asathyanesan/Neuroinjector/validation/verification_sheet.csv

region | pmid | ccf_region | region_verbatim | ap_mm | ml_mm | dv_mm | reference | atlas_ap | atlas_dv | quote_supports_numbers | coord_correct | is_outlier | outlier_reason | auto_verdict | reviewer_confirms | reviewer_notes | pubmed_url | pmc_url | source_quote | ml_mm_reparsed | ml_bilateral | ml_confidence | ml_candidates | ap_reparsed | dv_reparsed | reparse_flag | orig_ml_mm
ACB | 19303923 | nucleus accumbens, shell | lateral accumbens shell | 1.3 | 3.1 | -7.5 | bregma | 1.16 | 5.37 | partial(2/3) | review | TRUE | DV -12.9mm vs atlas | OUTLIER | y |  | https://pubmed.ncbi.nlm.nih.gov/19303923/ | https://www.ncbi.nlm.nih.gov/pmc/?term=19303923 | For subsequent experiments, cannulae were inserted bilaterally into the ventral tegmental area, caudate putamen, nucleus accumbens lateral shell or nucleus accumbens core. The following stereotaxic coordinates were utilized: lateral accumbens shell: A/P 1.3, M/L ±3.1, V −7.5; | 3.1 | yes | high | 3.1 | 1.3 |  | ML_recovered | 0
ACB | 19303923 | nucleus accumbens, core | nucleus accumbens core | 1.7 | 1.5 | -6.8 | bregma | 1.16 | 5.37 | partial(2/3) | review | TRUE | DV -12.2mm vs atlas | OUTLIER | y |  | https://pubmed.ncbi.nlm.nih.gov/19303923/ | https://www.ncbi.nlm.nih.gov/pmc/?term=19303923 | For subsequent experiments, cannulae were inserted bilaterally into the ventral tegmental area, caudate putamen, nucleus accumbens lateral shell or nucleus accumbens core. The following stereotaxic coordinates were utilized: nucleus accumbens core: A/P 1.7, M/L ±1.5, V −6.8; | 1.5 | yes | high | 1.5 | 1.7 |  | ML_recovered | 0
ACB | 20092560 | Nucleus accumbens, core | nucleus accumbens core (AcbC) | 1.4 | 1.26 | -4.2 | bregma | 1.16 | 5.37 | partial(2/3) | review | TRUE | DV -9.6mm vs atlas | OUTLIER | y |  | https://pubmed.ncbi.nlm.nih.gov/20092560/ | https://www.ncbi.nlm.nih.gov/pmc/?term=20092560 | one cannula was aimed at the nucleus accumbens core (AcbC) (from Bregma: anterior (A) + 1.40, lateral (L) ± 1.26, ventral (V) −4.2) while the second was aimed at the basolateral/central nuclei of the amygdala (BLA/CE) (from Bregma: A – 1.22, L ± 2.85, V – 4.5; Franklin, 2001 ) either ipsi- or contra-lateral to the first. | 1.26 | yes | disambig | 1.26|2.85 |  | -4.2 | ML_recovered_disambig | 0
ACB | 20856811 | Nucleus accumbens | nucleus accumbens | 1.7 | 0.75 | -4.75 | bregma | 1.16 | 5.37 | y | y | TRUE | DV z=10.4 | OUTLIER | n | dv_mm sign changed to -ve | https://pubmed.ncbi.nlm.nih.gov/20856811/ | https://www.ncbi.nlm.nih.gov/pmc/?term=20856811 | For restoration of Th gene function in the nucleus accumbens alone, recombinant CAV2-Cre virus (titered at 2.1×10 12 particles/ml) was injected bilaterally (coordinates in mm: 1.7 anterior to Bregma, 0.75 lateral to midline, 4.75 ventral to Bregma; 0.5 µl/hemisphere) into DD and control mice. | 0.75 |  | low |  |  | 4.75 |  | 0.75
ACB | 20962330 | Nucleus accumbens | NAcc | 1.3 | 0.9 | -4.7 | bregma | 1.16 | 5.37 | partial(2/3) | review | TRUE | DV -10.1mm vs atlas | OUTLIER | y |  | https://pubmed.ncbi.nlm.nih.gov/20962330/ | https://www.ncbi.nlm.nih.gov/pmc/?term=20962330 | After each mouse was placed in a stereotaxic frame, 1 μl of each virus (1×10 12 genomic particles) in PBS was injected into the NAcc (anteroposterior +1.3, mediolateral ±0.9, dorsoventral −4.7 from bregma) over 10 min using a 10-ml Hamilton syringe and an infusion pump (World Precision Instruments). | 0.9 | yes | high | 0.9 | 1.3 | -4.7 | ML_recovered | 0
ACB | 21508225 | Nucleus accumbens, core | nucleus accumbens (NAc) core | 1.2 | 1.5 | -6 | bregma | 1.16 | 5.37 | partial(2/3) | review | TRUE | DV -11.4mm vs atlas | OUTLIER | y |  | https://pubmed.ncbi.nlm.nih.gov/21508225/ | https://www.ncbi.nlm.nih.gov/pmc/?term=21508225 | A 26 gauge bilateral guide cannula (Plastics One, USA) was then implanted, targeting the nucleus accumbens (NAc) core or the NAc shell using the following coordinates (in mm from bregma); L=±1.5;V=−6.0 and AP=+1.2; L=±1.0;V=-5.8 respectively. | 1.5 | yes | disambig | 1|1.5 | 1.2 | -6 | ML_recovered_disambig | 0
ACB | 21508225 | Nucleus accumbens, shell | NAc shell | 1.2 | 1 | -5.8 | bregma | 1.16 | 5.37 | partial(2/3) | review | TRUE | DV -11.2mm vs atlas | OUTLIER | y |  | https://pubmed.ncbi.nlm.nih.gov/21508225/ | https://www.ncbi.nlm.nih.gov/pmc/?term=21508225 | A 26 gauge bilateral guide cannula (Plastics One, USA) was then implanted, targeting the nucleus accumbens (NAc) core or the NAc shell using the following coordinates (in mm from bregma); L=±1.5;V=−6.0 and AP=+1.2; L=±1.0;V=-5.8 respectively. | 1 | yes | disambig | 1|1.5 | 1.2 | -6 | ML_recovered_disambig; DV_diff(csv=-5.8,quote=6) | 0
ACB | 22082989 | Nucleus accumbens | nucleus accumbens | 1.3 | 1.3 | -4.4 | bregma | 1.16 | 5.37 | y | y | TRUE | DV z=10.0 | OUTLIER | n | dv_mm sign changed to -ve | https://pubmed.ncbi.nlm.nih.gov/22082989/ | https://www.ncbi.nlm.nih.gov/pmc/?term=22082989 | Bilateral injection: 0.5 μl was injected into nucleus accumbens at a 10° angle toward the mid-sagittal plane (coordinates in mm: 1.3 anterior, 1.3 lateral; 4.4 ventral to Bregma). All injections were at a rate of 0.1 μl per minute. | 1.3 |  | low |  |  | 4.4 |  | 1.3
ACB | 24847220 | Nucleus accumbens | NAC | 1.3 | 1 | -2.3 | bregma | 1.16 | 5.37 | partial(2/3) | review | TRUE | DV -7.7mm vs atlas | OUTLIER | y |  | https://pubmed.ncbi.nlm.nih.gov/24847220/ | https://www.ncbi.nlm.nih.gov/pmc/?term=24847220 | The animal's skull was exposed, leveled, and holes were drilled based on coordinates from Bregma for the mPFC (AP: +1.8 mm; DV: −1.0 mm) or NAC (AP: +1.3 mm, ML: ±1 mm, DV: −2.3 mm), according to the mouse brain atlas of Paxinos and Franklin ( 2007 ). The guide cannulae were lowered bilaterally such that the tips of the cannulae were 3 mm above the mPFC or border region of the shell and core subregions of the NAC. | 1 | yes | high | 1 | 1.8 | -1 | ML_recovered; AP_diff(csv=1.3,quote=1.8); DV_diff(csv=-2.3,quote=1) | 0
ACB | 25130590 | Nucleus accumbens, shell | nucleus accumbens shell [NACSH] | 1.1 | 0.5 | -4.5 | bregma | 1.16 | 5.37 | partial(2/3) | review | TRUE | DV -9.9mm vs atlas | OUTLIER | y |  | https://pubmed.ncbi.nlm.nih.gov/25130590/ | https://www.ncbi.nlm.nih.gov/pmc/?term=25130590 | Approximately 1 week after arrival, mice in Experiments 3 & 4 underwent surgery to implant bilateral 26-G guide cannulae aimed at the nucleus accumbens shell [NACSH; coordinates in reference to bregma, anterior-posterior (AP): + 1.1 mm; medial-lateral (ML) ± 0.5 mm; dorsal-ventral (DV): − 4.5 mm)] using the Angle II Sterotax (Leica Instruments). Vehicle or 22mM TSA was delivered bilaterally to the NACSH in a volume of 0.5 μl over a 2 min period. | 0.5 | yes | high | 0.5 |  |  | ML_recovered | 0
ACB | 26214370 | Nucleus accumbens, core | NAcore | 1.55 | 1 | -4.8 | bregma | 1.16 | 5.37 | y | review | TRUE | DV -10.2mm vs atlas | OUTLIER | y |  | https://pubmed.ncbi.nlm.nih.gov/26214370/ | https://www.ncbi.nlm.nih.gov/pmc/?term=26214370 | ChR2 was bilaterally infused (0.3 μl) at 0° angle into the NAcore (AP +1.55; ML ±1.00, DV −4.80) | 1 | yes | high | 1 | 1.55 | -4.8 | ML_recovered | 0
ACB | 26471420 | Nucleus accumbens | nucleus accumbens | 1.5 | 0.8 | -3.6 | bregma | 1.16 | 5.37 | y | y | TRUE | DV z=9.1 | OUTLIER | n | dv_mm sign changed to -ve | https://pubmed.ncbi.nlm.nih.gov/26471420/ | https://www.ncbi.nlm.nih.gov/pmc/?term=26471420 | Bilateral guide cannulas from Plastics One were implanted so the tip of the cannulas reached the nucleus accumbens (bregma coordinates: anterior, 1.5mm; mediolateral, 0.8mm; dorsoventral, 3.6mm) or ventral hippocampus (bregma coordinates: posterior, 3.2mm; mediolateral, 3.0mm; dorsoventral, 4.2mm). | 0.8 |  | low |  |  | 3.6 |  | 0.8
ACB | 28439227 | Nucleus accumbens | nucleus accumbens | 1.6 | 1 | -3.1 | bregma | 1.16 | 5.37 | partial(2/3) | review | TRUE | DV -8.5mm vs atlas | OUTLIER | y |  | https://pubmed.ncbi.nlm.nih.gov/28439227/ | https://www.ncbi.nlm.nih.gov/pmc/?term=28439227 | for nucleus accumbens coordinates were AP, +1.6; L, ±1; and DV, −3.1; from Bregma in accordance with the atlas of Paxinos and Franklin ( 2013 ). | 1 | yes | high | 1 | 1.6 | -3.1 | ML_recovered | 0
ACB | 29307710 | Nucleus accumbens, medial shell | Nucleus accumbens (NAc) medial shell (NAcMed) | 1.5 | 0.55 | -4.7 | bregma | 1.16 | 5.37 | y | review | TRUE | DV -10.1mm vs atlas | OUTLIER | y |  | https://pubmed.ncbi.nlm.nih.gov/29307710/ | https://www.ncbi.nlm.nih.gov/pmc/?term=29307710 | For red/green fluorescent retrobead labeling, mice were injected unilaterally with fluorescent retrobeads (100 nl; LumaFluor Inc.) in the Nucleus accumbens (NAc) medial shell (NAcMed, bregma: 1.50 mm, lateral: 0.55 mm, ventral: −4.70 mm) and/or NAc lateral shell (NAcLat, bregma: 0.98 mm, lateral: 1.80 mm, ventral: −4.92 mm) using a 1 μl Hamilton syringe (Hamilton). | 0.55 |  | low |  |  | -4.7 |  | 0.55
ACB | 29307710 | Nucleus accumbens, lateral shell | NAc lateral shell (NAcLat) | 0.98 | 1.8 | -4.92 | bregma | 1.16 | 5.37 | y | review | TRUE | DV -10.3mm vs atlas | OUTLIER | y |  | https://pubmed.ncbi.nlm.nih.gov/29307710/ | https://www.ncbi.nlm.nih.gov/pmc/?term=29307710 | For red/green fluorescent retrobead labeling, mice were injected unilaterally with fluorescent retrobeads (100 nl; LumaFluor Inc.) in the Nucleus accumbens (NAc) medial shell (NAcMed, bregma: 1.50 mm, lateral: 0.55 mm, ventral: −4.70 mm) and/or NAc lateral shell (NAcLat, bregma: 0.98 mm, lateral: 1.80 mm, ventral: −4.92 mm) using a 1 μl Hamilton syringe (Hamilton). | 0.55 |  | low |  |  | -4.7 | ML_mismatch(csv=1.8,quote=0.55); DV_diff(csv=-4.92,quote=4.7) | 1.8
ACB | 29458998 | Nucleus accumbens | nucleus accumbens (NAc) | 1.65 | 0.92 | -4.8 | bregma | 1.16 | 5.37 | y | y | TRUE | DV z=10.5 | OUTLIER | n | dv_mm sign changed to -ve | https://pubmed.ncbi.nlm.nih.gov/29458998/ | https://www.ncbi.nlm.nih.gov/pmc/?term=29458998 | AAV5.CMV.HI.eGFP.Cre.WPRE.SV40 (AAV-Cre; titer 2 × 10 13 GC/ml) or AAV5.CMV.PI.eGFP.WPRE.bGH (AAV-GFP; titer 7 × 10 13 GC/ml) were injected bilaterally into the dorsal striatum (500 nl, AP: 0.62, ML: 1.90, DV: 3.00) or nucleus accumbens (NAc; 450 nl, AP: 1.65, ML: 0.92, DV: 4.80). | 1.9 |  | low |  | 0.62 | 3 | ML_mismatch(csv=0.92,quote=1.9); AP_diff(csv=1.65,quote=0.62); DV_diff(csv=4.8,quote=3) | 0.92
ACB | 29477921 | Nucleus accumbens, core | NAc core | 1.2 | 1 | -4.5 | bregma | 1.16 | 5.37 | y | y | TRUE | DV z=10.1 | OUTLIER | n | dv_mm sign changed to -ve | https://pubmed.ncbi.nlm.nih.gov/29477921/ | https://www.ncbi.nlm.nih.gov/pmc/?term=29477921 | A ten-microliter syringe (Hamilton, Reno, NV) was used to deliver 1μL of LV (4.1 × 10 7 to 5.3 × 10 9 IU/mL) to each NAc (bregma coordinates: anteriorposterior 1.2 mm; mediolateral 1.0 mm; dorsoventral 4.5 mm) at a rate of 0.1 μL/min. Second, to gain insights into the changes in ethanol intake, we employed a lentivirus-shRNA (LV-shRNA) methodology to selectively knockdown P2X4R expression in the nucleus accumbens (NAc) core in male C57BL/6J mice. | 1 |  | low |  | 1.2 | 4.5 |  | 1
ACB | 31660086 | Nucleus accumbens | NAc | 1.54 | 0.8 | -3.9 | bregma | 1.16 | 5.37 | partial(2/3) | review | TRUE | DV -9.3mm vs atlas | OUTLIER | y | "0.5 mm above the Nac" | https://pubmed.ncbi.nlm.nih.gov/31660086/ | https://www.ncbi.nlm.nih.gov/pmc/?term=31660086 | Then, mice were bilaterally implanted with 26-gauge guide cannulae (RWD Life Science Co., Ltd.) located 0.5 mm above the NAc at the following coordinates: anteroposterior (AP), +1.54 mm; mediolateral (ML), ±0.80 mm; dorsoventral (DV), -3.90 mm. NSC23766 (10 µg/μl, 1 µl/side), CN04 (424 nmol/ml, 1 µl/side) or vehicle (1 µl/side) was infused into the bilateral NAc at… | 0.8 | yes | high | 0.8 | 1.54 | -3.9 | ML_recovered | 0
ACB | 31668382 | Nucleus accumbens | rostral accumbens | 1.6 | 0.6 | -4.25 | bregma | 1.16 | 5.37 | partial(1/3) | review | TRUE | DV -9.9mm vs atlas | OUTLIER | n | multiple bregma locations disentangled and corrected | https://pubmed.ncbi.nlm.nih.gov/31668382/ | https://www.ncbi.nlm.nih.gov/pmc/?term=31668382 | We bilaterally delivered a total of 800 nl (400 nl per hemisphere) of an adeno-associated viral vector (University of North Carolina Gene Therapy Center, Chapel Hill, NC) encoding either Cre recombinase-mCherry (AAV8-hSyn-CRE-mCherry, 2.8 × 10 12 genomic copies/ml) or mCherry only (AAV8-hSyn-mCherry, 8.0 × 10 12 genomic copies/ml) to the rostral (anteroposterior (AP) +1.60, mediolateral (ML) ±0.60 and ± 1.40, dorsoventral (DV) −4.25 and −4.75) and caudal accumbens (AP +1.20, ML ±0.60 and ± 1.50, DV –4.30 and −4.80) using mouse atlas coordinates [27] . | 0.6 | yes | disambig | 0.6|1.4|1.5 | 1.6 | -4.25 | ML_mismatch(csv=1,quote=0.6); DV_diff(csv=-4.5,quote=4.25) | 1
ACB | 31668382 | Nucleus accumbens | rostral accumbens | 1.6 | 1.4 | -4.75 | bregma | 1.16 | 5.37 | partial(1/3) | review | TRUE | DV -9.9mm vs atlas | OUTLIER | n | multiple bregma locations disentangled and corrected | https://pubmed.ncbi.nlm.nih.gov/31668382/ | https://www.ncbi.nlm.nih.gov/pmc/?term=31668382 | We bilaterally delivered a total of 800 nl (400 nl per hemisphere) of an adeno-associated viral vector (University of North Carolina Gene Therapy Center, Chapel Hill, NC) encoding either Cre recombinase-mCherry (AAV8-hSyn-CRE-mCherry, 2.8 × 10 12 genomic copies/ml) or mCherry only (AAV8-hSyn-mCherry, 8.0 × 10 12 genomic copies/ml) to the rostral (anteroposterior (AP) +1.60, mediolateral (ML) ±0.60 and ± 1.40, dorsoventral (DV) −4.25 and −4.75) and caudal accumbens (AP +1.20, ML ±0.60 and ± 1.50, DV –4.30 and −4.80) using mouse atlas coordinates [27] . | 0.6 | yes | disambig | 0.6|1.4|1.5 | 1.6 | -4.25 | ML_mismatch(csv=1,quote=0.6); DV_diff(csv=-4.5,quote=4.25) | 1
ACB | 31668382 | Nucleus accumbens | caudal accumbens | 1.2 | 0.6 | -4.3 | bregma | 1.16 | 5.37 | partial(1/3) | review | TRUE | DV -9.9mm vs atlas | OUTLIER | n | multiple bregma locations disentangled and corrected | https://pubmed.ncbi.nlm.nih.gov/31668382/ | https://www.ncbi.nlm.nih.gov/pmc/?term=31668382 | We bilaterally delivered a total of 800 nl (400 nl per hemisphere) of an adeno-associated viral vector (University of North Carolina Gene Therapy Center, Chapel Hill, NC) encoding either Cre recombinase-mCherry (AAV8-hSyn-CRE-mCherry, 2.8 × 10 12 genomic copies/ml) or mCherry only (AAV8-hSyn-mCherry, 8.0 × 10 12 genomic copies/ml) to the rostral (anteroposterior (AP) +1.60, mediolateral (ML) ±0.60 and ± 1.40, dorsoventral (DV) −4.25 and −4.75) and caudal accumbens (AP +1.20, ML ±0.60 and ± 1.50, DV –4.30 and −4.80) using mouse atlas coordinates [27] . | 0.6 | yes | disambig | 0.6|1.4|1.5 | 1.6 | -4.25 | ML_mismatch(csv=1.05,quote=0.6); AP_diff(csv=1.2,quote=1.6); DV_diff(csv=-4.55,quote=4.25) | 1.05
ACB | 31668382 | Nucleus accumbens | caudal accumbens | 1.2 | 1.5 | -4.8 | bregma | 1.16 | 5.37 | partial(1/3) | review | TRUE | DV -9.9mm vs atlas | OUTLIER | n | multiple bregma locations disentangled and corrected | https://pubmed.ncbi.nlm.nih.gov/31668382/ | https://www.ncbi.nlm.nih.gov/pmc/?term=31668382 | We bilaterally delivered a total of 800 nl (400 nl per hemisphere) of an adeno-associated viral vector (University of North Carolina Gene Therapy Center, Chapel Hill, NC) encoding either Cre recombinase-mCherry (AAV8-hSyn-CRE-mCherry, 2.8 × 10 12 genomic copies/ml) or mCherry only (AAV8-hSyn-mCherry, 8.0 × 10 12 genomic copies/ml) to the rostral (anteroposterior (AP) +1.60, mediolateral (ML) ±0.60 and ± 1.40, dorsoventral (DV) −4.25 and −4.75) and caudal accumbens (AP +1.20, ML ±0.60 and ± 1.50, DV –4.30 and −4.80) using mouse atlas coordinates [27] . | 0.6 | yes | disambig | 0.6|1.4|1.5 | 1.6 | -4.25 | ML_mismatch(csv=1.05,quote=0.6); AP_diff(csv=1.2,quote=1.6); DV_diff(csv=-4.55,quote=4.25) | 1.05
ACB | 31954621 | Nucleus accumbens, core | NAc core astrocytes | 1.5 | 0.75 | -4.5 | bregma | 1.16 | 5.37 | partial(2/3) | review | TRUE | DV -9.9mm vs atlas | OUTLIER | y |  | https://pubmed.ncbi.nlm.nih.gov/31954621/ | https://www.ncbi.nlm.nih.gov/pmc/?term=31954621 | Viral vectors (0.5 μl-1 μl) were injected bilaterally using a Hamilton syringe attached to a 29-gauge needle at a rate of 0.8–1.25 μl/min. The viral constructs AAV8-GFAP-hM3D(Gq)-mCherry (UNC vector core), AAV8-GFAP-mCherry (UMN vector core), AAV5-GfaABC1D-PI-LckGCaMP6.SV40 (Penn Vector Core), or AAV5-GfaABC1D-cytoGCaMP6f-SV40 (Penn Vector Core) were targeted to NAc core astrocytes (anterior-poste- rior[AP]: +1.50 mm; medial-lateral [ML]: +/− 0.75 mm; dorsal-ventral [DV]: −4.50 mm) of C57BL/6J. | 0.75 | yes | high | 0.75 | 1.5 | -4.5 | ML_recovered | 0
ACB | 32187537 | Nucleus accumbens shell | Nucleus accumbens (medial shell) | 1.1 | 0.9 | -4.6 | bregma | 1.16 | 5.37 | y | review | TRUE | DV -10.0mm vs atlas | OUTLIER | y |  | https://pubmed.ncbi.nlm.nih.gov/32187537/ | https://www.ncbi.nlm.nih.gov/pmc/?term=32187537 | AP, ML and DV were measured relative to bregma, and craniotomies were drilled over the injection sites. Viruses were injected with a Nanoject II (Drummond Scientific) at a rate of 13.8 nL every 10 s. The following coordinates (in mm) were used: Injection site ML AP DV Nucleus accumbens (medial shell): 0.9 +1.1 −4.6 |  |  | none |  |  |  |  | 0.9
ACB | 32313025 | Nucleus accumbens | NAc | 1.3 | 1.3 | -4.5 | bregma | 1.16 | 5.37 | partial(2/3) | review | TRUE | DV -9.9mm vs atlas | OUTLIER | y |  | https://pubmed.ncbi.nlm.nih.gov/32313025/ | https://www.ncbi.nlm.nih.gov/pmc/?term=32313025 | Following anesthesia with pentobarbital (30 mg kg −1 ), we performed bilateral stereotaxic injections of AAV-GFP or AAV-GFP-Cre (2.6 × 10 9 GS per injection) in the NAc at the following coordinates 64 from the bregma (millimeters), anteroposterior, 1.3, lateral, ±1.3, and dorsoventral, −4.5 | 1.3 | yes | high | 1.3 | 1.3 | -4.5 | ML_recovered | 0
CA1 | 21228185 | Field CA1, dorsal part | dorsal CA1 area of the hippocampus | -2 | 1.5 | -1.5 | bregma | -2.66 | 2.61 | partial(2/3) | review | TRUE | DV -4.1mm vs atlas | OUTLIER | y |  | https://pubmed.ncbi.nlm.nih.gov/21228185/ | https://www.ncbi.nlm.nih.gov/pmc/?term=21228185 | Virus (1.0 μl) was injected at a rate of 6 μl/h via an infusion needle positioned in the dorsal CA1 area of the hippocampus [anteroposterior (AP), −2.0 mm; mediolateral (ML), ±1.5 mm; dorsoventral (DV), −1.5 mm]. | 1.5 | yes | high | 1.5 | -2 | -1.5 | ML_recovered | 0
CA1 | 24656815 | Field CA1 | dorsal hippocampal CA1 | -1.94 | 1.4 | -1.35 | bregma | -2.66 | 2.61 | y | review | TRUE | DV -4.0mm vs atlas | OUTLIER | y |  | https://pubmed.ncbi.nlm.nih.gov/24656815/ | https://www.ncbi.nlm.nih.gov/pmc/?term=24656815 | The coordinates targeting dorsal hippocampal CA1 were anteroposterior −1.94 mm, lateromedial −1.40 mm; dorsoventral −1.35 mm. A total of 0.1 ul of the helper virus (AAV8-EF1α-FLEX-HB, ~2 × 10 11 genome units per ml) was injected into each brain. After 3 weeks of the AAV injection, the pseudotyped, RG-deleted rabies virus (EnvA-SADΔG-mCherry, 0.1 ul, ~2 × 10 9 infectious units per ml) was injected into the same location of the previous injection. |  |  | none |  | -1.94 | -1.35 |  | 1.4
CA1 | 25043327 | Field CA1 | Dorsal CA1 | -2 | 1.6 | -1.7 | bregma | -2.66 | 2.61 | partial(2/3) | review | TRUE | DV -4.3mm vs atlas | OUTLIER | y |  | https://pubmed.ncbi.nlm.nih.gov/25043327/ | https://www.ncbi.nlm.nih.gov/pmc/?term=25043327 | 1μl of virus (titered at 1.45e13 vg/mL) was injected on each side of the hippocampus at a rate of 0.06 μl/min using the following coordinates: Dorsal CA1: anterioposterior: −2.0mm from bregma, lateral: ±1.6mm, ventral: −1.7mm and/or Ventral CA1: anterioposterior: −2.5mm from bregma, lateral: ± 2.5mm, ventral: −1.75mm using a stereotaxic frame (BENCHmark). | 1.6 | yes | disambig | 1.6|2.5 |  | -1.7 | ML_recovered_disambig | 0
CA1 | 25043327 | Field CA1 | Ventral CA1 | -2.5 | 1.6 | -1.75 | bregma | -2.66 | 2.61 | partial(2/3) | review | TRUE | DV -4.4mm vs atlas | OUTLIER | y |  | https://pubmed.ncbi.nlm.nih.gov/25043327/ | https://www.ncbi.nlm.nih.gov/pmc/?term=25043327 | 1μl of virus (titered at 1.45e13 vg/mL) was injected on each side of the hippocampus at a rate of 0.06 μl/min using the following coordinates: Dorsal CA1: anterioposterior: −2.0mm from bregma, lateral: ±1.6mm, ventral: −1.7mm and/or Ventral CA1: anterioposterior: −2.5mm from bregma, lateral: ± 2.5mm, ventral: −1.75mm using a stereotaxic frame (BENCHmark). | 1.6 | yes | disambig | 1.6|2.5 |  | -1.7 | ML_recovered_disambig | 0
CA1 | 25793741 | Field CA1, ventral part | vHP | -8.7 | 2 | -3.5 | bregma | -2.66 | 2.61 | y | review | TRUE | AP z=-16.9; AP -6.0mm vs atlas | OUTLIER | n | reject since this was a unique procedure from a weird angle at the back of the brain | https://pubmed.ncbi.nlm.nih.gov/25793741/ | https://www.ncbi.nlm.nih.gov/pmc/?term=25793741 | For illumination at the vHP, through a craniotomy (AP −8.7, ML −2.0, DV +3.5 in mm), an optical fiber w… | 2 |  | low |  | -8.7 | 3.5 |  | 2
CA1 | 26275606 | Field CA1 | CA1 area (stratum pyramidale) of hippocampus | -2 | 2.6 | -1.9 | bregma | -2.66 | 2.61 | y | review | TRUE | DV -4.5mm vs atlas | OUTLIER | y |  | https://pubmed.ncbi.nlm.nih.gov/26275606/ | https://www.ncbi.nlm.nih.gov/pmc/?term=26275606 | The stereotaxic injections of AAV1-mSTIM2 virus or Aβ42 oligomers in CA1 area (stratum pyramidale) of hippocampus were performed as described previously [ 10 ]. Mice were injected with 5 ul of Aβ42-Alexa555 oligomer, prepared as described above. Additionally, 1 μl of AAV1-mSTIM2 virus was injected each side. For bilateral hippocampus injection, the Hamilton injection syringes were positioned at a 10 ° angle on both sides and the optimal injection coordinates (from bregma) were anterior/posterior (AP) -2.0 mm, lateral +2.6 mm, dorsal/ventral-1.9 mm. | 2.6 |  | low |  | -2 | -1.9 |  | 2.6
CA1 | 27924869 | Field CA1 | hippocampal CA1 | -2.06 | 1.65 | -0.3 | bregma | -2.66 | 2.61 | y | review | TRUE | DV -2.9mm vs atlas | OUTLIER | y | "0.50 mm above the targeted region" - cannula guide placement | https://pubmed.ncbi.nlm.nih.gov/27924869/ | https://www.ncbi.nlm.nih.gov/pmc/?term=27924869 | Animals anaesthetized with 1% pentobarbital sodium and placed in a stereotaxic apparatus (RWD Life Science) were implanted bilaterally with a 26-Gauge guide cannula aimed at 0.50 mm above the targeted region on each side following the coordinates 64 below: insular cortex: anteroposterior, +0.98 mm; lateral, ±3.55 mm; dorsoventral, –3.20 mm; hippocampal CA1: anteroposterior, –2.06 mm; lateral, ±1.65 mm; dorsoventral, –0.30 mm. | 1.65 | yes | disambig | 1.65|3.55 | 0.98 | -3.2 | AP_diff(csv=-2.06,quote=0.98); DV_diff(csv=-0.3,quote=3.2) | 1.65
CA1 | 28486943 | Field CA1 | right and left dorsal hippocampal CA1 region | -3.3 | 2 | -2.6 | bregma | -2.66 | 2.61 | partial(2/3) | review | TRUE | DV -5.2mm vs atlas | OUTLIER | y |  | https://pubmed.ncbi.nlm.nih.gov/28486943/ | https://www.ncbi.nlm.nih.gov/pmc/?term=28486943 | According to Paxinos and Watson [ 60 ] and considering Bregma point as a reference, one stainless steel guide cannula (22 Gauge and 13 mm of length) was settled in the right lateral ventricle (RLV; Coordinates in mm: Anteroposterior (AP): −0.8, Lateral (L): −1.4, and Ventral (V): −0.5), and four copper electrodes (250 μm of diameter) were positioned in the right and left dorsal hippocampal CA1 region (Coordinates in mm: AP: −3.3, L: ±2, and V: −2.6)... | 2 | yes | high | 2 | -0.8 | -0.5 | ML_recovered; AP_diff(csv=-3.3,quote=-0.8); DV_diff(csv=-2.6,quote=0.5) | 0
CA1 | 30405352 | Field CA1 | CA1 region of dorsal hippocampus | -1.8 | 1 | -1.4 | bregma | -2.66 | 2.61 | y | review | TRUE | DV -4.0mm vs atlas | OUTLIER | y |  | https://pubmed.ncbi.nlm.nih.gov/30405352/ | https://www.ncbi.nlm.nih.gov/pmc/?term=30405352 | The skull was exposed and four holes were drilled above the CA1 region of dorsal hippocampus, according to the following coordinates: AP -1.8 mm, ML ± 1 mm, DV -1.4 mm from bregma and AP -2.5 mm, ML ± 2 mm, DV -1.7 mm from bregma. High titers (1.3 × 10 13 GC/ml, Vector Biolabs) adeno-associated virus (AAV) engineered to overexpress Kcnmb2 (AAV1-hSYN1- mKcnmb2 -IRES-GFP-WPRE, AAV-Kcnmb2) or control virus (AAV1-hSYN1-GFP-WPRE, AAV-control) were stereotaxically injected into the dorsal CA1 region with Nanoliter 2010 (WPI) at a flow rate of 0.05 μl/min and a volume of 0.3 μl per injection site. | 1 | yes | disambig | 1|2 | -1.8 | -1.4 | ML_recovered_disambig | 0
CA1 | 30405352 | Field CA1 | CA1 region of dorsal hippocampus | -2.5 | 2 | -1.7 | bregma | -2.66 | 2.61 | y | review | TRUE | DV -4.3mm vs atlas | OUTLIER | y |  | https://pubmed.ncbi.nlm.nih.gov/30405352/ | https://www.ncbi.nlm.nih.gov/pmc/?term=30405352 | The skull was exposed and four holes were drilled above the CA1 region of dorsal hippocampus, according to the following coordinates: AP -1.8 mm, ML ± 1 mm, DV -1.4 mm from bregma and AP -2.5 mm, ML ± 2 mm, DV -1.7 mm from bregma. High titers (1.3 × 10 13 GC/ml, Vector Biolabs) adeno-associated virus (AAV) engineered to overexpress Kcnmb2 (AAV1-hSYN1- mKcnmb2 -IRES-GFP-WPRE, AAV-Kcnmb2) or control virus (AAV1-hSYN1-GFP-WPRE, AAV-control) were stereotaxically injected into the dorsal CA1 region with Nanoliter 2010 (WPI) at a flow rate of 0.05 μl/min and a volume of 0.3 μl per injection site. | 2 | yes | disambig | 1|2 | -1.8 | -1.4 | ML_recovered_disambig; AP_diff(csv=-2.5,quote=-1.8); DV_diff(csv=-1.7,quote=1.4) | 0
CA1 | 31937327 | Field CA1 | CA1 area of the hippocampus | -2.7 | 2.5 | -1.75 | bregma | -2.66 | 2.61 | partial(2/3) | review | TRUE | DV -4.4mm vs atlas | OUTLIER | y |  | https://pubmed.ncbi.nlm.nih.gov/31937327/ | https://www.ncbi.nlm.nih.gov/pmc/?term=31937327 | Craniotomies were made bilaterally to target CA1 area of the hippocampus for viral injections (from bregma: anteroposterior − 2.70 mm, lateral ± 2.50 mm, and dorsoventral − 1.75 mm or anteroposterior − 2.56 mm, lateral ± 2.6 mm, and dorsoventral − 1.85 mm). One microliter of each virus suspension was injected into the CA1 area of the hippocampus at a rate of 0.15 μl/min through a Hamilton syringe using a motorized stereotaxic injector (Stoetling Co.). | 2.5 | yes | disambig | 2.5|2.6 |  |  | ML_recovered_disambig | 0
CA1 | 31937327 | Field CA1 | CA1 area of the hippocampus | -2.56 | 2.6 | -1.85 | bregma | -2.66 | 2.61 | partial(2/3) | review | TRUE | DV -4.5mm vs atlas | OUTLIER | y |  | https://pubmed.ncbi.nlm.nih.gov/31937327/ | https://www.ncbi.nlm.nih.gov/pmc/?term=31937327 | Craniotomies were made bilaterally to target CA1 area of the hippocampus for viral injections (from bregma: anteroposterior − 2.70 mm, lateral ± 2.50 mm, and dorsoventral − 1.75 mm or anteroposterior − 2.56 mm, lateral ± 2.6 mm, and dorsoventral − 1.85 mm). One microliter of each virus suspension was injected into the CA1 area of the hippocampus at a rate of 0.15 μl/min through a Hamilton syringe using a motorized stereotaxic injector (Stoetling Co.). | 2.6 | yes | disambig | 2.5|2.6 |  |  | ML_recovered_disambig | 0
CA1 | 32169587 | Field CA1 | CA1 and Dentate Gyrus (DG) of the dorsal hippocampus | -2.2 | 2.5 | -2.1 | bregma | -2.66 | 2.61 | y | review | TRUE | DV -4.7mm vs atlas | OUTLIER | y |  | https://pubmed.ncbi.nlm.nih.gov/32169587/ | https://www.ncbi.nlm.nih.gov/pmc/?term=32169587 | Thirty gauge needles (Hamilton Company) were bilaterally placed using two sets of stereotaxic coordinates that both target the CA1 and Dentate Gyrus (DG) of the dorsal hippocampus ( Fig 1A ). 10° angle from the midline −2.2 mm anteroposterior, +/− 2.5 mm mediolateral. Purified high-tilter virus (0.6 μL) was infused separately (0.3 μL/infusion) over 5 min periods at two sites: −2.1 mm dorsoventral (DV) and −1.9 mm DV. | 2.5 | yes | high | 2.5 | 2.5 | -2.1 | AP_diff(csv=-2.2,quote=2.5) | 2.5
CA1 | 32169587 | Field CA1 | CA1 and Dentate Gyrus (DG) of the dorsal hippocampus | -2.2 | 2.5 | -1.9 | bregma | -2.66 | 2.61 | y | review | TRUE | DV -4.5mm vs atlas | OUTLIER | y |  | https://pubmed.ncbi.nlm.nih.gov/32169587/ | https://www.ncbi.nlm.nih.gov/pmc/?term=32169587 | Thirty gauge needles (Hamilton Company) were bilaterally placed using two sets of stereotaxic coordinates that both target the CA1 and Dentate Gyrus (DG) of the dorsal hippocampus ( Fig 1A ). 10° angle from the midline −2.2 mm anteroposterior, +/− 2.5 mm mediolateral. Purified high-tilter virus (0.6 μL) was infused separately (0.3 μL/infusion) over 5 min periods at two sites: −2.1 mm dorsoventral (DV) and −1.9 mm DV. | 2.5 | yes | high | 2.5 | 2.5 | -2.1 | AP_diff(csv=-2.2,quote=2.5); DV_diff(csv=-1.9,quote=2.1) | 2.5
CA1 | 32344594 | Field CA1 | CA1 | -1.9 | -1.4 | -1.3 | bregma | -2.66 | 2.61 | y | review | TRUE | DV -3.9mm vs atlas | OUTLIER | n | the -ve sign was missing from ml; only left (-ve coord) was included | https://pubmed.ncbi.nlm.nih.gov/32344594/ | https://www.ncbi.nlm.nih.gov/pmc/?term=32344594 | 500 nl of rAAV viral particles (carrying AAV- CAG -NES-FGCaMP7) was injected through a 50 µm tip diameter glass micropipette (Wiretrol I, 5-000-1001, Drummond, Broomall, PA, USA) into two areas of the hippocampus: CA1 (left hemisphere; stereotaxic coordinates:−1.9 mm A/P from bregma, −1.4 mm M/L, −1.3 mm D/V) or DG (left hemisphere: stereotaxic coordinates: −2.0 mm A/P from bregma, −1.6 mm M/L, −2.0 D/V). Microinjections were performed using UltraMicroPump with Micro4 Controller (WPI Inc., Sarasota, IL, USA) at a rate of 100 nl/min. | 1.3 |  | low |  | -1.9 | -1.3 | ML_mismatch(csv=1.4,quote=1.3) | 1.4
CP | 18938225 | Striatum | striatum | 0.65 | 2 | -3 | bregma | 0.06 | 4.88 | y | y | TRUE | DV z=7.3 | OUTLIER | y |  | https://pubmed.ncbi.nlm.nih.gov/18938225/ | https://www.ncbi.nlm.nih.gov/pmc/?term=18938225 | In some groups, guide cannulae (CMA/7, North Chelmsford, MA) were implanted into the striatum (coordinates from Bregma: A = 0.65 mm, L = ± 2.00 mm and V= 3.00 mm ( Franklin and Paxinos, 1997 ). | 2 | yes | high | 2 | 0.65 | 3 |  | 2
CP | 19303923 | caudoputamen | caudate putamen | 1.2 | 2.4 | -4.7 | bregma | 0.06 | 4.88 | partial(2/3) | review | TRUE | DV -9.6mm vs atlas | OUTLIER | y |  | https://pubmed.ncbi.nlm.nih.gov/19303923/ | https://www.ncbi.nlm.nih.gov/pmc/?term=19303923 | For subsequent experiments, cannulae were inserted bilaterally into the ventral tegmental area, caudate putamen, nucleus accumbens lateral shell or nucleus accumbens core. The following stereotaxic coordinates were utilized: caudate putamen: A/P 1.2, M/L ±2.4, V −4.7; Bilateral administration of CXCL12 (25 ng/0.5 microl) into the ventral tegmental area 15 min prior to cocaine (20 mg/kg i.p.) significantly potentiated cocaine-induced ambulatory activity, whereas microinjections of CXCL12 into the caudate putamen selectively increased stereotypy. | 2.4 | yes | high | 2.4 | 1.2 |  | ML_recovered | 0
CP | 22073284 | Caudoputamen | dorsal striatum | 0.7 | 3 | -4.5 | bregma | 0.06 | 4.88 | partial(2/3) | review | TRUE | DV -9.4mm vs atlas | OUTLIER | y |  | https://pubmed.ncbi.nlm.nih.gov/22073284/ | https://www.ncbi.nlm.nih.gov/pmc/?term=22073284 | A single stainless steel cannula (28-gauge, Plastics One Inc., Reannex, VI) was first stereotaxically implanted in the dorsal striatum (B: 0.7 mm, L: 3.0 mm, V: −4.5 mm). At least 30 min after implantation, each rat received an intrastriatal infusion (0.1 µl/min for 10 min) of either vehicle (0.5% DMSO in aCSF) or ODQ (50 µM) and all cannula were left in place for 5 min after completion of the microinjection. Histological examination of cannula tracks revealed that all intrastriatal microinjections were within the dorsal striatum, between 0.7 to −0.3 mm from bregma (see Methods for details). | 3 |  | low |  |  | -4.5 |  | 3
CP | 22082989 | Striatum ventral region | ventral striatum | 0.75 | 1.75 | -4.25 | bregma | 0.06 | 4.88 | y | y | TRUE | DV z=8.9 | OUTLIER | n | all dv -ve | https://pubmed.ncbi.nlm.nih.gov/22082989/ | https://www.ncbi.nlm.nih.gov/pmc/?term=22082989 | Unilateral double injection (either right or left): 0.5 μl and 0.75 μl were injected into the ventral and dorsal striatum (coordinates in mm: 0.75 anterior, 1.75 lateral; 4.25 and 3.00 ventral to Bregma). All injections were at a rate of 0.1 μl per minute. | 1.75 |  | low |  |  | 3 | DV_diff(csv=4.25,quote=3) | 1.75
CP | 22082989 | Caudoputamen | dorsal striatum | 0.75 | 1.75 | -3 | bregma | 0.06 | 4.88 | y | y | TRUE | DV z=7.3 | OUTLIER | n | all dv -ve | https://pubmed.ncbi.nlm.nih.gov/22082989/ | https://www.ncbi.nlm.nih.gov/pmc/?term=22082989 | Unilateral double injection (either right or left): 0.5 μl and 0.75 μl were injected into the ventral and dorsal striatum (coordinates in mm: 0.75 anterior, 1.75 lateral; 4.25 and 3.00 ventral to Bregma). All injections were at a rate of 0.1 μl per minute. | 1.75 |  | low |  |  | 3 |  | 1.75
CP | 22902719 | Dorsomedial striatum | dorsomedial striatum | 0.75 | 1.5 | -3 | bregma | 0.06 | 4.88 | partial(2/3) | review | TRUE | DV -7.9mm vs atlas | OUTLIER | y |  | https://pubmed.ncbi.nlm.nih.gov/22902719/ | https://www.ncbi.nlm.nih.gov/pmc/?term=22902719 | Animals were placed in a stereotaxic frame and 26-gauge microinjection needles were inserted through a burr hole bilaterally into the dorsomedial striatum (coordinates from bregma: anterior 0.75, medial-lateral ±1.5, ventral −3.0 mm) of D1/D2-Cre mice to deliver 1.0 μL of either AAV-EF1-DIO-ChR2(H124R)-eYFP or AAV-EF1-DIO-eYFP ~1012 IU/mL). Injections were performed using a 1 μL Hamilton syringe through a hydraulic pump (Harvard Instruments) and took place over 10 min followed by 10 min of recovery. | 1.5 | yes | high | 1.5 |  | -3 | ML_recovered | 0
CP | 24411738 | Dorsomedial striatum | mediodorsal striatum | 1.3 | 1.4 | -3.2 | bregma | 0.06 | 4.88 | partial(2/3) | review | TRUE | DV -8.1mm vs atlas | OUTLIER | y |  | https://pubmed.ncbi.nlm.nih.gov/24411738/ | https://www.ncbi.nlm.nih.gov/pmc/?term=24411738 | Viruses were bilaterally delivered at an average rate of 100 nl/min using glass pipettes (10–15 µm). Two sites of injections were used into the mediodorsal striatum to allow for a broad expression (site A: AP +1.3, ML ± 1.4, DV −3.2; site B: AP +0.8, ML ± 2.0, DV −3.4). 0.4–0.5 µl of AAV2/1-cmv-Kir2.1 AAA -ires-HRGFP, AAV2/1-cmv-HRGFP, AAV2/1-syn-DIO-Kir2.1 AAA -ires-mCherry and AAV2-ef1α-DIO-mCherry, and 0.5–1.0 µl of AAV2/1-cmv-Kir2.1 Wt -ires-HRGFP (lower titer) were injected per site. | 1.4 | yes | disambig | 1.4|2 | 1.3 | -3.2 | ML_recovered_disambig | 0
CP | 24411738 | Dorsomedial striatum | mediodorsal striatum | 0.8 | 2 | -3.4 | bregma | 0.06 | 4.88 | partial(2/3) | review | TRUE | DV -8.3mm vs atlas | OUTLIER | y |  | https://pubmed.ncbi.nlm.nih.gov/24411738/ | https://www.ncbi.nlm.nih.gov/pmc/?term=24411738 | Viruses were bilaterally delivered at an average rate of 100 nl/min using glass pipettes (10–15 µm). Two sites of injections were used into the mediodorsal striatum to allow for a broad expression (site A: AP +1.3, ML ± 1.4, DV −3.2; site B: AP +0.8, ML ± 2.0, DV −3.4). 0.4–0.5 µl of AAV2/1-cmv-Kir2.1 AAA -ires-HRGFP, AAV2/1-cmv-HRGFP, AAV2/1-syn-DIO-Kir2.1 AAA -ires-mCherry and AAV2-ef1α-DIO-mCherry, and 0.5–1.0 µl of AAV2/1-cmv-Kir2.1 Wt -ires-HRGFP (lower titer) were injected per site. | 2 | yes | disambig | 1.4|2 | 1.3 | -3.2 | ML_recovered_disambig; AP_diff(csv=0.8,quote=1.3); DV_diff(csv=-3.4,quote=3.2) | 0
CP | 25597650 | Dorsolateral striatum | dorsolateral striatum (DLS) | 0.5 | -2.2 | -3.2 | bregma | 0.06 | 4.88 | y | review | TRUE | DV -8.1mm vs atlas | OUTLIER | n | only left side (-ve coord) was done | https://pubmed.ncbi.nlm.nih.gov/25597650/ | https://www.ncbi.nlm.nih.gov/pmc/?term=25597650 | subsequent experiments focused on three regions: AP+0.5, L −2.2, V −3.2 for dorsolateral striatum (DLS); AP+0.4, L −1.7, V −3.5 for central striatum (CES); or AP-0.1, L −2.0, V −1.5 for sensorimotor cortex (Cx) (all refer to the tip of injection cannula; see Figure 1A ). |  |  | none |  | 0.5 |  |  | 2.2
CP | 25597650 | Caudoputamen | central striatum (CES) | 0.4 | -1.7 | -3.5 | bregma | 0.06 | 4.88 | y | review | TRUE | DV -8.4mm vs atlas | OUTLIER | n | only left side (-ve coord) was done | https://pubmed.ncbi.nlm.nih.gov/25597650/ | https://www.ncbi.nlm.nih.gov/pmc/?term=25597650 | subsequent experiments focused on three regions: AP+0.5, L −2.2, V −3.2 for dorsolateral striatum (DLS); AP+0.4, L −1.7, V −3.5 for central striatum (CES); or AP-0.1, L −2.0, V −1.5 for sensorimotor cortex (Cx) (all refer to the tip of injection cannula; see Figure 1A ). |  |  | none |  | 0.5 |  | AP_diff(csv=0.4,quote=0.5) | 1.7
CP | 25852508 | Dorsolateral striatum | striatum | 0.5 | -2 | -3 | bregma | 0.06 | 4.88 | partial(2/3) | review | TRUE | DV -7.9mm vs atlas | OUTLIER | y |  | https://pubmed.ncbi.nlm.nih.gov/25852508/ | https://www.ncbi.nlm.nih.gov/pmc/?term=25852508 | Custom-designed stainless steel injection cannulas (23G) were bilaterally implanted into the mPFC (AP 1.90 mm, ML ± 0.40 mm, and DV −2.00 mm; Figure 5A ) and the striatum (AP 0.50 mm, ML ± 2.00 mm, and DV −3.00 mm; Figure 5D ) (Paxinos and Franklin, 2001 ). Once inserted, the injection cannula protruded from the guide cannula1 mm, thus reaching the prelimbic mPFC or the dorso-lateral striatum. | 2 | yes | disambig | 0.4|2 | 1.9 | -2 | ML_recovered_disambig; AP_diff(csv=0.5,quote=1.9); DV_diff(csv=-3,quote=2) | 0
CP | 26921469 | Striatum dorsal region | striatum | 0.8 | -2.2 | -2.7 | bregma | 0.06 | 4.88 | y | review | TRUE | DV -7.6mm vs atlas | OUTLIER | n | dv is negative | https://pubmed.ncbi.nlm.nih.gov/26921469/ | https://www.ncbi.nlm.nih.gov/pmc/?term=26921469 | One μl virus was injected at the following coordinates: AP +0.8 mm, ML +2.2 mm, DV −2.7 mm. | 2.2 |  | low |  | 0.8 | -2.7 |  | 2.2
CP | 26921469 | Striatum dorsal region | dorsolateral striatum | 0.8 | -2.2 | -2.5 | bregma | 0.06 | 4.88 | y | review | TRUE | DV -7.4mm vs atlas | OUTLIER | n | dv is negative | https://pubmed.ncbi.nlm.nih.gov/26921469/ | https://www.ncbi.nlm.nih.gov/pmc/?term=26921469 | Immediately after viral injection, the mice were implanted with optical fibers (0.2 mm diameter) in the dorsolateral striatum (AP +0.8 mm, ML +2.2 mm, DV −2.5 mm) to allow for in vivo optical stimulation of cholinergic interneurons during behavioral assessment. | 2.2 |  | low |  | 0.8 | -2.5 |  | 2.2
CP | 27625595 | Striatum | Striatum | -1 | 2.2 | 3.3 | bregma | 0.06 | 4.88 | partial(2/3) | y | TRUE | AP z=-7.4; DV z=8.0 | OUTLIER | n | dv was wrong; also all dv is negative | https://pubmed.ncbi.nlm.nih.gov/27625595/ | https://www.ncbi.nlm.nih.gov/pmc/?term=27625595 | Striatum: −1 mm ap, 2.2 mm lat, 3.3/3.8 mm depth (Volume: 400–450 nl). | 3.3 |  | low |  | 2.2 | 3.8 | ML_mismatch(csv=2.2,quote=3.3); AP_diff(csv=-1,quote=2.2); DV_diff(csv=3.55,quote=3.8) | 2.2
CP | 27625595 | Striatum | Striatum | -1 | 2.2 | 3.3 | bregma | 0.06 | 4.88 | partial(2/3) | y | TRUE | AP z=-7.4; DV z=8.0 | OUTLIER | n | dv was wrong | https://pubmed.ncbi.nlm.nih.gov/27625595/ | https://www.ncbi.nlm.nih.gov/pmc/?term=27625595 | Striatum: −1 mm ap, 2.2 mm lat, 3.3/3.8 mm depth (Volume: 400–450 nl). | 3.3 |  | low |  | 2.2 | 3.8 | ML_mismatch(csv=2.2,quote=3.3); AP_diff(csv=-1,quote=2.2); DV_diff(csv=3.55,quote=3.8) | 2.2
CP | 28256010 | Caudoputamen | right striatum | 0.8 | 2.2 | -2.7 | bregma | 0.06 | 4.88 | y | review | TRUE | DV -7.6mm vs atlas | OUTLIER | y |  | https://pubmed.ncbi.nlm.nih.gov/28256010/ | https://www.ncbi.nlm.nih.gov/pmc/?term=28256010 | mice were stereotaxically injected into the right striatum with cre-inducible AAV vector expressing ChR2 (AAV5.EF1a.DIO.hChR2(H134R)-eYFP.WPRE.hGH) or control vector (AAV5.EF1a.DIO.eYFP.WPRE.hGH) to induce expression in D1 MSNs 6 , 7 , 38 . One µl virus was injected over 2 min at the following coordinates: AP +0.8 mm, ML +2.2 mm, DV −2.7 mm. | 2.2 |  | low |  | 0.8 | -2.7 |  | 2.2
CP | 28285820 | Caudoputamen | dorsal striatum | 0.8 | 1.5 | -2.5 | bregma | 0.06 | 4.88 | partial(2/3) | review | TRUE | DV -7.4mm vs atlas | OUTLIER | n | ml corrected | https://pubmed.ncbi.nlm.nih.gov/28285820/ | https://www.ncbi.nlm.nih.gov/pmc/?term=28285820 | For voltammetry experiments, custom fabricated carbon fiber voltammetry electrodes were inserted bilaterally into dorsal striatum (+ 0.8 AP, ± 1.5–2.0 ML, − 2.5 DV) and were affixed using dental cement ( Clark et al., 2010 ). | 1.5 | yes | high | 1.5 | 1.5 | 2.5 | ML_mismatch(csv=1.75,quote=1.5); AP_diff(csv=0.8,quote=1.5) | 1.75
CP | 28285820 | Caudoputamen | dorsal striatum | 0.8 | 2 | -2.5 | bregma | 0.06 | 4.88 | partial(2/3) | review | TRUE | DV -7.4mm vs atlas | OUTLIER | n | ml corrected | https://pubmed.ncbi.nlm.nih.gov/28285820/ | https://www.ncbi.nlm.nih.gov/pmc/?term=28285820 | For voltammetry experiments, custom fabricated carbon fiber voltammetry electrodes were inserted bilaterally into dorsal striatum (+ 0.8 AP, ± 1.5–2.0 ML, − 2.5 DV) and were affixed using dental cement ( Clark et al., 2010 ). | 1.5 | yes | high | 1.5 | 1.5 | 2.5 | ML_mismatch(csv=1.75,quote=1.5); AP_diff(csv=0.8,quote=1.5) | 1.75
CP | 28285820 | Caudoputamen | striatum | 0.8 | 1.5 | -2.3 | bregma | 0.06 | 4.88 | y | review | TRUE | DV -7.2mm vs atlas | OUTLIER | y |  | https://pubmed.ncbi.nlm.nih.gov/28285820/ | https://www.ncbi.nlm.nih.gov/pmc/?term=28285820 | To determine if behavioral effects were attributable to nigrostriatal dopamine, a separate group of DAT- Ai32 mice had fiber optics implanted into striatum (+ 0.8 AP, ± 1.5 ML, − 2.3 DV). | 1.5 | yes | high | 1.5 | 1.5 | 2.3 | AP_diff(csv=0.8,quote=1.5) | 1.5
CP | 28347488 | Caudoputamen | central dorsal striatum | 0.5 | 1.5 | -2.7 | bregma | 0.06 | 4.88 | partial(2/3) | review | TRUE | DV -7.6mm vs atlas | OUTLIER | y |  | https://pubmed.ncbi.nlm.nih.gov/28347488/ | https://www.ncbi.nlm.nih.gov/pmc/?term=28347488 | 0.5 μl virus was infused bilaterally into the central dorsal striatum under ketamine/xylazine anesthesia as described previously ( 21 ), targeting coordinates AP +0.5mm, ML ±1.5mm, DV −2.7 mm ( 36 ). | 1.5 | yes | high | 1.5 | 0.5 | -2.7 | ML_recovered | 0
CP | 29184069 | Caudoputamen | right dorsal striatum | 0.5 | 2 | -3.5 | bregma | 0.06 | 4.88 | partial(1/3) | review | TRUE | DV -8.4mm vs atlas | OUTLIER | y |  | https://pubmed.ncbi.nlm.nih.gov/29184069/ | https://www.ncbi.nlm.nih.gov/pmc/?term=29184069 | Right dorsal striatum was targeted using the following coordinates from bregma: anteriorposterior +0,5 mm, mediolateral −2mm and dorsoventral in two depths −3,4 mm and −3,6 mm according to mouse brain atlas 39 . A total of 4,25 μg (4 μl) of human recombinant α-Synuclein preformed fibrils (PFF) of three different types: (a) wt-PFF, (b) P-PFF and (c) S129A-PFF were injected at a constant flow rate of 0.27 μl/min. | 2 |  | low |  | 0 |  | AP_diff(csv=0.5,quote=0) | 2
CP | 29458998 | Caudoputamen | dorsal striatum | 0.62 | 1.9 | -3 | bregma | 0.06 | 4.88 | y | y | TRUE | DV z=7.3 | OUTLIER | n |  | https://pubmed.ncbi.nlm.nih.gov/29458998/ | https://www.ncbi.nlm.nih.gov/pmc/?term=29458998 | AAV5.CMV.HI.eGFP.Cre.WPRE.SV40 (AAV-Cre; titer 2 × 10 13 GC/ml) or AAV5.CMV.PI.eGFP.WPRE.bGH (AAV-GFP; titer 7 × 10 13 GC/ml) were injected bilaterally into the dorsal striatum (500 nl, AP: 0.62, ML: 1.90, DV: 3.00) or nucleus accumbens (NAc; 450 nl, AP: 1.65, ML: 0.92, DV: 4.80). | 1.9 |  | low |  | 0.62 | 3 |  | 1.9
CP | 29686629 | Dorsal striatum | dorsal striatum | 1 | 1.5 | -3.25 | bregma | 0.06 | 4.88 | y | review | TRUE | DV -8.1mm vs atlas | OUTLIER | y |  | https://pubmed.ncbi.nlm.nih.gov/29686629/ | https://www.ncbi.nlm.nih.gov/pmc/?term=29686629 | A Kopf model 1900 stereotaxic alignment system (David Kopf Instruments, Tujunga, CA, USA) was used to drill two holes using Kyocera #69 drill bits at the following coordinates from bregma: AP = +1 mm, ML = ±1.5 mm, DV: −3.25 mm ( 31 , 32 ). | 1.5 | yes | high | 1.5 | 1 | -3.25 |  | 1.5
CP | 29695836 | Dorsomedial striatum | dorsomedial striatum (DMS) | 0.5 | 1.5 | -2.8 | bregma | 0.06 | 4.88 | partial(2/3) | review | TRUE | DV -7.7mm vs atlas | OUTLIER | y |  | https://pubmed.ncbi.nlm.nih.gov/29695836/ | https://www.ncbi.nlm.nih.gov/pmc/?term=29695836 | A 5 μl Hamilton syringe with a 33-gauge metal needle was used to infuse the virus with a mircrosyringe pump (KdScientific) at a rate of 50 nl/min over 10 min. All stereotaxic coordinates were in relation to bregma for dorsomedial striatum (DMS): anterior-posterior, 0.5 mm; medial-lateral, +/−1.5 mm; dorsal-ventral, −2.8 mm. | 1.5 | yes | high | 1.5 | 0.5 | -2.8 | ML_recovered | 0
CP | 30326202 | Dorsal striatum | dorsal striatum | -0.93 | 1.8 | -3.46 | bregma | 0.06 | 4.88 | y | review | TRUE | AP z=-7.1; DV -8.3mm vs atlas | OUTLIER | y |  | https://pubmed.ncbi.nlm.nih.gov/30326202/ | https://www.ncbi.nlm.nih.gov/pmc/?term=30326202 | To image GCaMP6s fluorescence in dorsal striatum (DS), we injected AAV1.CAG.Flex.GCaMP6s.WPRE.SV40 (University of Pennsylvania Vector Core) into the dorsal striatum of the D1-Cre mouse. For the experiments comparing the performance of the automated surgical instrument and handheld method, we injected AAV1.hSyn.Cre-GFP.WPRE.hGH into the dorsal striatum of the wildtype mice. The AAV viruses were injected using the stereotactic coordinates A/P: −0.93 mm, M/L: +1.8 mm, D/V: −3.46 mm, with 30 angle shift to caudate. | 1.8 |  | low |  | -0.93 | -3.46 |  | 1.8
CP | 30342106 | Striatum dorsal region | dorsal striatum | 1 | 1.5 | -2.5 | bregma | 0.06 | 4.88 | partial(2/3) | review | TRUE | DV -7.4mm vs atlas | OUTLIER | y |  | https://pubmed.ncbi.nlm.nih.gov/30342106/ | https://www.ncbi.nlm.nih.gov/pmc/?term=30342106 | We injected 1 μL of adeno-associated virus serotype 1 (AAV1) carrying the calcium indicator GCaMP6m in a double-floxed inverted open reading frame under the control of the Synapsin promoter (AAV1-hSyn-Flex-GCaMP6m). The virus was injected bilaterally into dorsal striatum of an adult mouse in a stereotactic surgery as described above, at coordinates +1.0 anteroposterior (AP), +/−1.5 mediolateral (ML), and −2.5 dorsoventral (DV), measured from bregma on the skull surface. | 1.5 | yes | high | 1.5 | 1.5 | -2.5 | ML_recovered; AP_diff(csv=1,quote=1.5) | 0
CP | 30606046 | Dorsal striatum | dorsal striatum | 1.6 | 1.9 | 5 | bregma | 0.06 | 4.88 | partial(2/3) | y | TRUE | AP z=4.3; DV z=9.9 | OUTLIER | n | reject since this coordinate was in rats | https://pubmed.ncbi.nlm.nih.gov/30606046/ | https://www.ncbi.nlm.nih.gov/pmc/?term=30606046 | Guide cannulas were implanted bilaterally into the mPFC (rats, 3.0 mm rostral, ±1.0 mm lateral, 4.0 mm ventral to bregma; mice, 1.8 mm rostral, ±0.4 mm lateral, 2.5 mm ventral to bregma) or dorsal striatum (rats, 1.6 mm rostral, ±1.9 mm lateral, 5.0 mm ventral to bregma). | 1.9 | yes | disambig | 0.4|1|1.9 |  | 4 | ML_recovered_disambig; DV_diff(csv=5,quote=4) | 0
CP | 31757603 | Dorsal striatum | dorsal striatum | 0.5 | 1.7 | -1.8 | bregma | 0.06 | 4.88 | y | review | TRUE | DV z=5.8; DV -3.1mm vs atlas | OUTLIER | n | dv -ve | https://pubmed.ncbi.nlm.nih.gov/31757603/ | https://www.ncbi.nlm.nih.gov/pmc/?term=31757603 | For retrograde labeling of layer 5 PNs, 100 nl of cholera toxin subunit B (CTB)-Alexa Fluor-555 or CTB-Alexa Fluor-488 (ThermoFisher) was injected via glass micropipette into the lateral pons (AP: −3.1, ML: 1.2, DV: 4.7 relative to Bregma) or dorsal striatum (AP: 0.5, ML: 1.7, DV: 1.8), respectively. | 1.2 |  | low |  | -3.1 | 4.7 | ML_mismatch(csv=1.7,quote=1.2); AP_diff(csv=0.5,quote=-3.1); DV_diff(csv=1.8,quote=4.7) | 1.7
CP | 31837424 | Striatum | striatum | 0.2 | 2 | -2.6 | bregma | 0.06 | 4.88 | partial(2/3) | review | TRUE | DV -7.5mm vs atlas | OUTLIER | y |  | https://pubmed.ncbi.nlm.nih.gov/31837424/ | https://www.ncbi.nlm.nih.gov/pmc/?term=31837424 | Animals were bilaterally injected with 2 μL (per side) of 300 μM sonicated fibrils, or 300 μM monomeric α-synuclein, or phosphate-buffered saline (PBS) as controls. Solutions were injected at a constant rate of 0.5 μL/ min and the needle left in place for 5 min followed by slowly withdrawing the needle. Coordinates for the striatum were + 0.2 mm AP, ± 2.0 mm ML, −2.6 mm DV. | 2 | yes | high | 2 | 2 | -2.6 | ML_recovered; AP_diff(csv=0.2,quote=2) | 0
CP | 31837424 | Dorsolateral striatum | dorsolateral striatum | 0.2 | 2 | -2.6 | bregma | 0.06 | 4.88 | partial(2/3) | review | TRUE | DV -7.5mm vs atlas | OUTLIER | y |  | https://pubmed.ncbi.nlm.nih.gov/31837424/ | https://www.ncbi.nlm.nih.gov/pmc/?term=31837424 | Animals were bilaterally injected with 2 μL (per side) of 300 μM sonicated fibrils, or 300 μM monomeric α-synuclein, or phosphate-buffered saline (PBS) as controls. Solutions were injected at a constant rate of 0.5 μL/ min and the needle left in place for 5 min followed by slowly withdrawing the needle. Coordinates for the striatum were + 0.2 mm AP, ± 2.0 mm ML, −2.6 mm DV. Mice received bilateral injections into the dorsolateral striatum with α-synuclein fibrils or controls. | 2 | yes | high | 2 | 2 | -2.6 | ML_recovered; AP_diff(csv=0.2,quote=2) | 0
CP | 32107381 | Striatum | striatum | 0.6 | 1.8 | -3.5 | bregma | 0.06 | 4.88 | partial(2/3) | review | TRUE | DV -8.4mm vs atlas | OUTLIER | y |  | https://pubmed.ncbi.nlm.nih.gov/32107381/ | https://www.ncbi.nlm.nih.gov/pmc/?term=32107381 | The operation began with a midline scalp incision followed by the creation of a (~1 mm) drill hole on the skull for intracranial injection into the striatum (AP +0.6 mm, ML ±1.8 mm, DV −3.5 mm). The injection volume was 2 μl and the flow rate was controlled at 0.2 μl/min. | 1.8 | yes | high | 1.8 | 0.6 | -3.5 | ML_recovered | 0
CP | 32313025 | Striatum dorsal region | NAc | 0.9 | 1.5 | -2.75 | bregma | 0.06 | 4.88 | partial(2/3) | review | TRUE | DV -7.6mm vs atlas | OUTLIER | n | brain region wrong | https://pubmed.ncbi.nlm.nih.gov/32313025/ | https://www.ncbi.nlm.nih.gov/pmc/?term=32313025 | Following anesthesia with pentobarbital (30 mg kg −1 ), we performed bilateral stereotaxic injections of AAV-GFP or AAV-GFP-Cre (2.6 × 10 9 GS per injection) in the NAc at the following coordinates 64 from the bregma (millimeters), anteroposterior, 1.3, lateral, ±1.3, and dorsoventral, −4.5 or in the DS, anteroposterior, 0.9, lateral, ±1.5, and dorsoventral, −2.75. | 1.5 | yes | disambig | 1.3|1.5 | 1.3 | -4.5 | ML_recovered_disambig; AP_diff(csv=0.9,quote=1.3); DV_diff(csv=-2.75,quote=4.5) | 0
CP | 32487763 | Dorsal striatum | right dorsal striatum | 0.4 | 2 | -2.6 | bregma | 0.06 | 4.88 | y | review | TRUE | DV -7.5mm vs atlas | OUTLIER | y |  | https://pubmed.ncbi.nlm.nih.gov/32487763/ | https://www.ncbi.nlm.nih.gov/pmc/?term=32487763 | For stereotactic surgeries, 5 μg of PFFs in 2 μl PBS was injected into the right dorsal striatum (AP +0.4, ML +2, DV −2.6) of fully anesthetized animals (100 mg/kg ketamine and 10 mg/kg xylazine, i.p.) on stereotactic frames (Kopf Instruments) through a 34-gauge cannula using a 10-μl Hamilton syringe (flow rate of 0.1 μl/min). | 2 |  | low |  | 0.4 | -2.6 |  | 2
CP | 32666590 | Caudoputamen | dorsal striatum | 0.65 | 2 | -4 | bregma | 0.06 | 4.88 | partial(2/3) | review | TRUE | DV -8.6mm vs atlas | OUTLIER | n |  | https://pubmed.ncbi.nlm.nih.gov/32666590/ | https://www.ncbi.nlm.nih.gov/pmc/?term=32666590 | Microinjections of 6‐OHDA A subthreshold dose (2.5 μg/μL in two deposits of 2 μL each) of 6‐OHDA (10 mM solution in 0.9% NaCl/0.2% ascorbic acid; Sigma‐Aldrich, Madrid, Spain), defined as a dose that does not induce motor impairment in nondiabetic mice, corresponding to half the dose required to induce overt neurodegeneration of nigrostriatal axons, 34 was injected unilaterally under 2% isoflurane anesthesia into the dorsal striatum using a Hamilton syringe. Stereotaxic coordinates were: AP = 0.65, L = 2.0, DV 1 = –4 and DV 2 = –3.5. | 2 |  | low |  | 0.65 | 1 | DV_diff(csv=-3.75,quote=1) | 2
CP | 32666590 | Caudoputamen | dorsal striatum | 0.65 | 2 | -3.5 | bregma | 0.06 | 4.88 | partial(2/3) | review | TRUE | DV -8.6mm vs atlas | OUTLIER | n |  | https://pubmed.ncbi.nlm.nih.gov/32666590/ | https://www.ncbi.nlm.nih.gov/pmc/?term=32666590 | Microinjections of 6‐OHDA A subthreshold dose (2.5 μg/μL in two deposits of 2 μL each) of 6‐OHDA (10 mM solution in 0.9% NaCl/0.2% ascorbic acid; Sigma‐Aldrich, Madrid, Spain), defined as a dose that does not induce motor impairment in nondiabetic mice, corresponding to half the dose required to induce overt neurodegeneration of nigrostriatal axons, 34 was injected unilaterally under 2% isoflurane anesthesia into the dorsal striatum using a Hamilton syringe. Stereotaxic coordinates were: AP = 0.65, L = 2.0, DV 1 = –4 and DV 2 = –3.5. | 2 |  | low |  | 0.65 | 1 | DV_diff(csv=-3.75,quote=1) | 2
CA1 | 21945599 | Field CA1 | CA1 temporal site | -2.5 | 2 | -1.2 | bregma | -2.66 | 2.61 | partial(2/3) | y | FALSE |  | CHECK_quote | n | dv -ve | https://pubmed.ncbi.nlm.nih.gov/21945599/ | https://www.ncbi.nlm.nih.gov/pmc/?term=21945599 | Each injection consisted of 1 μl of rAAV5 virus infused at a rate of 0.25 μl/minute. Coordinates for CA1 injection into Homer1 KO: Temporal site (AP= −2.5, Lat= +/−2, DV=1.2); | 2 | yes | high | 2 | -2.5 | 1.2 | ML_recovered | 0
CA1 | 27330015 | Field CA1 | CA1 region of the dorsal hippocampus | -2 | 1.5 | -1.6 | bregma | -2.66 | 2.61 | partial(2/3) | y | FALSE |  | CHECK_quote | n | ap was recorded wrong by automation and dv is -ve | https://pubmed.ncbi.nlm.nih.gov/27330015/ | https://www.ncbi.nlm.nih.gov/pmc/?term=27330015 | Sterile bilateral stainless steel 26 gauge guide cannulae (Plastics One, Roanoke, VA), were implanted directly above the CA1 region of the dorsal hippocampus, as described previously ( Cohen et al., 2013 ). The coordinates for placement were: 2.0 mm posterior, ±1.5 mm lateral, and 1.6 mm ventral, relative to bregma ( Franklin & Paxinos, 2008 ). A subset of the mice received bilateral intra-CA1 infusions of fluorophore-conjugated muscimol (BODIPY TMR-X (Molecular Probes) in sterile saline, 0.35 μL per side), 15 min before euthanasia and brain dissection in order to visualize the distribution of this volume of muscimol infused into the CA1 region. | 1.5 | yes | high | 1.5 |  | 1.6 | ML_recovered | 0
CA1 | 27485264 | Field CA1 | right dorsal hippocampus | -1.6 | 1.1 | -1.8 | bregma | -2.66 | 2.61 | partial(2/3) | y | FALSE |  | CHECK_quote | n |  | https://pubmed.ncbi.nlm.nih.gov/27485264/ | https://www.ncbi.nlm.nih.gov/pmc/?term=27485264 | During virus injection, a 0.2 mm craniotomy was made at PA −1.6/ML 1.1, and 7 injections of 55 nl were made at 0.2 mm intervals from DV, 1.8 mm to 0.6 mm, to target the right dorsal hippocampus 6 . | 1.1 |  | low |  |  | 1.8 | DV_diff(csv=1.2,quote=1.8) | 1.1
CA1 | 27485264 | Field CA1 | right dorsal hippocampus | -1.6 | 1.1 | -0.6 | bregma | -2.66 | 2.61 | partial(2/3) | y | FALSE |  | CHECK_quote | n |  | https://pubmed.ncbi.nlm.nih.gov/27485264/ | https://www.ncbi.nlm.nih.gov/pmc/?term=27485264 | During virus injection, a 0.2 mm craniotomy was made at PA −1.6/ML 1.1, and 7 injections of 55 nl were made at 0.2 mm intervals from DV, 1.8 mm to 0.6 mm, to target the right dorsal hippocampus 6 . | 1.1 |  | low |  |  | 1.8 | DV_diff(csv=1.2,quote=1.8) | 1.1
CA1 | 27625595 | Field CA1 | Hippocampus CA1 and DG | -2.1 | 1 | -1 | bregma | -2.66 | 2.61 | partial(1/3) | y | FALSE |  | CHECK_quote | n |  | https://pubmed.ncbi.nlm.nih.gov/27625595/ | https://www.ncbi.nlm.nih.gov/pmc/?term=27625595 | Hippocampus injection coordinates (from Bregma): −2.1 mm anteroposterior (ap), for CA1 and DG: ±1 mm lateral (lat) and 1/1.7 mm depth, for CA3: ±2.1 mm lat and 1.6 mm depth (Volume: 200–300 nl per site). | 2.1 | yes | disambig | 1|2.1 | -2.1 | 1.7 | ML_recovered_disambig; DV_diff(csv=1.35,quote=1.7) | 0
CA1 | 27625595 | Field CA1 | Hippocampus CA1 and DG | -2.1 | 1 | -1.7 | bregma | -2.66 | 2.61 | partial(1/3) | y | FALSE |  | CHECK_quote | n |  | https://pubmed.ncbi.nlm.nih.gov/27625595/ | https://www.ncbi.nlm.nih.gov/pmc/?term=27625595 | Hippocampus injection coordinates (from Bregma): −2.1 mm anteroposterior (ap), for CA1 and DG: ±1 mm lateral (lat) and 1/1.7 mm depth, for CA3: ±2.1 mm lat and 1.6 mm depth (Volume: 200–300 nl per site). | 2.1 | yes | disambig | 1|2.1 | -2.1 | 1.7 | ML_recovered_disambig; DV_diff(csv=1.35,quote=1.7) | 0
CA1 | 30060138 | Field CA1 | right hemisphere CA1 | -1.75 | 2 | -1 | bregma | -2.66 | 2.61 | partial(2/3) | y | FALSE |  | CHECK_quote | n |  | https://pubmed.ncbi.nlm.nih.gov/30060138/ | https://www.ncbi.nlm.nih.gov/pmc/?term=30060138 | The 2 stereotrode bundles were spaced approximately 1.0 mm apart within right hemisphere CA1 (relative to Bregma: 1.75–2.75 mm posterior, 1.5–2.5 mm lateral, and 1.0 mm ventral). | 2.5 |  | low |  |  | 1 | ML_mismatch(csv=2,quote=2.5) | 2
CA1 | 30060138 | Field CA1 | right hemisphere CA1 | -2.75 | 2 | -1 | bregma | -2.66 | 2.61 | partial(2/3) | y | FALSE |  | CHECK_quote | n |  | https://pubmed.ncbi.nlm.nih.gov/30060138/ | https://www.ncbi.nlm.nih.gov/pmc/?term=30060138 | The 2 stereotrode bundles were spaced approximately 1.0 mm apart within right hemisphere CA1 (relative to Bregma: 1.75–2.75 mm posterior, 1.5–2.5 mm lateral, and 1.0 mm ventral). | 2.5 |  | low |  |  | 1 | ML_mismatch(csv=2,quote=2.5) | 2
CA1 | 32041202 | Field CA1 | CA1 region of the hippocampus | -2 | 1.3 | -1.3 | bregma | -2.66 | 2.61 | partial(1/3) | y | FALSE |  | CHECK_quote | n |  | https://pubmed.ncbi.nlm.nih.gov/32041202/ | https://www.ncbi.nlm.nih.gov/pmc/?term=32041202 | Bilateral coordinates for stereotaxic Aβ 1-42 injection at three depths within the CA1 region of the hippocampus were determined relative to bregma (antero-posterior, −2.0 mm; medial-lateral, ±1.3 mm; dorsal-ventral, −1.9, 2.4, and 2.9 mm) according to the Paxinos and Franklin’s mouse brain atlas [ 38 ]. Stereotaxic bilateral administration of 1 μL of 20 μM neurotoxic Aβ 1-42 [ 34 , 35 ] or ACSF as vehicle or scrAβ 1-42 (AS-25382, AnaSpec) into the CA1 region was performed at a rate of 0.1 µL/min. | 1.3 | yes | high | 1.3 | -2 | -1.9 | ML_recovered; DV_diff(csv=1.13,quote=1.9) | 0
CA1 | 32061032 | Field CA1 | hippocampal CA1 area | -2.3 | 2 | -2.5 | bregma | -2.66 | 2.61 | partial(1/3) | y | FALSE |  | CHECK_quote | n |  | https://pubmed.ncbi.nlm.nih.gov/32061032/ | https://www.ncbi.nlm.nih.gov/pmc/?term=32061032 | After opening the scalp skin and exposing the skull, 1 μl of AAV TRPV1 or AAV shTRPV1 was microinjected into each hippocampal CA1 area by drilled hole (−2.3 mm and −2.5 mm posterior, ±2.0 mm lateral and 2.5 mm ventral relative to bregma). | 2 | yes | high | 2 |  | 2.5 | ML_recovered | 0
CA1 | 32061032 | Field CA1 | hippocampal CA1 area | -2.5 | 2 | -2.5 | bregma | -2.66 | 2.61 | partial(1/3) | y | FALSE |  | CHECK_quote | n |  | https://pubmed.ncbi.nlm.nih.gov/32061032/ | https://www.ncbi.nlm.nih.gov/pmc/?term=32061032 | After opening the scalp skin and exposing the skull, 1 μl of AAV TRPV1 or AAV shTRPV1 was microinjected into each hippocampal CA1 area by drilled hole (−2.3 mm and −2.5 mm posterior, ±2.0 mm lateral and 2.5 mm ventral relative to bregma). | 2 | yes | high | 2 |  | 2.5 | ML_recovered | 0
CA1 | 21677170 | Field CA1 | CA1 region of the hippocampus | -3 | 3 | -2.2 | bregma | -2.66 | 2.61 | y | y | FALSE |  | likely_ok | n |  | https://pubmed.ncbi.nlm.nih.gov/21677170/ | https://www.ncbi.nlm.nih.gov/pmc/?term=21677170 | Unilateral injections into the CA1 region of the hippocampus were made at A/P −3.0 mm, M/L +/−3.0 mm, and D/V 2.2 mm relative to Bregma. 1.0 μl of an AAV-CreEGFP virus (1.2×1013 genome copy/ml, diluted 1:5 in PBS) was injected at a rate of 100nL/min. | 3 | yes | high | 3 | -3 | 2.2 |  | 3
CA1 | 25495999 | Field CA1 | ventral CA1 | -2.8 | 3.3 | -2.3 | bregma | -2.66 | 2.61 | y | y | FALSE |  | likely_ok | n |  | https://pubmed.ncbi.nlm.nih.gov/25495999/ | https://www.ncbi.nlm.nih.gov/pmc/?term=25495999 | AAVs were injected into the ventral CA1 (anteroposterior: 2.8 mm, mediolateral: 3.3 mm, dorsoventral: 2.3 mm) of adult PV-CRE or PV-M 1 KO mice (>8 weeks of age); PV-YFP or hM3Dq-mCherry-positive (PV-mCherry) cells were visualized in acute hippocampal slices from PV-M 1 KO or PV-CRE mice, respectively, at least 4 weeks after surgery. | 3.3 |  | low |  | 2.8 | 2.3 |  | 3.3
CA1 | 25867120 | Field CA1 | CA1 | -2.3 | 1.8 | -1.1 | bregma | -2.66 | 2.61 | y | y | FALSE |  | likely_ok | n |  | https://pubmed.ncbi.nlm.nih.gov/25867120/ | https://www.ncbi.nlm.nih.gov/pmc/?term=25867120 | the coordinates for CA1 were AP –2.3 mm, ML 1.8 mm and DV 1.1 mm in the right hemisphere. | 1.8 |  | low |  | -2.3 | 1.1 |  | 1.8
CA1 | 27526777 | Field CA1 | CA1 | -2.06 | 1.6 | -1.4 | bregma | -2.66 | 2.61 | y | y | FALSE |  | likely_ok | n |  | https://pubmed.ncbi.nlm.nih.gov/27526777/ | https://www.ncbi.nlm.nih.gov/pmc/?term=27526777 | At the same time, polyimide-insulated silver wire monopolar depth electrodes (outside diameter 0.14 mm) were bilaterally implanted into CA1 (AP: −2.06 mm, LM: 1.60 mm, DV: 1.40 mm). |  |  | none |  | -2.06 | 1.4 |  | 1.6
CA1 | 31447652 | Field CA1 | CA1/CA3 | -2.18 | 2.1 | -1.9 | bregma | -2.66 | 2.61 | y | y | FALSE |  | likely_ok | n |  | https://pubmed.ncbi.nlm.nih.gov/31447652/ | https://www.ncbi.nlm.nih.gov/pmc/?term=31447652 | Table 1 Injection site coordinates, number of animals and injected volumes of rAAV8-CMV-WGA-Cre and rAAV8-CMV-TTC-eGFP tracers. Structure AP* (mm) ML* (mm) DV* (mm) n Volume rAAV (μl) Hippocampus Dentate gyrus −2.54 ± 1.5 1.8–1.6 3 1 CA1/CA3 −2.18 ± 2.1 1.9–1.5 2 1. | 1.5 | yes | disambig | 1.5|2.1 |  |  | ML_mismatch(csv=2,quote=1.5) | 2
CA1 | 31447652 | Field CA1 | CA1/CA3 | -2.18 | 2.1 | -1.5 | bregma | -2.66 | 2.61 | y | y | FALSE |  | likely_ok | n |  | https://pubmed.ncbi.nlm.nih.gov/31447652/ | https://www.ncbi.nlm.nih.gov/pmc/?term=31447652 | Table 1 Injection site coordinates, number of animals and injected volumes of rAAV8-CMV-WGA-Cre and rAAV8-CMV-TTC-eGFP tracers. Structure AP* (mm) ML* (mm) DV* (mm) n Volume rAAV (μl) Hippocampus Dentate gyrus −2.54 ± 1.5 1.8–1.6 3 1 CA1/CA3 −2.18 ± 2.1 1.9–1.5 2 1. | 1.5 | yes | disambig | 1.5|2.1 |  |  | ML_mismatch(csv=2,quote=1.5) | 2
CA1 | 31454077 | Field CA1 | CA1 region of the dorsal hippocampus | -2.3 | 1.75 | -1 | bregma | -2.66 | 2.61 | y | y | FALSE |  | likely_ok | n |  | https://pubmed.ncbi.nlm.nih.gov/31454077/ | https://www.ncbi.nlm.nih.gov/pmc/?term=31454077 | Adult (3–4 months old) male Vglut2-Cre mice (5 control, 5 sleep deprived mice) were stereotaxically microinjected with 23 nanoliters of AAV8::EF1a::DIO::ChR2(H134R)::mCherry Virus (Vector Labs, cat# VB2090), RRID:Addgene_47636. The injections targeted the CA1 region of the dorsal hippocampus (stereotaxic coordinates AP: −2.3, ML:1.75, DV: 1.0) using a glass micropipette and an air pressure injection system. | 1.75 |  | low |  | -2.3 | 1 |  | 1.75
CA1 | 32107637 | Field CA1 | CA1 region of the left hippocampus | -2.7 | 2.7 | -1.85 | bregma | -2.66 | 2.61 | y | y | FALSE |  | likely_ok | n |  | https://pubmed.ncbi.nlm.nih.gov/32107637/ | https://www.ncbi.nlm.nih.gov/pmc/?term=32107637 | To express channelrhodopsin-2 (ChR2) in SST or PV interneurons, we injected adeno-associated virus (AAV) (AAV5-EF1a-DIO-hChR2(E123T/T159C)-p2A-mCherry-WPRE, 3.8 × 10 12 virus molecules/mL, 1 μL, UNC Vector Core) into the CA1 region of the hippocampus in SST-Cre and PV-Cre mice (postnatal day 28–49). AAV was injected unilaterally into the CA1 region of the left hippocampus (2.7 mm posterior, 2.7 mm lateral and 1.85 mm ventral from the bregma) using a 5 μL micro-needle (Hamilton Company) connected to a motorized stereotaxic injector (delivery rate: 0.1 μL/min). | 1 |  | low |  |  | 1.85 | ML_mismatch(csv=2.7,quote=1) | 2.7
CA1 | 32107637 | Field CA1 | same location in CA1 region of the left hippocampus | -2.7 | 2.7 | -1.85 | bregma | -2.66 | 2.61 | y | y | FALSE |  | likely_ok | y |  | https://pubmed.ncbi.nlm.nih.gov/32107637/ | https://www.ncbi.nlm.nih.gov/pmc/?term=32107637 | AAV was injected unilaterally into the CA1 region of the left hippocampus (2.7 mm posterior, 2.7 mm lateral and 1.85 mm ventral from the bregma) using a 5 μL micro-needle (Hamilton Company) connected to a motorized stereotaxic injector (delivery rate: 0.1 μL/min). Then, either DMSO (diluted in PBS, 3 μL, delivery rate: 0.3 μL/min) or soluble AβO (3 μL, delivery rate: 0.3 μL/min) was co-injected to the same location to create control mice or mice with AβO pathology, respectively | 2.7 |  | low |  |  | 1.85 |  | 2.7
