asathyanesan/Neuroinjector/validation/verification_full_corrected.csv

pmid | pmcid | region_verbatim | ccf_region | ap_mm | ml_mm | dv_mm | reference | orig_ap_mm | orig_ml_mm | orig_dv_mm | ml_confidence | ml_candidates | correction_made | correction_reason | reparse_flag | source_quote | pubmed_url | pmc_url
15028771 |  | ventral stomach wall |  |  |  |  |  |  |  |  | none |  | n |  | ML_not_found | H129 or an established retrograde transneuronal viral tracer, pseudorabies virus (PRV), was injected into the ventral stomach wall in intact rats or in rats with previous subdiaphragmatic vagal sensory deafferentation. | https://pubmed.ncbi.nlm.nih.gov/15028771/ | https://www.ncbi.nlm.nih.gov/pmc/?term=15028771
18801112 |  | vitreous body of the left eye |  |  |  |  |  |  |  |  | none |  | n |  | ML_not_found | NMDA (20 mM/2 microl) was injected into the vitreous body of the left eye in mice (day 0). | https://pubmed.ncbi.nlm.nih.gov/18801112/ | https://www.ncbi.nlm.nih.gov/pmc/?term=18801112
19543379 |  |  |  | -1.46 |  |  | bregma | -1.46 |  |  | none |  | n |  | ML_not_found | The red bar represents the section plane (stereotaxic coordinates: interaural 2.34 mm, bregma −1.46 mm) for the initial screening of all mouse brains (see text). | https://pubmed.ncbi.nlm.nih.gov/19543379/ | https://www.ncbi.nlm.nih.gov/pmc/?term=19543379
21209897 |  |  |  |  |  |  |  |  |  |  | none |  | n |  | ML_not_found | The neurological deficit score was evaluated 24 h after an intra-cerebral microinjection of 50 nmol of a NMDA solution in a volume of 500 nl. | https://pubmed.ncbi.nlm.nih.gov/21209897/ | https://www.ncbi.nlm.nih.gov/pmc/?term=21209897
24586817 |  | left gastrocnemius muscle |  |  |  |  |  |  |  |  | none |  | n |  | ML_not_found | Pseudorabies virus (PRV)-614 was injected into the left gastrocnemius muscle in adult male MC4R-green fluorescent protein (GFP) transgenic mice (n&#x200a;=&#x200a;15). | https://pubmed.ncbi.nlm.nih.gov/24586817/ | https://www.ncbi.nlm.nih.gov/pmc/?term=24586817
24744708 |  |  |  |  |  |  |  |  |  |  | none |  | n |  | ML_not_found | After craniotomy, mice were injected with AAV2-luciferase (0.5 uL, EF1a or CMV) and/or AAV… | https://pubmed.ncbi.nlm.nih.gov/24744708/ | https://www.ncbi.nlm.nih.gov/pmc/?term=24744708
25093726 |  |  |  |  | 0.0 | 0.375 | dura |  |  | 0.375 | none |  | n | ML->0 (midline) | ML_not_found | For lentiviral injections, a midline incision was made on the scalp, and a 2 mm burr hole was made using a dental drill, and a 5 ml Hamilton syringe was lowered 0.25–0.5 mm below the dural membrane at the previously determined coordinates. A nanoinjector pump (Stoelting) was used for infusion of 3–6 µl virus at a rate of 0.1–0.2 µl/min, after which the needle was left in place for 5–10 min to ensure complete diffusion of the virus. | https://pubmed.ncbi.nlm.nih.gov/25093726/ | https://www.ncbi.nlm.nih.gov/pmc/?term=25093726
25342197 |  | a region dorsal to the target site |  |  |  |  |  |  |  |  | none |  | n |  | ML_not_found | Significant changes in intake were absent when the drugs were infused in a region dorsal to the target site (GAN) or into the lateral ventricle (THIP). | https://pubmed.ncbi.nlm.nih.gov/25342197/ | https://www.ncbi.nlm.nih.gov/pmc/?term=25342197
25360394 |  |  |  |  |  |  |  |  |  |  | none |  | n |  | ML_not_found |  | https://pubmed.ncbi.nlm.nih.gov/25360394/ | https://www.ncbi.nlm.nih.gov/pmc/?term=25360394
26050084 |  | lumbar cistern |  |  |  |  |  |  |  |  | none |  | n |  | ML_not_found | Ten min after injecting 8 μl PBS containing 0.4% trypan blue, brain and spinal cord were dissected and photographed from the dorsal (a) and ventral (b) sides. Here, we report that a single intrathecal injection of recombinant adeno-associated virus rhesus-10 (rAAVrh10) into the lumbar cistern led to transgene expression in 60 to 90 % of the cells in the spinal cord. | https://pubmed.ncbi.nlm.nih.gov/26050084/ | https://www.ncbi.nlm.nih.gov/pmc/?term=26050084
26376776 |  | intravitreal injection |  |  |  |  |  |  |  |  | none |  | n |  | ML_not_found | d, e Whole mount retinas with successful CTB uptake via intravitreal injection. We traced the primary visual projection from the eye to the superior colliculus (SC) in DBA/2J and DBA/2J.Gpnmb (+) (control) mice using the anterograde tracer cholera toxin-B (CTB) to assay axonal transport deficits. | https://pubmed.ncbi.nlm.nih.gov/26376776/ | https://www.ncbi.nlm.nih.gov/pmc/?term=26376776
26729030 |  |  |  |  |  |  |  |  |  |  | none |  | n |  | ML_not_found | Inject at a slow rate, such as 100 nl/min ( Fig. 13 After the virus has been injected (the volume of virus depends on the experiment, typically between 10 and 500 nl), leave the ca… | https://pubmed.ncbi.nlm.nih.gov/26729030/ | https://www.ncbi.nlm.nih.gov/pmc/?term=26729030
26844836 |  | designated areas |  |  |  |  |  |  |  |  | none |  | n |  | ML_not_found | For tracer injections, 20–100 nl BDA 10,000 Da solution and/or fluorescent cholera toxin subunit-B (Ctb Alexa Fluor 488 and Ctb Alexa Fluor 555) were injected to the designated areas. | https://pubmed.ncbi.nlm.nih.gov/26844836/ | https://www.ncbi.nlm.nih.gov/pmc/?term=26844836
28529331 |  |  |  |  |  |  |  |  |  |  | none |  | n |  | ML_not_found | Intracerebral injection BChE KO mice (10-week-old) were anesthetized with 50 mg kg −1 pentobarbital, and 10 μl of AAV–BChE containing 1.5 × 10 12 viral particles was delivered (1 μl min −1 ) in two injections, bilaterally targeting … | https://pubmed.ncbi.nlm.nih.gov/28529331/ | https://www.ncbi.nlm.nih.gov/pmc/?term=28529331
28963505 |  |  |  |  |  |  |  |  |  |  | none |  | n |  | ML_not_found |  | https://pubmed.ncbi.nlm.nih.gov/28963505/ | https://www.ncbi.nlm.nih.gov/pmc/?term=28963505
32513737 |  | anterior part |  | 1.5 |  |  | bregma | -1.5 |  |  | none |  | n | AP->pos(rostral/anterior) | ML_not_found | The anterior part was described as bregma −1.5 mm … | https://pubmed.ncbi.nlm.nih.gov/32513737/ | https://www.ncbi.nlm.nih.gov/pmc/?term=32513737
32762731 |  | tibialis muscle |  |  |  |  |  |  |  |  | none |  | n |  | ML_not_found | AAV1-CAG-scFvMC1 was injected in tibialis muscle of P301S or JNPL3 (JNPL3 shown), mice sacrificed 4 months later and peripheral organs harvested. | https://pubmed.ncbi.nlm.nih.gov/32762731/ | https://www.ncbi.nlm.nih.gov/pmc/?term=32762731
32774811 |  | ST36 |  |  | 1.5 | 3.0 |  |  | 1.5 | 3.0 | llm |  | n |  | ML_mismatch(llm=1.5;quote=na) | The location of ST36 is approximately 3 mm below and 1–2 mm lateral to the midpoint of the knee in mice. To ensure an insertion depth of 3 mm, a piece of tape was stuck to the needle, leaving only space for manipulation and a needle tip of 3 mm. | https://pubmed.ncbi.nlm.nih.gov/32774811/ | https://www.ncbi.nlm.nih.gov/pmc/?term=32774811
27363576 |  | right OB/AON | Accessory olfactory bulb |  |  |  |  |  |  |  | none |  | n |  | ML_not_found | For the first study, phosphate-buffered saline (PBS) or α-synuclein fibrils (5 μg in 1 μL PBS; sonicated for 1 min with a probe or 1 h in a waterbath) were unilaterally infused into the right OB/AON of non-transgenic male CD1 mice at two months of age. For the second study, two month-old mice were infused with the retrograde tracer FluoroGold into the OB/AON to label afferent neurons that send direct projections to the site of infusion and to again confirm the center of the injection site at the same stereot… | https://pubmed.ncbi.nlm.nih.gov/27363576/ | https://www.ncbi.nlm.nih.gov/pmc/?term=27363576
28065711 |  | AOB | Accessory olfactory bulb |  |  |  |  |  |  |  | none |  | n |  | ML_not_found | During stereotaxic viral injections into the AOB (Experiment 2), mice were anaesthetized using 2% isofluorane whereupon the head was fixed in a stereotaxic apparatus (David Kopf Instruments, Tujunga, CA). | https://pubmed.ncbi.nlm.nih.gov/28065711/ | https://www.ncbi.nlm.nih.gov/pmc/?term=28065711
28374006 |  | AOB | Accessory olfactory bulb |  |  |  |  |  |  |  | none |  | n |  | ML_not_found | Protocadherin-Cre male transgenic mice received bilateral AOB infections with channelrhodopsin2 (ChR2) viral vectors, and an optical fiber was implanted above the AOB. | https://pubmed.ncbi.nlm.nih.gov/28374006/ | https://www.ncbi.nlm.nih.gov/pmc/?term=28374006
32005806 |  | caudal segment of aIC | Agranular insular area | -0.5 | 3.85 | -2.82 | bregma | 0.5 | 0.0 | -2.82 | high | 3.85 | n | ML from +/- (high): 3.85 | AP->neg(caudal/posterior) |  | For caudal segment of aIC injection, 150 nl of virus was injected unilaterally on site (+0.5 mm antero-posterior (AP); ±3.85 mm medio-lateral (ML); −2.82 mm dorso-ventral (DV) relative to Bregma). | https://pubmed.ncbi.nlm.nih.gov/32005806/ | https://www.ncbi.nlm.nih.gov/pmc/?term=32005806
30534060 |  | aINS | Agranular insular area, dorsal part |  |  |  |  |  |  |  | none |  | n |  | ML_not_found | Viral injections in the ACC and aINS were performed with either 100 nL of retrograde AAV vector expressing a green fluorescent protein under the hSyn (human synapsin) promoter (rAAV2-retro-JAWS-KGC-GFP; Addgene reference #65014-AAVrg; Plasmid #81070) or 100 nL of retrograde AAV expressing a td Tomato tag under the CAG (chicken beta-actin) promoter (rAAV2-retro-CAG-td-tomato; Addgene reference #59462-AAVrg; Plasmid #81070) ( Tervo et al., 2016 ). | https://pubmed.ncbi.nlm.nih.gov/30534060/ | https://www.ncbi.nlm.nih.gov/pmc/?term=30534060
18455706 |  | amygdala | Amygdala |  |  |  |  |  |  |  | none |  | n |  | ML_not_found | We previously developed a model of focally-evoked seizure-induced neuronal death using intra-amygdala kainic acid (KA) microinjection and characterized the acute hippocampal pathology. | https://pubmed.ncbi.nlm.nih.gov/18455706/ | https://www.ncbi.nlm.nih.gov/pmc/?term=18455706
28439227 |  | amygdala | Amygdala | -1.5 | 3.0 | -3.5 | bregma | -1.5 | 0.0 | -3.5 | high | 3 | n | ML from +/- (high): 3 |  | for amygdala coordinates were AP, −1.5; L, ±3; and DV, −3.5; from Bregma in accordance with the atlas of Paxinos and Franklin ( 2013 ). | https://pubmed.ncbi.nlm.nih.gov/28439227/ | https://www.ncbi.nlm.nih.gov/pmc/?term=28439227
31632244 |  | right amygdala | Amygdala |  |  |  |  |  |  |  | none |  | n |  | ML_not_found | A 500-nl viral solution containing 4.9 × 10 9 genomic copies/μl of AAV5-hSyn-HA-hM4D(G i )-mCherry (Penn Vector Core, Philadelphia, PA, United States) or control virus comprising 4.6 × 10 9 genomic copies/μl of AAV5-hSyn-EGFP (Penn Vector Core) was i… To analyze the role of the right amygdala… | https://pubmed.ncbi.nlm.nih.gov/31632244/ | https://www.ncbi.nlm.nih.gov/pmc/?term=31632244
32218734 |  | amygdala | Amygdala |  |  |  |  |  |  |  | none |  | n |  | ML_not_found | (C) target sites for microinjection into the amygdala. Schematic representation of microinjection sites into the amygdala. Gray region represent the sites of drug infusion that were on-target in the amygdala (D) photomicrograph of a coronal section of a representative subject showing an injection site in the mouse amygdala. | https://pubmed.ncbi.nlm.nih.gov/32218734/ | https://www.ncbi.nlm.nih.gov/pmc/?term=32218734
15813993 |  | ACC | Anterior cingulate area | 0.62 |  |  | bregma | 0.62 |  |  | none |  | n |  | ML_not_found | Activation of metabotropic glutamate receptors in the ACC caused long-term fear memory. (a) ACC tACPD microinjection (0.25 μg in 0.5 μl; indicated by an arrow) was paired with a tone (indicated by filled bar) on the conditioning day; (b, c) Percentage freezing to the tone ( b ) and the conditioning context ( c ) measured at 1 day and 3 days after paired training (n = 5 mice). * P < 0.05 compared with the control. (d) The sites in the ACC for tACPD microinjection on the schematic representation of coronal section 0.62 mm anterior to the Bregma. | https://pubmed.ncbi.nlm.nih.gov/15813993/ | https://www.ncbi.nlm.nih.gov/pmc/?term=15813993
18826591 |  | anterior cingulate cortex (ACC) | Anterior cingulate area |  |  |  |  |  |  |  | none |  | n |  | ML_not_found | Effects of Ro25-6981 on LTP induced by different protocols in the anterior cingulate cortex (ACC) and hippocampal CA1 region | https://pubmed.ncbi.nlm.nih.gov/18826591/ | https://www.ncbi.nlm.nih.gov/pmc/?term=18826591
19404242 |  | Cingulate | Anterior cingulate area | -2.0 | 2.5 | 2.3 | bregma | 2.0 | 0.0 | -2.3 | disambig | 1.5;2.5 | n | ML from +/- (DV-disambig): 1.5;2.5 -> 2.5 | AP->neg(caudal/posterior) | DV->pos(below surface) |  | Coordinates determined from bregma using the mouse brain atlas ( Paxinos and Franklin, 2001 ) were as follows: Hippocampus: −1.7 mm posterior; ±1.5 mm mediolateral; −2.3 mm ventral; Cingulate: +2.0 mm anterior; ±1.5 mm mediolateral (±2.5 mm mediolateral for lateral controls); −2.3 mm ventral (−4.0 mm ventral for below controls); it should be noted that in rats, functional differences in rostral (2.6 AP rats) and caudal (0.2 AP rats) anterior cingulate cortex ( Johansen et al , 2001 ; Malin et al , 2007 ) exist. | https://pubmed.ncbi.nlm.nih.gov/19404242/ | https://www.ncbi.nlm.nih.gov/pmc/?term=19404242
19404242 |  | Cingulate lateral controls | Anterior cingulate area | -2.0 | 2.5 | 2.3 | bregma | 2.0 | 0.0 | -2.3 | disambig | 1.5;2.5 | n | ML from +/- (DV-disambig): 1.5;2.5 -> 2.5 | AP->neg(caudal/posterior) | DV->pos(below surface) |  | Coordinates determined from bregma using the mouse brain atlas ( Paxinos and Franklin, 2001 ) were as follows: Hippocampus: −1.7 mm posterior; ±1.5 mm mediolateral; −2.3 mm ventral; Cingulate: +2.0 mm anterior; ±1.5 mm mediolateral (±2.5 mm mediolateral for lateral controls); −2.3 mm ventral (−4.0 mm ventral for below controls); it should be noted that in rats, functional differences in rostral (2.6 AP rats) and caudal (0.2 AP rats) anterior cingulate cortex ( Johansen et al , 2001 ; Malin et al , 2007 ) exist. | https://pubmed.ncbi.nlm.nih.gov/19404242/ | https://www.ncbi.nlm.nih.gov/pmc/?term=19404242
19404242 |  | Cingulate below controls | Anterior cingulate area | -2.0 | 2.5 | 4.0 | bregma | 2.0 | 0.0 | -4.0 | disambig | 1.5;2.5 | n | ML from +/- (DV-disambig): 1.5;2.5 -> 2.5 | AP->neg(caudal/posterior) | DV->pos(below surface) |  | Coordinates determined from bregma using the mouse brain atlas ( Paxinos and Franklin, 2001 ) were as follows: Hippocampus: −1.7 mm posterior; ±1.5 mm mediolateral; −2.3 mm ventral; Cingulate: +2.0 mm anterior; ±1.5 mm mediolateral (±2.5 mm mediolateral for lateral controls); −2.3 mm ventral (−4.0 mm ventral for below controls); it should be noted that in rats, functional differences in rostral (2.6 AP rats) and caudal (0.2 AP rats) anterior cingulate cortex ( Johansen et al , 2001 ; Malin et al , 2007 ) exist. | https://pubmed.ncbi.nlm.nih.gov/19404242/ | https://www.ncbi.nlm.nih.gov/pmc/?term=19404242
25568101 |  | ACC | Anterior cingulate area |  |  |  |  |  |  |  | none |  | n |  | ML_not_found | Disrupting the interaction of Cav-1 and NR2B through microinjection of a short peptide derived from the C-terminal of NR2B into the ACC exhibited a significant anti-nociception effect associated with decrease of surface NR2B expression. | https://pubmed.ncbi.nlm.nih.gov/25568101/ | https://www.ncbi.nlm.nih.gov/pmc/?term=25568101
26697233 |  | anterior cingulate cortex | Anterior cingulate area |  |  |  |  |  |  |  | none |  | n |  | ML_not_found | The same effects occurred when Hup A was infused into the anterior cingulate cortex. | https://pubmed.ncbi.nlm.nih.gov/26697233/ | https://www.ncbi.nlm.nih.gov/pmc/?term=26697233
30534060 |  | ACC | Anterior cingulate area |  |  |  |  |  |  |  | none |  | n |  | ML_not_found | Viral injections in the ACC and aINS were performed with either 100 nL of retrograde AAV vector expressing a green fluorescent protein under the hSyn (human synapsin) promoter (rAAV2-retro-JAWS-KGC-GFP; Addgene reference #65014-AAVrg; Plasmid #81070) or 100 nL of retrograde AAV expressing a td Tomato tag under the CAG (chicken beta-actin) promoter (rAAV2-retro-CAG-td-tomato; Addgene reference #59462-AAVrg; Plasmid #81070) ( Tervo et al., 2016 ). | https://pubmed.ncbi.nlm.nih.gov/30534060/ | https://www.ncbi.nlm.nih.gov/pmc/?term=30534060
31041693 |  | ACC | Anterior cingulate area |  |  |  |  |  |  |  | none |  | n |  | ML_not_found | Knockdown of CXCR5 by microinjection of Cxcr5 shRNA into the ACC did not affect SNL-induced mechanical allodynia but effectively alleviated neuropathic pain-related place avoidance behavior. Finally, superfusion of CXCL13 onto ACC slices increased the frequency and amplitude of spontaneous EPSCs. Pre-injection of Cxcr5 shRNA into the ACC reduced the increase in glutamatergic synaptic transmission induced by SNL. | https://pubmed.ncbi.nlm.nih.gov/31041693/ | https://www.ncbi.nlm.nih.gov/pmc/?term=31041693
31371454 |  | ACC | Anterior cingulate area |  |  |  |  |  |  |  | none |  | n |  | ML_not_found | All other implanted mice had fiber tracks histologically verified as accurately targeting the ACC or dHC. | https://pubmed.ncbi.nlm.nih.gov/31371454/ | https://www.ncbi.nlm.nih.gov/pmc/?term=31371454
22827928 |  | rostral anterior cingulate cortex (rACC) | Anterior cingulate area, dorsal part |  |  |  |  |  |  |  | none |  | n |  | ML_not_found | This placebo analgesia can be blocked by injection of 5 mg/kg dose naloxone or by microinjection with naloxone (1, 3 or 10 &#x3bc;g/rat) into rostral anterior cingulate cortex (rACC). Then, animals were tested after intra-rACC microinjection of D-Phe-Cys-Tyr-D-Trp-Orn-Thr-Pen-Thr-NH(2) (CTOP, a selective &#x3bc;-opioid receptor antagonist) or naltrindole (NTI, a highly selective &#x3b4;-opioid receptor antagonist) or nor-binaltorphimine (nor-BNI, a highly selective &#x3ba;-opioid receptor antagonist). | https://pubmed.ncbi.nlm.nih.gov/22827928/ | https://www.ncbi.nlm.nih.gov/pmc/?term=22827928
24555533 |  | rACC | Anterior cingulate area, dorsal part |  |  |  |  |  |  |  | none |  | n |  | ML_not_found | To examine the contribution of dopamine in the ACC to pain behavior induced by formalin s.c. injection, dopamine D1 receptor antagonist SCH23390 was microinjected into the rACC. In mice injected the SCH23390 into the rACC, the exposing to lemon oil did not decrease the time of licking of injected paw in comparison to that in control mice which was not injected SCH23390 and exposed to the tri… | https://pubmed.ncbi.nlm.nih.gov/24555533/ | https://www.ncbi.nlm.nih.gov/pmc/?term=24555533
32602858 |  | anterior hypothalamus (AH) | Anterior hypothalamic nucleus |  |  |  |  |  |  |  | none |  | n |  | ML_not_found | The purpose of this study was to investigate whether the panicolytic‐like effect of different doses of anandamide microinjected into the anterior hypothalamus (AH) follows the same pattern of a bell‐shaped dose‐response curve observed with the same dose treatment in dorsomedial and ventromedial hypothalamus. We investigated this assumption by administering the cannabinoid and vanilloid receptor agonist anandamide into the anterior hypothalamus of mice and exposing them to the real threatening situation by using our experimental model based on confrontations between rodents and wild snakes. | https://pubmed.ncbi.nlm.nih.gov/32602858/ | https://www.ncbi.nlm.nih.gov/pmc/?term=32602858
25071454 |  | AON | Anterior olfactory nucleus | 3.08 |  |  | bregma |  |  |  | none |  | n | AP recovered: 3.08 | reference->bregma | ML_not_found | GCaMP3 expression after unilateral viral injection into AON of a Chrna7-Cre mouse. (A) Schematic diagram (Bregma 3.08 mm, section from atlas (Paxinos and Franklin, 2001 )) depicting genetically-targeted AON projections to the ipsilateral and contralateral OB. We focused on projections to the OB from the anterior olfactory nucleus (AON), a major source of cortical feedback to the OB. We expressed GCaMP selectively in AON projection neurons using a mouse line expressing Cre recombinase (Cre) in these neurons and Cre-dependent viral vectors injected into AON, allowing us to image GCaMP fluorescence signals from their axon terminals in the OB. | https://pubmed.ncbi.nlm.nih.gov/25071454/ | https://www.ncbi.nlm.nih.gov/pmc/?term=25071454
25698936 |  | AON | Anterior olfactory nucleus |  |  |  |  |  |  |  | none |  | n |  | ML_not_found | injections were aimed at the AON (Figure 1A ) | https://pubmed.ncbi.nlm.nih.gov/25698936/ | https://www.ncbi.nlm.nih.gov/pmc/?term=25698936
25232307 |  | secondary visual cortex area AL | Anterolateral visual area |  |  |  |  |  |  |  | none |  | n |  | ML_not_found | The distribution of tdTomato labeling 15 days after injection of PRV-hSyn-Cre into the secondary visual cortex area AL of an Ai14 mouse is shown in Figure 4 . | https://pubmed.ncbi.nlm.nih.gov/25232307/ | https://www.ncbi.nlm.nih.gov/pmc/?term=25232307
20041129 |  | arcuate nucleus of the hypothalamus (ARC) | Arcuate hypothalamic nucleus |  |  |  |  |  |  |  | none |  | n |  | ML_not_found | Ten 24 hour-fasted wild type mice and 8 ad libitum -fed unilaterally AAV-Cre-injected Y4 lox/lox conditional knockout mice were injected with either PP (i.p. 200 µg/kg) or saline in a volume of 10 ml/kg between 10:00 to 12:00 hours. Conditional deletion of Y4 receptors in the arcuate nucleus of the hypothalamus (ARC) alters pancreatic polypeptide (PP)-induced c-Fos immunoreactivity and POMC mRNA expression. | https://pubmed.ncbi.nlm.nih.gov/20041129/ | https://www.ncbi.nlm.nih.gov/pmc/?term=20041129
23554574 |  | arcuate nucleus (Arc) | Arcuate hypothalamic nucleus |  |  |  |  |  |  |  | none |  | n |  | ML_not_found | Recombinant adeno-associated virus (rAAV)-mediated Ugcg delivery to the arcuate nucleus (Arc) significantly ameliorated obesity, specifying gangliosides as seminal components for hypothalamic regulation of body energy homeostasis. | https://pubmed.ncbi.nlm.nih.gov/23554574/ | https://www.ncbi.nlm.nih.gov/pmc/?term=23554574
28446241 |  | arcuate nucleus | Arcuate hypothalamic nucleus |  |  |  |  |  |  |  | none |  | n |  | ML_not_found | The sequences LV1 and LV2 were utilized in in vivo experiments and were injected bilaterally into the arcuate nucleus ( b ). Swiss mice were fed for 4 weeks on a high-fat diet (HFD) and then injected with LV1 or the scrambled control construct into the arcuate nucleus bilaterally; after 10 weeks, the mice were subjected to intracerebroventricular c… | https://pubmed.ncbi.nlm.nih.gov/28446241/ | https://www.ncbi.nlm.nih.gov/pmc/?term=28446241
29689050 |  | ARC | Arcuate hypothalamic nucleus |  |  |  |  |  |  |  | none |  | n |  | ML_not_found | mice injected with Trpv1 sgRNA in the ARC of POMC-Cre;;CRISPR/Cas9 mice. (A) Representative trace of whole cell patch-clamp recording of POMC neurons from mice injected with Trpv3 and Trpv4 shRNA into the ARC. | https://pubmed.ncbi.nlm.nih.gov/29689050/ | https://www.ncbi.nlm.nih.gov/pmc/?term=29689050
31419363 |  | arcuate nucleus of the hypothalamus (ARH) | Arcuate hypothalamic nucleus |  |  |  |  |  |  |  | none |  | n |  | ML_not_found | The cell counts for each animal were normalised by dividing the number of neurones found in each region by the number of cells in the arcuate nucleus of the hypothalamus (ARH) (site of injection; see Results ). The arcuate nucleus of the hypothalamus (ARH) of male and female dat::cre mice were initially unilaterally injected with adeno‐associated virus ( AAV) carrying the TVA and G transgene to restrict the starter population; 14 days later, animals were injected with the modified rabies virus. | https://pubmed.ncbi.nlm.nih.gov/31419363/ | https://www.ncbi.nlm.nih.gov/pmc/?term=31419363
32302532 |  | ARC | Arcuate hypothalamic nucleus |  |  |  |  |  |  |  | none |  | n |  | ML_not_found | (A) Injection of AAV-ChR2-mCherry into the ARC. | https://pubmed.ncbi.nlm.nih.gov/32302532/ | https://www.ncbi.nlm.nih.gov/pmc/?term=32302532
19584920 |  | left auditory cortex | Auditory areas |  |  |  |  |  |  |  | none |  | n |  | ML_not_found | To express ChR2 in inhibitory parvalbumin expressing neurons of the mouse auditory cortex, we injected AAV carrying floxed ChR2-YFP in the left auditory cortex of PV-Cre mice, which express Cre recombinase only in fast-spiking interneurons. | https://pubmed.ncbi.nlm.nih.gov/19584920/ | https://www.ncbi.nlm.nih.gov/pmc/?term=19584920
27159237 |  | right auditory cortex (AC) | Auditory areas |  |  |  |  |  |  |  | none |  | n |  | ML_not_found | we conditionally expressed GFP in somatostatin-expressing (SOM) interneurons by injecting AAV.GFP.Flex into the right auditory cortex (AC) of SOM-Cre-tdTomato transgenic mice ( Figure 1a ). | https://pubmed.ncbi.nlm.nih.gov/27159237/ | https://www.ncbi.nlm.nih.gov/pmc/?term=27159237
27159237 |  | auditory cortex | Auditory areas |  |  |  |  |  |  |  | none |  | n |  | ML_not_found | Photostimulation of auditory CS-SOM projections elicits direct inhibition and modulates action potentials in striatal SPNs. ( a ) Schematic depicting injection site using the SOM-Cre transgenic mouse line to transfect CS-SOM projections to the dorsal striatum with ChR2. Bottom, auditory cortex: AAV.ChR2.flex injection site. | https://pubmed.ncbi.nlm.nih.gov/27159237/ | https://www.ncbi.nlm.nih.gov/pmc/?term=27159237
30735128 |  | ACtx | Auditory areas | -2.0 |  |  | lambda | 2.0 |  |  | none |  | n | AP->neg(caudal/posterior) | ML_not_found | For viral delivery to the ACtx, an incision was made to the right side of the scalp to expose the skull around the caudal end of the temporal ridge. The temporalis muscle was then retracted and two burr holes (approximately 0.3 mm each) were made along the temporal ridge, spanning a region of 1.5–2.5 mm rostral to the lambdoid suture. A motorized stereotaxic injection system (Stoelting Co.) was used to inject 0.5 μl of either a non-specific ChR2 viral v… | https://pubmed.ncbi.nlm.nih.gov/30735128/ | https://www.ncbi.nlm.nih.gov/pmc/?term=30735128
31422881 |  | Bar | Barrington's nucleus |  |  |  |  |  |  |  | none |  | n |  | ML_not_found |  | https://pubmed.ncbi.nlm.nih.gov/31422881/ | https://www.ncbi.nlm.nih.gov/pmc/?term=31422881
27161525 |  | basal forebrain nuclei | Basal forebrain |  |  |  |  |  |  |  | none |  | n |  | ML_not_found | Viruses were injected into the basal forebrain nuclei of ChAT-Cre mice at one week post weaning ( Fig 1B , top), resulting in robust expression of the labeled opto-probes in ChAT positive (cholinergic) neurons in the NBM and throughout the cholinergic terminal fields within the BLA 2–4 weeks post-infection ( Fig 1C top). | https://pubmed.ncbi.nlm.nih.gov/27161525/ | https://www.ncbi.nlm.nih.gov/pmc/?term=27161525
30013200 |  | basal forebrain (BF) | Basal forebrain |  |  |  |  |  |  |  | none |  | n |  | ML_not_found | we infused a non-degradable ATP analog, ATP-γ-S 3 , 22 , or artificial cerebrospinal fluid (ACSF) into BF via reverse microdialysis during the 3 hour recovery period following 4 hours of SD | https://pubmed.ncbi.nlm.nih.gov/30013200/ | https://www.ncbi.nlm.nih.gov/pmc/?term=30013200
32413301 |  | basal forebrain (BF) | Basal forebrain |  |  |  |  |  |  |  | none |  | n |  | ML_not_found | Viral vectors (500 nL for AAV-DIO-ChR2-EYFP; 1 uL for AAV-FLEX-ArchT) were bilaterally … | https://pubmed.ncbi.nlm.nih.gov/32413301/ | https://www.ncbi.nlm.nih.gov/pmc/?term=32413301
32413301 |  | basal forebrain (BF) | Basal forebrain |  |  |  |  |  |  |  | none |  | n |  | ML_not_found | Viral vectors (500 nL for AAV-DIO-ChR2-EYFP; 1 uL for AAV-FLEX-ArchT) were bilaterally … | https://pubmed.ncbi.nlm.nih.gov/32413301/ | https://www.ncbi.nlm.nih.gov/pmc/?term=32413301
25162525 |  | basolateral complex of the amygdala (BLA) | Basolateral amygdalar complex |  |  |  |  |  |  |  | none |  | n |  | ML_not_found | Once the target site was reached, the needle was held in place for 5 minutes prior to the injection of 200 nl of virus at a rate of 70 nl/min. Here we investigated these mechanisms by applying the recently developed memory engram cell- manipulation technique. We labelled with channelrhodopsin-2 (ChR2) a population of cells in either the dorsal dentate gyrus (DG) of the hippocampus or the basolateral complex of the amygdala (BLA) that were specifically activated during contextual fear or reward conditioning. | https://pubmed.ncbi.nlm.nih.gov/25162525/ | https://www.ncbi.nlm.nih.gov/pmc/?term=25162525
19741115 |  | basolateral amygdala | Basolateral amygdalar nucleus | -1.5 | 0.0 | 5.0 | bregma | -1.5 | 3.25 | 5.0 | llm |  | n | ML->0 (midline) |  | For specific restoration of BLA DA, Recombinant CAV2-Cre virus (titered at 2.1×1012 particles/ml) was injected bilaterally (coordinates in mm: 1.5 posterior to Bregma, 3.25 lateral to midline, 5 ventral to Bregma; 0.5 μl/hemisphere). | https://pubmed.ncbi.nlm.nih.gov/19741115/ | https://www.ncbi.nlm.nih.gov/pmc/?term=19741115
20092560 |  | basolateral/central nuclei of the amygdala (BLA/CE) | Basolateral amygdalar nucleus | 1.22 | 2.85 | -4.5 | bregma | -1.22 | 0.0 | -4.5 | disambig | 1.26;2.85 | n | ML from +/- (DV-disambig): 1.26;2.85 -> 2.85 | AP->pos(rostral/anterior) |  | one cannula was aimed at the nucleus accumbens core (AcbC) (from Bregma: anterior (A) + 1.40, lateral (L) ± 1.26, ventral (V) −4.2) while the second was aimed at the basolateral/central nuclei of the amygdala (BLA/CE) (from Bregma: A – 1.22, L ± 2.85, V – 4.5; Franklin, 2001 ) either ipsi- or contra-lateral to the first. | https://pubmed.ncbi.nlm.nih.gov/20092560/ | https://www.ncbi.nlm.nih.gov/pmc/?term=20092560
20856811 |  | BLA | Basolateral amygdalar nucleus | -1.5 | 0.0 | 5.0 | bregma | -1.5 | 3.25 | 5.0 | llm |  | n | ML->0 (midline) |  | For double restoration of DA to the NAc and BLA, CAV2-Cre virus was injected bilaterally into the NAc, as above, and the BLA (coordinates in mm: 1.5 posterior to Bregma, 3.25 lateral to midline, 5 ventral to Bregma; 0.5 µl/hemisphere) in DD and control mice. | https://pubmed.ncbi.nlm.nih.gov/20856811/ | https://www.ncbi.nlm.nih.gov/pmc/?term=20856811
21917789 |  | basolateral amygdala (BLA) | Basolateral amygdalar nucleus | -1.8 | 3.2 | 4.9 | bregma | -1.8 | 3.2 | -4.9 | llm | 3.2 | n | DV->pos(below surface) |  | BLA coordinates were as follows: anteriorposterior, −1.8; dorsoventral, −4.9; mediolateral, ± 3.2 relative to bregma. Dorsoventral coordinates were measured from the skull surface with the internal cannula extending 2 mm beyond the end of the guide cannula. | https://pubmed.ncbi.nlm.nih.gov/21917789/ | https://www.ncbi.nlm.nih.gov/pmc/?term=21917789
22828749 |  | basolateral amygdala (BLA) | Basolateral amygdalar nucleus |  |  |  |  |  |  |  | none |  | n |  | ML_not_found | Intra-BLA infusions of TFF3 (1 ng/side) exerted rapid antidepressant-like effects in the rat FST. Finally, intra-BLA infusions of LY294002 (5 mM/side), a specific phosphatidylinositol 3-kinase (PI3K) inhibitor, significantly blocked the antidepressant-like effect of TFF3. | https://pubmed.ncbi.nlm.nih.gov/22828749/ | https://www.ncbi.nlm.nih.gov/pmc/?term=22828749
23149445 |  | lateral and basolateral amygdala (BLA) | Basolateral amygdalar nucleus | -1.4 | 3.3 | -5.0 | bregma | -1.4 | 0.0 | -5.0 | high | 3.3 | n | ML from +/- (high): 3.3 |  | Mice received bilateral microinjections of either the LV-siGAD67 or the control LV-SCR into the lateral and basolateral amygdala (BLA). A 30-gauge Hamilton microsyringe was lowered to the following coordinates from bregma based on the mouse brain atlas of Paxinos and Franklin: 49 AP=−1.4, ML=±3.3, DV=−5.0. The microsyringe was left in place 10 min before and after each injection, and a total volume of 1.0 μl LV-siGAD67 or LV-SCR was administered at a rate of 0.05 μl per min at each site. | https://pubmed.ncbi.nlm.nih.gov/23149445/ | https://www.ncbi.nlm.nih.gov/pmc/?term=23149445
23515158 |  | BLA | Basolateral amygdalar nucleus |  |  |  |  |  |  |  | none |  | n |  | ML_not_found | Viral stock (0.5 μl) was injected stereotactically into the BLA, BNST, lateral hypothalamus, parabrachial nucleus or VTA. | https://pubmed.ncbi.nlm.nih.gov/23515158/ | https://www.ncbi.nlm.nih.gov/pmc/?term=23515158
24742621 |  | basolateral nucleus of the amygdala (BLA) | Basolateral amygdalar nucleus |  |  |  | bregma |  |  |  | none |  | n |  | ML_not_found | AAV-shCnB or AAV-Scr was infused into the basolateral nucleus of the amygdala (BLA) under isofluorane anesthesia. 0.5 μl of AAV-shCnB or AAV-Scr was infused bilaterally into the BLA over 5 min using a 29G, beveled-tipped Hamilton syringe (Hamilton, Reno, NE). Coordinates for the stereotaxic injections (relative to bregma) were determined in a stereotaxic atlas (Paxin… | https://pubmed.ncbi.nlm.nih.gov/24742621/ | https://www.ncbi.nlm.nih.gov/pmc/?term=24742621
25972785 |  | basolateral amygdala (BLA) | Basolateral amygdalar nucleus |  |  |  |  |  |  |  | none |  | n |  | ML_not_found | we injected fluorescent retrograde tracers into the PAG ( Figures 1A,B ) or BLA ( Figures 1C,D ) (C) Schematic depicting the injection of retrograde fluorescent tracer injection into the basolateral amygdala (BLA). (D) Bright-field image (top) of coronal brain slice (300 μm) containing the BLA and the corresponding epifluorescence image (bottom) confirming the location of retrograde tracer injection. | https://pubmed.ncbi.nlm.nih.gov/25972785/ | https://www.ncbi.nlm.nih.gov/pmc/?term=25972785
26711908 |  | basolateral amygdala (BLA) | Basolateral amygdalar nucleus |  |  |  |  |  |  |  | none |  | n |  | ML_not_found | Furthermore, since previous administration of MG had been systemic, we sought to determine if direct microinjection of MG into the basolateral amygdala (BLA) was sufficient to reduce anxiety-like behavior. Thus, we performed bilateral microinj… | https://pubmed.ncbi.nlm.nih.gov/26711908/ | https://www.ncbi.nlm.nih.gov/pmc/?term=26711908
28235423 |  | basolateral amygdala | Basolateral amygdalar nucleus |  |  |  |  |  |  |  | none |  | n |  | ML_not_found | In this model, status epilepticus is induced by a unilateral microinjection of kainic acid (KA) into the basolateral amygdala. Status epilepticus was induced by an intra-amygdala injection of 0.3 μg KA and neuronal cell death was assessed 24 h later by counting FjB-positive cells in the ipsilateral hippocampal subfield CA3. Here, status epilepticus was induced by an intra-amygdala injection of 1.0 μg KA and neurodegeneration analyzed by counting FjB-positive cells in the hippocampal subfield CA3 24 h post-KA injection. To determine whether seizures lead to an impairment of the UPS, we used a mouse model of status epilepticus whereby seizures are triggered by an intra-amygdala injection of kainic acid. | https://pubmed.ncbi.nlm.nih.gov/28235423/ | https://www.ncbi.nlm.nih.gov/pmc/?term=28235423
28318784 |  | basolateral amygdala (BLA) | Basolateral amygdalar nucleus | -1.65 | 3.75 | -3.8 | bregma | -1.65 | 0.0 | -3.8 | high | 3.75 | n | ML from +/- (high): 3.75 |  | Virus (1 μl/site) was bilaterally injected into the basolateral amygdala (BLA) (From bregma, anteroposterior [AP] −1.65 mm, mediolateral [ML] ±3.75 mm, dorsoventral [DV] −3.8 mm) using a Picospritzer III (Parker) at a rate of 0.2 μl/min. | https://pubmed.ncbi.nlm.nih.gov/28318784/ | https://www.ncbi.nlm.nih.gov/pmc/?term=28318784
28555077 |  | basolateral amygdala (BLA) | Basolateral amygdalar nucleus |  |  |  |  |  |  |  | none |  | n |  | ML_not_found | Adeno-associated virus (AAV)-CamKIIa-ChR2-EYFP-CaMKIIa-ChR2-EYFP (University of North Carolina) was injected in the basolateral amygdala (BLA), ventral hippocampus or medial prefrontal cortex (mPFC) using stereotaxic surgery. Virus (0.5 μl) was delivered per hemisphere at a flow rate of 0.1 μl min −1 followed by a 5 min inactive period to allow for viral diffusion. | https://pubmed.ncbi.nlm.nih.gov/28555077/ | https://www.ncbi.nlm.nih.gov/pmc/?term=28555077
28689641 |  | BLA | Basolateral amygdalar nucleus |  |  |  |  |  |  |  | none |  | n |  | ML_not_found | (D) AAV-FLEX TVAmCherry-oG was injected in NAc and AAV-FRT nucGFP in BLA of VGAT::CRE mice. | https://pubmed.ncbi.nlm.nih.gov/28689641/ | https://www.ncbi.nlm.nih.gov/pmc/?term=28689641
28825718 |  | BLA | Basolateral amygdalar nucleus | -1.6 | 3.125 | 3.75 | bregma | -1.6 | 3.125 | 3.75 | llm |  | n |  | ML_mismatch(llm=3.125;quote=na) | Bregma coordinates were identified for 4 brain areas: PL and contralateral PL(cPL) (antero-posterior, A/P: 2.0 mm; medio-lateral, M/L: 0.2–0.3 mm; Dorso-ventral, D/V: 1.5 mm depth from the pial surface), BLA (A/P: −1.6mm, M/L: 3.0–3.25 mm; D/V: 3.75 mm), dorsomedial striatum (A/P: 1.0 mm; An incision was made over the scalp, a small burr hole was made into the skull and brain surface was exposed. A pulled glass pipette tip of 20–30 µm containing virus or tracers was lowered into the brain. Pulses were delivered using a Picospritzer (General Valve Corp) at a rate of 30 nl/minute; the pipette was left in the brain for 5–10 minutes to prevent backflow 50 . | https://pubmed.ncbi.nlm.nih.gov/28825718/ | https://www.ncbi.nlm.nih.gov/pmc/?term=28825718
29609111 |  | basolateral amygdala | Basolateral amygdalar nucleus | -1.6 | 3.1 | -4.8 | bregma | -1.6 | 0.0 | -4.8 | high | 3.1 | n | ML from +/- (high): 3.1 |  | After identification of bregma and leveling of the skull, 0.28 mm diameter holes were drilled bilaterally (A/P: −1.6, M/L: ±3.1) for microinjections of virus. Cannulas (33 gauge) were inserted bilaterally into the basolateral amygdala (D/V: −4.8) and 1 μl of virus was infused per side at a rate of 0.2 μl per minute. | https://pubmed.ncbi.nlm.nih.gov/29609111/ | https://www.ncbi.nlm.nih.gov/pmc/?term=29609111
30925893 |  | basolateral amygdala (BLA) | Basolateral amygdalar nucleus |  |  |  |  |  |  |  | none |  | n |  | ML_not_found | They were then injected with ZIP in the basolateral amygdala (BLA) in 24 h and tested again in 48 h. | https://pubmed.ncbi.nlm.nih.gov/30925893/ | https://www.ncbi.nlm.nih.gov/pmc/?term=30925893
31801602 |  | BLA | Basolateral amygdalar nucleus |  |  |  |  |  |  |  | none |  | n |  | ML_not_found | Injection of AAV-Arch3.0 constructs into the BLA followed by implantation of a fiberoptic cannula into the mPFC in sham and SNI operated female mice was carried out, and pain behavioral responses were measured in response to yellow light mediated activation of this inhibitory opsin. | https://pubmed.ncbi.nlm.nih.gov/31801602/ | https://www.ncbi.nlm.nih.gov/pmc/?term=31801602
32653556 |  | basolateral amygdala (BLA) | Basolateral amygdalar nucleus |  |  |  |  |  |  |  | none |  | n |  | ML_not_found |  | https://pubmed.ncbi.nlm.nih.gov/32653556/ | https://www.ncbi.nlm.nih.gov/pmc/?term=32653556
15813993 |  | BLAC | Basolateral amygdalar nucleus, anterior part | -5.0 |  |  |  |  |  |  | none |  | n | AP recovered: -5 | ML_not_found | NMDA receptors in the amygdala is required for auditory fear memory induced by ACC stimulation. (a) Bilateral microinfusions of AP-5 (2 μg/μl, 0.5 μl/side) in the BLAC 15 min before conditioning impaired … | https://pubmed.ncbi.nlm.nih.gov/15813993/ | https://www.ncbi.nlm.nih.gov/pmc/?term=15813993
31481399 |  | amygdala | Basolateral amygdalar nucleus, posterior part |  |  |  |  |  |  |  | none |  | n |  | ML_not_found | Intracranial injections of AAV5-eYFP into the LHb and into the amygdala of tdTom DAT-Cre mice verify Cre activity in these areas, and enable identification of distinct projections from each of these areas. D , Stereotaxic injections with AAV5-EF1a-DIO-eYFP into the LHb of tdTom DAT-Cre mice. eYFP (green) and tdTOM (red) immunofluorescent-positive cell bodies in the BLP of amygdala and eYFP-positive projections in ( E ) the ventral striatum (NAcC) and ( F ) the BNST (scale bar: 50 μm; inset: 25 and 40 μm). | https://pubmed.ncbi.nlm.nih.gov/31481399/ | https://www.ncbi.nlm.nih.gov/pmc/?term=31481399
23515158 |  | BNST | Bed nuclei of the stria terminalis |  |  |  |  |  |  |  | none |  | n |  | ML_not_found | Viral stock (0.5 μl) was injected stereotactically into the BLA, BNST, lateral hypothalamus, parabrachial nucleus or VTA. | https://pubmed.ncbi.nlm.nih.gov/23515158/ | https://www.ncbi.nlm.nih.gov/pmc/?term=23515158
26557053 |  | anterodorsal, anterolateral, and oval subdivisions of the BNST | Bed nuclei of the stria terminalis | 0.26 |  |  | bregma | 0.26 |  |  | none |  | n |  | ML_not_found | AAV9-Camk2a-TRAP was injected into an area containing the anterodorsal, anterolateral, and oval subdivisions of the BNST of wild type C57BL/6J mice (1:1 viral titer, 2.18 × 10 13 viral genomes/ml; bregma: 0.26 mm, targeted BNST subdivisions highlighted in green). | https://pubmed.ncbi.nlm.nih.gov/26557053/ | https://www.ncbi.nlm.nih.gov/pmc/?term=26557053
27866960 |  | bed nucleus of the stria terminalis (BNST) | Bed nuclei of the stria terminalis |  |  |  |  |  |  |  | none |  | n |  | ML_not_found | Individually, the ventral tegmental area (VTA) and the bed nucleus of the stria terminalis (BNST) have been shown to modulate cue-induced ethanol-seeking behavior. Inhibitory designer receptors exclusively activated by designer drugs (hM4Di DREADDs) were expressed in VTA-projecting BNST (BNST-VTA) cells by infusing a retrograde herpes-simplex virus encoding cre recombinase (HSV-Cre) into VTA and a cre-inducible adeno-associated virus encoding hM4Di (AAV-DIO-hM4Di) into BNST. | https://pubmed.ncbi.nlm.nih.gov/27866960/ | https://www.ncbi.nlm.nih.gov/pmc/?term=27866960
27956747 |  | bed nucleus of the stria terminalis (BNST) | Bed nuclei of the stria terminalis |  |  |  |  |  |  |  | none |  | n |  | ML_not_found |  | https://pubmed.ncbi.nlm.nih.gov/27956747/ | https://www.ncbi.nlm.nih.gov/pmc/?term=27956747
30348762 |  | BNST | Bed nuclei of the stria terminalis |  |  |  |  |  |  |  | none |  | n |  | ML_not_found | Injection of the retrograde tracer CTB (labeled with Cy3) into the VTA ( B , n = 3) or BNST ( D , n = 3) of D2R-EGFP mice. Coronal sections of the brain show the location of the VTA ( B ) or BNST ( D ) stained with DAPI (blue) and monitored for Cy3 (CTB) fluorescence (red) in the left images and of the CeA stained with DAPI and monitored for EGFP fluorescence (green) in the central images. | https://pubmed.ncbi.nlm.nih.gov/30348762/ | https://www.ncbi.nlm.nih.gov/pmc/?term=30348762
31990032 |  | Bed Nucleus of the Stria Terminalis (BNST) neurons | Bed nuclei of the stria terminalis | 0.14 |  |  | bregma | 0.14 |  |  | none |  | n |  | ML_not_found | (B) Injection of hM4Di-mCherry to BNST neurons (left: blue, DAPI; red, hM4Di-mCherry; scale bars = 100 μm; bregma: 0.14 mm. Right: sketch map). | https://pubmed.ncbi.nlm.nih.gov/31990032/ | https://www.ncbi.nlm.nih.gov/pmc/?term=31990032
27805752 |  | BNSTov | Bed nuclei of the stria terminalis, oval nucleus |  |  |  |  |  |  |  | none |  | n |  | ML_not_found | To directly address this question, we injected a 'floxed' anterograde tracer (rAAV5/EF1a-DIO-mCherry) into the BNSTov of CRFp3.0Cre GFP transgenic mice, which express a green fluorescent protein (GFP) under the control of the CRF promoter. To determine whether CRF neurons in the rat BNSTov send comparable projections, we infused rat BNSTov with an adeno-associated viral vector (AAV) in which the human synapsin promoter drives enhanced GFP expression. | https://pubmed.ncbi.nlm.nih.gov/27805752/ | https://www.ncbi.nlm.nih.gov/pmc/?term=27805752
32560730 |  | caudate putamen | CP |  |  |  |  |  |  |  | none |  | n |  | ML_not_found | LV1-miR-669c lentiviral vector was injected into the caudate putamen of C57BL/6 J mice. | https://pubmed.ncbi.nlm.nih.gov/32560730/ | https://www.ncbi.nlm.nih.gov/pmc/?term=32560730
10867973 |  | anterior caudate putamen | Caudoputamen |  |  |  |  |  |  |  | none |  | n |  | ML_not_found | BALB/c mice were unilaterally implanted with a guide-cannula above either the NAc, the anterior caudate putamen, or the posterior caudate putamen. On each experimental day, a stainless-steel injection cannula was inserted into the guide cannula to test the capacity for morphine self-administration (6.5 pmol or 65 pmol/50 nl) using a spatial discrimination task in a Y maze. | https://pubmed.ncbi.nlm.nih.gov/10867973/ | https://www.ncbi.nlm.nih.gov/pmc/?term=10867973
10867973 |  | posterior caudate putamen | Caudoputamen |  |  |  |  |  |  |  | none |  | n |  | ML_not_found | BALB/c mice were unilaterally implanted with a guide-cannula above either the NAc, the anterior caudate putamen, or the posterior caudate putamen. On each experimental day, a stainless-steel injection cannula was inserted into the guide cannula to test the capacity for morphine self-administration (6.5 pmol or 65 pmol/50 nl) using a spatial discrimination task in a Y maze. | https://pubmed.ncbi.nlm.nih.gov/10867973/ | https://www.ncbi.nlm.nih.gov/pmc/?term=10867973
16166396 |  | dorsal striatum | Caudoputamen | -5.0 |  |  |  |  |  |  | none |  | n | AP recovered: -5 | ML_not_found | Furthermore, they demonstrate that AP-5 (37.5, 75, and 150 ng/side) injections into the dorsal striatum selectively impaired consolidation of spatial information in the egocentric but not in the allocentric procedure. | https://pubmed.ncbi.nlm.nih.gov/16166396/ | https://www.ncbi.nlm.nih.gov/pmc/?term=16166396
21658580 |  | dorsolateral striatum | Caudoputamen |  |  |  |  |  |  |  | none |  | n |  | ML_not_found | Injections were made in the mPFC, NAc medial shell, and NAc lateral shell to label VTA DA neurons as well as the dorsolateral striatum for labeling of nigrostriatal DA cells ( Figure 1A ). | https://pubmed.ncbi.nlm.nih.gov/21658580/ | https://www.ncbi.nlm.nih.gov/pmc/?term=21658580
25830919 |  | dorsal striatum | Caudoputamen | -0.5 | 0.0 | 2.25 | dura | -0.5 | 1.75 | 2.25 | llm |  | n | ML->0 (midline) |  | For viral injection, a small 1-mm diameter hole in the skull was drilled 0.5 mm posterior to the bregma and 1.75 mm lateral to the midline. Mixtures of helper virus (AAV-DIO-EGFP-TVA and AAV-DIO-RG; 200 nL) were injected into the dorsal striatum (0.5 mm posterior to bregma, 1.75 mm lateral to the midline, 2.25 mm deep from dura) using a Nanoliter 2000 at a speed of 40 nL/min with a pulled glass pipette (Sutter Instrument). | https://pubmed.ncbi.nlm.nih.gov/25830919/ | https://www.ncbi.nlm.nih.gov/pmc/?term=25830919
27159237 |  | right dorsal striatum | Caudoputamen |  |  |  |  |  |  |  | none |  | n |  | ML_not_found | Next, to determine the layer of origin for the long-range corticostriatal SOM neurons (from this point forward referred to as CS-SOM neurons), we injected the AAV.GFP.Flex virus into the right dorsal striatum of SOM-Cre transgenic mice ( Taniguchi et al., 2011 ) ( Figure 1c ). | https://pubmed.ncbi.nlm.nih.gov/27159237/ | https://www.ncbi.nlm.nih.gov/pmc/?term=27159237
27286696 |  | striatum (caudate-putamen) | Caudoputamen |  |  |  |  |  |  |  | none |  | n |  | ML_not_found | Transgenic HEK293/mGDNF/GFP cells were transplanted into the striatum (caudate-putamen) of experimental mice. The transplantation of HEK293/mGDNF cells into the caudate-putamen 3 days prior to MPTP injection smoothed these effe… | https://pubmed.ncbi.nlm.nih.gov/27286696/ | https://www.ncbi.nlm.nih.gov/pmc/?term=27286696
28285820 |  | dorsal striatum | Caudoputamen | 0.8 | 1.75 | -2.5 | bregma | 0.8 | 1.75 | -2.5 | llm | 1.5 | n |  | ML_mismatch(llm=1.75;quote=1.5) | For voltammetry experiments, custom fabricated carbon fiber voltammetry electrodes were inserted bilaterally into dorsal striatum (+ 0.8 AP, ± 1.5–2.0 ML, − 2.5 DV) and were affixed using dental cement ( Clark et al., 2010 ). | https://pubmed.ncbi.nlm.nih.gov/28285820/ | https://www.ncbi.nlm.nih.gov/pmc/?term=28285820
28347488 |  | central dorsal striatum | Caudoputamen | 0.5 | 1.5 | -2.7 | bregma | 0.5 | 0.0 | -2.7 | high | 1.5 | n | ML from +/- (high): 1.5 |  | 0.5 μl virus was infused bilaterally into the central dorsal striatum under ketamine/xylazine anesthesia as described previously ( 21 ), targeting coordinates AP +0.5mm, ML ±1.5mm, DV −2.7 mm ( 36 ). | https://pubmed.ncbi.nlm.nih.gov/28347488/ | https://www.ncbi.nlm.nih.gov/pmc/?term=28347488
28397143 |  | right striatum | Caudoputamen |  |  |  |  |  |  |  | none |  | n |  | ML_not_found | We analysed the distribution of transduced cells with respect to brain structure, virus tropism, numbers of transduced neurons per brain, and influence of the Vpx or Vpr accessory proteins after injection of vectors based on SIVsmmPBj, HIV-2, and HIV-1 lentiviruses into the right striatum of the mouse brain. | https://pubmed.ncbi.nlm.nih.gov/28397143/ | https://www.ncbi.nlm.nih.gov/pmc/?term=28397143
30083593 |  | dorsal striatum | Caudoputamen | 0.5 | 1.75 | 3.0 | skull | 0.5 | 0.0 | 3.0 | high | 1.75 | n | ML from +/- (high): 1.75 |  | CAV2-Cre (0.5 μl, 3 × 10 12 viral genomes per μl) was stereotaxically injected bilaterally into the dorsal striatum (0.5 mm anterior to Bregma, ± 1.75 mm lateral to midline, 3.0 mm ventral from the skull surface) using the Allen Mouse Brain Atlas as a guide. | https://pubmed.ncbi.nlm.nih.gov/30083593/ | https://www.ncbi.nlm.nih.gov/pmc/?term=30083593
30136928 |  | dorsal striatum (DS) | Caudoputamen |  |  |  |  |  |  |  | none |  | n |  | ML_not_found | Five independent groups of tdTomato-ROSA26 reporter mice (N = 3 for each group, age P20) were injected in the dorsal striatum (DS) with 500 nl of viral suspension (9*10 13 genomes/ml) of AAV9-SLR, AAV9-NSS, AAV9-RGD and, for comparison, WT-AAV9 and WT-AAV2 ( Figure 1B ). | https://pubmed.ncbi.nlm.nih.gov/30136928/ | https://www.ncbi.nlm.nih.gov/pmc/?term=30136928
30487652 |  | medial caudate | Caudoputamen | 12.5 | 2.2 | 12.0 | interaural line | 12.5 | 0.0 | 12.0 | high | 2.2 | n | ML from +/- (high): 2.2 |  | guide cannulae (C316G; Plastics One, Inc., Roanoke, VA, USA) were lowered at a 10° lateral angle (away from the midline), toward the target locations in medial caudate (Fig. AP +12.5, LM ±2.2, V +12.0 from the interaural line). | https://pubmed.ncbi.nlm.nih.gov/30487652/ | https://www.ncbi.nlm.nih.gov/pmc/?term=30487652
32068967 |  | dorsal striatum | Caudoputamen |  |  |  |  |  |  |  | none |  | n |  | ML_not_found | AAVs encoding Napa-a and Napa-n are locally microinjected in the motor cortex and the dorsal striatum, respectively. | https://pubmed.ncbi.nlm.nih.gov/32068967/ | https://www.ncbi.nlm.nih.gov/pmc/?term=32068967
32666590 |  | dorsal striatum | Caudoputamen | 0.65 | 2.0 | -3.75 | bregma | 0.65 | 2.0 | -3.75 | llm |  | n |  | ML_noncoord?(2 μL) | Microinjections of 6‐OHDA A subthreshold dose (2.5 μg/μL in two deposits of 2 μL each) of 6‐OHDA (10 mM solution in 0.9% NaCl/0.2% ascorbic acid; Sigma‐Aldrich, Madrid, Spain), defined as a dose that does not induce motor impairment in nondiabetic mice, corresponding to half the dose required to induce overt neurodegeneration of nigrostriatal axons, 34 was injected unilaterally under 2% isoflurane anesthesia into the dorsal striatum using a Hamilton syringe. Stereotaxic coordinates were: AP = 0.65, L = 2.0, DV 1 = –4 and DV 2 = –3.5. | https://pubmed.ncbi.nlm.nih.gov/32666590/ | https://www.ncbi.nlm.nih.gov/pmc/?term=32666590
32767546 |  | central and lateral parts of the dorsal striatum | Caudoputamen |  |  |  |  |  |  |  | none |  | n |  | ML_not_found | As shown in Figures 1A and 5A , tetrode positioning and AAV microinjection site were restricted to the central and lateral parts of the dorsal striatum. (A) Adeno‐associated virus (AAV) microinjection site verified by mCherry signal. Distribution of mCherry signal (indicated by orange color) shows that AAV was spread throughout the central and lateral parts of the dorsal striatum. AP indicates anteroposterior in millimeter. | https://pubmed.ncbi.nlm.nih.gov/32767546/ | https://www.ncbi.nlm.nih.gov/pmc/?term=32767546
18573207 |  | central nucleus of the amygdala | Central amygdalar nucleus | -1.4 | 0.0 | 4.2 | skull | -1.4 | 3.3 | 4.2 | llm |  | n | ML->0 (midline) |  | Mice were deeply anesthetized with a combination anesthetic (2.5 ml/kg body weight) consisting of Ketamine (37.5 mg/ml), Xylazine (1.9 mg/ml), and Acepromazine (0.37 mg/ml) and were chronically implanted with an 8 mm 26-G stainless steel guide cannula aimed at the central nucleus of the amygdala (stereotaxic coordinates used: 1.4 mm posterior from bregma, 3.3 mm lateral to midline, 4.2 mm ventral from skull surface). | https://pubmed.ncbi.nlm.nih.gov/18573207/ | https://www.ncbi.nlm.nih.gov/pmc/?term=18573207
20554871 |  | CeA | Central amygdalar nucleus | 1.25 | 2.7 | 4.7 | skull | 1.25 | 0.0 | 4.7 | high | 2.7 | n | ML from +/- (high): 2.7 |  | A small hole was drilled over the right and left CeA (coordinates: 1.25mm anterior to Bregma; ± 2.7mm lateral to midline; 4.7mm ventral to skull). 4×105 infectious viral particles were injected over 5 min and needle was left in place for 5 min after injection. | https://pubmed.ncbi.nlm.nih.gov/20554871/ | https://www.ncbi.nlm.nih.gov/pmc/?term=20554871
20832453 |  | CeA | Central amygdalar nucleus |  |  |  |  |  |  |  | none |  | n |  | ML_not_found |  | https://pubmed.ncbi.nlm.nih.gov/20832453/ | https://www.ncbi.nlm.nih.gov/pmc/?term=20832453
23055491 |  | right central nucleus of the amygdala (CeA) | Central amygdalar nucleus |  |  |  |  |  |  |  | none |  | n |  | ML_not_found | Mice are cannulated in the right central nucleus of the amygdala (CeA) and drug is delivered via the cannula. | https://pubmed.ncbi.nlm.nih.gov/23055491/ | https://www.ncbi.nlm.nih.gov/pmc/?term=23055491
23294837 |  | central amygdala | Central amygdalar nucleus | 1.25 | 2.95 | -4.75 | bregma | -1.25 | 0.0 | -4.75 | high | 2.95 | n | ML from +/- (high): 2.95 | AP->pos(rostral/anterior) |  | For every experiment, animals were bilaterally injected with 0.5 μl of the appropriate solution (sterile saline, AONs at a concentration of 400 pmol/μl in sterile saline (Eurogentec, Liège, Belgium)) in the central amygdala (coordinates relative to bregma: -1.25 mm anterior-posterior, ±2.95 mm medio-lateral and -4.75 mm dorso-ventral) [ 50 ]. The Hamilton syringe was connected to an injection pump (Harvard apparatus, Holliston, MA, USA) which controlled the injection rate set at 0.15 μl/min. | https://pubmed.ncbi.nlm.nih.gov/23294837/ | https://www.ncbi.nlm.nih.gov/pmc/?term=23294837
27849613 |  | central amygdala (CeA) | Central amygdalar nucleus |  |  |  |  |  |  |  | none |  | n |  | ML_not_found | The CeA was subsequently targeted with bilateral infusions of the MOR antagonist naloxonazine, which significantly reduced sodium appetite in mice. | https://pubmed.ncbi.nlm.nih.gov/27849613/ | https://www.ncbi.nlm.nih.gov/pmc/?term=27849613
28225716 |  | left or right CeA | Central amygdalar nucleus | -1.45 | 3.0 | -4.2 | skull | -1.45 | 0.0 | -4.2 | high | 3 | n | ML from +/- (high): 3 |  | An 8.0-mm (0.2 mm diameter) stainless steel guide cannula was implanted directly above the left or right CeA (bregma: −1.45 mm, midline: ±3.0 mm, skull: −4.2 mm) and affixed to the skull using 2 bone screws and dental cement. | https://pubmed.ncbi.nlm.nih.gov/28225716/ | https://www.ncbi.nlm.nih.gov/pmc/?term=28225716
29216351 |  | central amygdala (CeA) | Central amygdalar nucleus |  |  |  |  |  |  |  | none |  | n |  | ML_not_found | The 3-day cocaine-CPP training was performed 2 weeks after cannula implantation in CeA of C57 mice. The protein synthesis inhibitor was infused in the CeA after cocaine reexposure (A–D). After cocaine-CPP training, β-blocker was infused in the CeA after cocaine retrieval (E–G). Protein synthesis inhibitor or β-adrenergic receptor (β-AR) antagonist was systemically administrated or intra-central amygdala infused immediately after cocaine reexposure in cocaine-conditioned place preference or self-administration mice models. | https://pubmed.ncbi.nlm.nih.gov/29216351/ | https://www.ncbi.nlm.nih.gov/pmc/?term=29216351
30170157 |  | CeA | Central amygdalar nucleus |  |  |  |  |  |  |  | none |  | n |  | ML_not_found | CRH-cre transgenic mice were bilaterally injected into the CeA with cre activated pAAV-hSyn-DIO-rM3D(Gs)-mCherry and the mice were tested for anxiety-like behavior after three weeks of recuperation. Next, we used a combination of retrograde cre virus injected into locus ceruleus (LC) and cre-dependent AAV-DREADD injected into the CeA. | https://pubmed.ncbi.nlm.nih.gov/30170157/ | https://www.ncbi.nlm.nih.gov/pmc/?term=30170157
30348762 |  | CeA | Central amygdalar nucleus |  |  |  |  |  |  |  | none |  | n |  | ML_not_found | in the CeA shown in a brain section stained with 4′,6-diamidino-2-phenylindole (DAPI) (blue) and EGFP fluorescence (green) in the CeA of a mouse injected with Lenti-shD2R ( Bottom Right , n = 9). RT-PCR analysis of Drd2 mRNA in the CeA and dorsal striatum ( n = 6) of WT mice injected in the CeA with lenti-shD2R ( n = 7) or a control virus (Mock, n = 6) as well as densitometric quantification of the relative amount of the D2R amplicon. Immunohistochemical analysis of D2R in the brain of a WT mouse ( Left ) or of Drd2 −/− mice injected with AAV-GFP ( n = 8) or AAV-D2R ( n = 8) into the CeA ( Middle and… A ) ChR2-EYFP fluorescence (green) in the CeA, BNST, and VTA of D2R-Cre mice ( n = 29) injected with AAV-DIO-ChR2-EYFP into the CeA. However, the central neural pathways through which the dopamine system controls impulsive behavior are still unclear. We found that the absence of the D2 dopamine receptor (D2R) increased impulsive behavior in mice, whereas restoration of D2R expression specifically in the central amygdala (CeA) of D2R knockout mice ( Drd2 -/- ) normalized their enhanced impulsivity. | https://pubmed.ncbi.nlm.nih.gov/30348762/ | https://www.ncbi.nlm.nih.gov/pmc/?term=30348762
32424286 |  | central amygdala (CeA) | Central amygdalar nucleus | -1.08 |  |  | bregma | -1.08 |  |  | none |  | n |  | ML_not_found | c , Three consecutive representative images of post hoc histology showing optic fiber tract into the CeA from bregma −1.00 mm to −1.16 mm. Optic fiber diameter is 200 µm. | https://pubmed.ncbi.nlm.nih.gov/32424286/ | https://www.ncbi.nlm.nih.gov/pmc/?term=32424286
32653556 |  | central amygdala (CeA) | Central amygdalar nucleus |  |  |  |  |  |  |  | none |  | n |  | ML_not_found |  | https://pubmed.ncbi.nlm.nih.gov/32653556/ | https://www.ncbi.nlm.nih.gov/pmc/?term=32653556
27820843 |  | cerebellar vermis (lobules IV-V) | Cerebellar cortex, vermis lobules IV-V |  |  |  |  |  |  |  | none |  | n |  | ML_not_found | To this end, we injected NBQX (2,3-dioxo-6-nitro-1,2,3,4-tetrahydrobenzo[f]quinoxaline-7-sulfonamide) into the cerebellar vermis on Day 3 of the CS-US phase in wild-type and ho15J mice. Under anesthesia (1.5% isoflurane), 5 μl NBQX sodium solution (100 μM) containing 0.5% pontamine sky blue were injected into the subarachnoid space of the cerebellar vermis (lobules IV-V) at a rate of 1 μl/min using a 33-gauge micro-syringe needle. | https://pubmed.ncbi.nlm.nih.gov/27820843/ | https://www.ncbi.nlm.nih.gov/pmc/?term=27820843
22829396 |  | right hemisphere | Cerebellar hemisphere |  |  |  |  |  |  |  | none |  | n |  | ML_not_found | The injections were made into the cerebellar vermis and/or right hemisphere at a volume of 200-300 nl for each injection, by using a stereotaxic instrument (David Kopf Instruments, Tujunga, CA). | https://pubmed.ncbi.nlm.nih.gov/22829396/ | https://www.ncbi.nlm.nih.gov/pmc/?term=22829396
22829396 |  | cerebellar vermis | Cerebellar vermis |  |  |  |  |  |  |  | none |  | n |  | ML_not_found | The injections were made into the cerebellar vermis and/or right hemisphere at a volume of 200-300 nl for each injection, by using a stereotaxic instrument (David Kopf Instruments, Tujunga, CA). | https://pubmed.ncbi.nlm.nih.gov/22829396/ | https://www.ncbi.nlm.nih.gov/pmc/?term=22829396
27291422 |  | cerebellar vermis | Cerebellar vermis | -5.0 |  | 1.8 | pial | -5.0 |  | 1.8 | none |  | n |  | ML_not_found | For injection into the cerebellum, the skin covering the occipital bone was cut, and a burr hole was made 5 mm caudal from the bregma. The tip of a Hamilton syringe (33 gauge) with an attached micropump (UltraMicroPump II; World Precision Instrument (WPI) Sarasota, FL, USA) was inserted 1.8 mm below the pia mater of the cerebellar vermis. Ten microliters of viral solution (titre; 5.0 × 10 12 vector genomes (vg)/ml) was injected at a rate of 400 nl/min using a microprocessor-based controller (Micro4; Two micrograms of LPS extracted from Escherichia coli O111:B4 and purified via gel filtration chromatography (L3012; Sigma-Aldrich, St. Louis, MO, USA) was dissolved in 10 μl of PBS containing AAV9 vectors (final LPS concentration; 0.2 μg/μl, AAV9 titre; 5.0 × 10 12 vg/ml). | https://pubmed.ncbi.nlm.nih.gov/27291422/ | https://www.ncbi.nlm.nih.gov/pmc/?term=27291422
27465358 |  | vermis | Cerebellar vermis | 6.5 | 0.0 | -1.1 | dura | -6.5 | 0.0 | -1.1 | low |  | n | ML from label (low): 0 | AP->pos(rostral/anterior) |  | Wild-type mice were anesthetized by administration of ketamine (75 mg/kg, i.p.) and xylazine (10 mg/kg, i.p.) and injected stereotactically into the vermis with LVs encoding the green fluorescent protein (GFP) ( n = 3), human truncated wild-type ataxin-7 (WT ATXN7; ATXN7-10Q) ( n = 9) or human truncated mutant ataxin-7 (MUT ATXN7; ATXN7-100Q) ( n = 11). The viral suspensions (3×10 6 TU/ml) were injected at 0,25 μl/min using an automatic injector (Stoelting Co., Wood Dale, USA). Three μl of LV suspension were injected at the following coordinates:−6.5 mm rostral to bregma , 0 mm lateral to midline , and−1.1 mm ventral from the dura mater , with the mouth bar s… | https://pubmed.ncbi.nlm.nih.gov/27465358/ | https://www.ncbi.nlm.nih.gov/pmc/?term=27465358
27571575 |  | cerebellar vermis | Cerebellar vermis | -2.0 | 0.0 | 1.8 | pial | -2.0 | 0.0 | 1.8 | none |  | n |  | ML_not_found | For injection into the cerebellum, the skin covering the occipital bone was cut, and a burr hole was made 2 mm caudal from the lambda. The tip of a Hamilton syringe (33 gauge) with an attached micropump (UltraMicroPump II; World Precision Instrument (WPI) Sarasota, FL, USA) was inserted 1.8 mm below the pia mater of the cerebellar vermis. The viral solution (10 μl) was injected at a rate 450 nl/min using a microprocessor-based controller (Micro4; Scale bars, 500 μm. (G) Quantitative analysis of GFP fluorescence intensity. The fluorescence intensity on sagittal sections of the viral vector-treated cerebellar vermis was measured using ImageJ software. | https://pubmed.ncbi.nlm.nih.gov/27571575/ | https://www.ncbi.nlm.nih.gov/pmc/?term=27571575
28658323 |  | vermi | Cerebellar vermis |  |  |  |  |  |  |  | none |  | n |  | ML_not_found | To gain better insight into the developmental regulation of c-kit in the cerebellum, we injected AAV-containing Cre-dependent GFP into the vermi of c-kit IRES-Cre pups shortly after birth (PND 0) and, after allowing time for expression, imaged tissue prepared from perfused animals. In contrast, when we injected Cre-reporter AAV into the cerebella of mature mice (PND >30), we observed robust transduction of MLIs but Cre-dependent GFP expression in PCs was clearly absent ( Fig 1C ). | https://pubmed.ncbi.nlm.nih.gov/28658323/ | https://www.ncbi.nlm.nih.gov/pmc/?term=28658323
29056747 |  | cerebellum vermis | Cerebellar vermis | -6.0 | 0.0 |  | bregma | -6.0 | 0.0 |  | none |  | n |  | ML_not_found | About 1 μl of purified and concentrated AAV (∼10 12 infections units per ml) was injected stereotactically into the cerebellum vermis of mice at two sites (coordinates from bregma: 6.0 mm posterior, 0.0 | https://pubmed.ncbi.nlm.nih.gov/29056747/ | https://www.ncbi.nlm.nih.gov/pmc/?term=29056747
18665160 |  | right anterior cortex and hippocampus | Cerebral cortex; Hippocampal formation |  |  |  |  |  |  |  | none |  | n |  | ML_not_found | rAAV was injected unilaterally into the right anterior cortex and hippocampus of six month old mice while the left untreated hemisphere. | https://pubmed.ncbi.nlm.nih.gov/18665160/ | https://www.ncbi.nlm.nih.gov/pmc/?term=18665160
19439360 |  | sub-cortical white matter below the frontal cortex | Corpus callosum |  |  |  |  |  |  |  | none |  | n |  | ML_not_found | To model this disease process in mice, focal microinjections of the vasoconstrictor ET-1 was placed into sub-cortical white matter below the frontal cortex. Three injections of 120 nL ET-1 at 1 μg/μL were made, spaced 300–400 μm apart in the A/P plane so as to extend the stroke core within the subcortical white matter in the mouse. | https://pubmed.ncbi.nlm.nih.gov/19439360/ | https://www.ncbi.nlm.nih.gov/pmc/?term=19439360
28066196 |  | CxA | Cortex-amygdala transition zone |  |  |  |  |  |  |  | none |  | n |  | ML_not_found | To study the afferent and efferent projections of CxA, mice received iontophoretic injections of the fluorescent retrograde tracer Fluorogold (FG) [hydroxystilbamidine bis (methanesulfonate), Sigma–Aldrich, Cat # 39286] diluted at 2% in distilled water and of the anterograde tracer biotin-… | https://pubmed.ncbi.nlm.nih.gov/28066196/ | https://www.ncbi.nlm.nih.gov/pmc/?term=28066196
11277993 |  | postero-medial cortical amygdala | Cortical amygdalar area, posterior part |  |  |  |  |  |  |  | none |  | n |  | ML_not_found | Local injections of the lipophilic tracer DiI were made into the antero-dorsal and postero-ventral divisions of the medial amygdala, and into the postero-medial cortical amygdala. | https://pubmed.ncbi.nlm.nih.gov/11277993/ | https://www.ncbi.nlm.nih.gov/pmc/?term=11277993
22661931 |  | posteromedial cortical amygdala | Cortical amygdalar area, posteromedial part | -4.4 |  |  | bregma | -4.4 |  |  | none |  | n |  | ML_not_found | Injections in the posteromedial cortical amygdala Injections of biotinylated dextran-amine in the rat posteromedial cortical amygdala gave rise to a consistent labeling (as example see case R9207, −4.4 mm from Bregma, Figure 6A ) with fibers reaching the accessory olfactory bulb where they form a dense plexus of labeled axons showing varicosities in the granule cell layer (Figure 6B ). | https://pubmed.ncbi.nlm.nih.gov/22661931/ | https://www.ncbi.nlm.nih.gov/pmc/?term=22661931
32343225 |  | lateral Crus II region of the cerebellum | Crus 2 |  |  |  |  |  |  |  | none |  | n |  | ML_not_found | ( b ) Same as in ( a ), but for PCP2-Cre::ChR2-YFP mice implanted with optical fibers over the lateral Crus II region of the cerebellum. | https://pubmed.ncbi.nlm.nih.gov/32343225/ | https://www.ncbi.nlm.nih.gov/pmc/?term=32343225
21818384 |  | Crus II | Crus II |  |  |  |  |  |  |  | none |  | n |  | ML_not_found | After a watertight chamber was created, a 1–1.5 mm craniotomy was drilled to expose the cerebellar surface corresponding to Crus II. | https://pubmed.ncbi.nlm.nih.gov/21818384/ | https://www.ncbi.nlm.nih.gov/pmc/?term=21818384
31068695 |  | ADCV | Culmen |  |  |  |  |  |  |  | none |  | n |  | ML_not_found | ( c, d ) Cannula placement in the ADCV for drug delivery (c). Top : sagittal view, bottom : coronal view. Black or red/pink crosses indicate sites of saline or muscimol injections, respectively. Muscimol conjugated with the fluorophore BODIPY TMR-X injected one day after the last day of delay tactile startle conditioning was used to identify the location of the cannula tip. A representative injection site is shown (d, n=38 mice). | https://pubmed.ncbi.nlm.nih.gov/31068695/ | https://www.ncbi.nlm.nih.gov/pmc/?term=31068695
25869188 |  | cerebellar cortex (anterior injection targeting the putative region involved in delay eyelid conditioning behavior (DEC)) | Declive (VI) | 1.6 | 2.0 | 1.7000000000000002 | lambda | -1.6 | 2.0 | 1.7000000000000002 | llm |  | n | AP->pos(rostral/anterior) |  | Craniotomies were made above the cerebellar cortex (anterior injection targeting the putative region involved in delay eyelid conditioning behavior (DEC; Heiney et al., 2014 ; Steinmetz and Freeman, 2014 ), from lambda: 1.6 mm posterior, 2.0 mm lateral, 1.6–1.8 mm ventral; n=4 mice; posterior injection, from lambda: 2.0 mm posterior, 2.3 mm lateral, 1.0 mm ventral; n=5 mice) | https://pubmed.ncbi.nlm.nih.gov/25869188/ | https://www.ncbi.nlm.nih.gov/pmc/?term=25869188
26236197 |  | cerebellar vermis | Declive (VI) | -6.0 | 0.0 | 0.4 | bregma | -6.0 | 0.6 | 0.4 | llm |  | n | ML->0 (midline) |  | A midline sagittal incision exposed the cranium over the cerebellar vermis. At the site of injection (6 mm from Bregma and 0.6 mm lateral) a 0.5 mm burr hole was drilled and a 34-gauge stainless steel beveled needle (WPI-nanofil) was slowly descended 0.4 mm through a slit cut in the meninges. After a 2 min pause, the needle was retracted 50 μm and then 1.2 μl of AAV2/1.hSynap.Flex.GCaMP3.WPRE.SV40 (University of Pennsylvania Vector Core, Philadelphia, PA, USA) were injected at a rate of 0.1 μl/min. | https://pubmed.ncbi.nlm.nih.gov/26236197/ | https://www.ncbi.nlm.nih.gov/pmc/?term=26236197
26777474 |  | central vermis (lobule VI) | Declive (VI) |  |  | 2.5 | surface of the cerebellum |  |  | 2.5 | none |  | n |  | ML_not_found | Purkinje cells were isolated from the anterior vermis (lobules I-V), central vermis (lobule VI), and posterior vermis (lobules VIII–IX) usually at a depth of up to 2.5 mm below the surface of the cerebellum ( Fig. | https://pubmed.ncbi.nlm.nih.gov/26777474/ | https://www.ncbi.nlm.nih.gov/pmc/?term=26777474
29467628 |  | cerebellar lobule VI | Declive (VI) | -7.0 |  | 0.5 | bregma | -7.0 |  | 0.5 | none |  | n | reference->bregma | ML_not_found | For AAV-CMV-hrGFP injection into the cerebellar lobule VI ( n = 5, male), a 2-mm-diameter hole was made on the occipital bone at the point 7 mm caudal from bregma with a high-speed drill. The injection site of AAV-CMV-hrGFP was the center of the lateral half of the cerebellar lobule. The tip of the glass micropipette was inserted 0.5 mm deep to the surface of the cerebellar lobule. AAV-CMV-hrGFP solution (0.2 μl) was injected bilaterally into the cerebellar lobule through the micropipette. | https://pubmed.ncbi.nlm.nih.gov/29467628/ | https://www.ncbi.nlm.nih.gov/pmc/?term=29467628
31068695 |  | lobule VI | Declive (VI) |  |  |  |  |  |  |  | none |  | n |  | ML_not_found | ( f, g ) Cannula placement in lobule VI for drug delivery (f). The percentage of conditioned responses during delay tactile startle conditioning (g, top) and unconditioned responses (g, bottom) upon muscimol-dependent neuronal inactivation in lobule VI (n=8 mice). | https://pubmed.ncbi.nlm.nih.gov/31068695/ | https://www.ncbi.nlm.nih.gov/pmc/?term=31068695
32343225 |  | lobule VII | Declive (VI) |  | 0.0 |  |  |  | 0.0 |  | none |  | n |  | ML_not_found | Fibers were positioned at the midline over lobule VII ( Figure 1—figure supplement 1 ), a region suggested to play a role in emotional processing ( Stoodley and Schmahmann, 2009 ). | https://pubmed.ncbi.nlm.nih.gov/32343225/ | https://www.ncbi.nlm.nih.gov/pmc/?term=32343225
29467628 |  | cerebellar lobule IX | Declive (VI), Folium-tuber vermis (VII), Pyramus (VIII), Uvula (IX) |  |  | 0.5 | surface |  |  | 0.5 | none |  | n |  | ML_not_found | Cerebellar lobule IX was observed under the posterior edge of the occipital bone through the atlantooccipital membrane. For AAV-CMV-hrGFP injection into the cerebellar lobule IX ( n = 6, male), a small transversal incision was made at the atlantooccipital membrane for insertion of the glass micropipette. The injection site of AAV-CMV-hrGFP was the center of the lateral half of the cerebellar lobule. The tip of the glass micropipette was inserted 0.5 mm deep to the surface of the cerebellar lobule. AAV-CMV-hrGFP solution (0.2 μl) was injected bilaterally into the cerebellar lobule through the micropipette. | https://pubmed.ncbi.nlm.nih.gov/29467628/ | https://www.ncbi.nlm.nih.gov/pmc/?term=29467628
20604988 |  | hippocampal dentate gyrus | Dentate gyrus | -2.0 | 1.6 | -2.0 | skull | -2.0 | 0.0 | -2.0 | high | 1.6 | n | ML from +/- (high): 1.6 |  | One μl of lentivirus was injected targeting both sides of the hippocampal dentate gyrus at a rate of 0.25 μl/min using a 25-gauge Hamilton syringe. Coordinates of injection site were anteroposterior −2.0, mediolateral ± 1.6 relative to the bregma, and dorsoventral −2.0 relative to the skull surface ( Paxinos and Franklin, 2001 ). | https://pubmed.ncbi.nlm.nih.gov/20604988/ | https://www.ncbi.nlm.nih.gov/pmc/?term=20604988
21411641 |  | right dentate gyrus | Dentate gyrus |  |  |  |  |  |  |  | none |  | n |  | ML_not_found | Treatment with CR2 ligand reduces the number of proliferating neuroblasts in vivo To determine whether Cr2 encodes a functional gene product in NPCs and CR2/CD35 signaling affects neurogenesis in vivo we stereotaxically injected C3d into the right dentate gy… | https://pubmed.ncbi.nlm.nih.gov/21411641/ | https://www.ncbi.nlm.nih.gov/pmc/?term=21411641
21411641 |  | dentate gyrus | Dentate gyrus |  |  |  |  |  |  |  | none |  | n |  | ML_not_found | Conversely, C3d and IFN-α, two independent ligands of human CR2/CD21, inhibit NPC proliferation in cell culture and injection of C3d into the dentate gyrus reduces the number of immature neuroblasts in vivo. | https://pubmed.ncbi.nlm.nih.gov/21411641/ | https://www.ncbi.nlm.nih.gov/pmc/?term=21411641
21772812 |  | dentate gyrus | Dentate gyrus |  |  |  |  |  |  |  | none |  | n |  | ML_not_found | To determine if a fragment of the putative Netrin G1 promoter can drive gene expression in vivo , we assembled the lentivirus NetrinG1-EYFP and injected it into the dentate gyrus. We stereotaxically injected CAMKII(0.4)-Kir2.1-mCherry into the dentate gyrus of mice aged 4–6 weeks (Figure 3 B). Virus was injected into the dentate gyrus. | https://pubmed.ncbi.nlm.nih.gov/21772812/ | https://www.ncbi.nlm.nih.gov/pmc/?term=21772812
23033083 |  | DG | Dentate gyrus |  |  |  |  |  |  |  | none |  | n |  | ML_not_found | In particular, lentivirus, LV-SYNP-HTG (LVV) 11 , 16 , expressing TVA, Rgp and histone-tagged GFP (hGFP), was injected into the DG ( n = 3). Ten days after lentivirus administration, EnvA-ΔG-MCh rabies virus (MCh) was injected into the DG to specifically infect the TVA-expressing ‘starter’ cells. | https://pubmed.ncbi.nlm.nih.gov/23033083/ | https://www.ncbi.nlm.nih.gov/pmc/?term=23033083
24174283 |  | dentate gyrus | Dentate gyrus |  |  |  |  |  |  |  | none |  | n |  | ML_not_found | In addition, we induced a similar loss of new hippocampal neurons by knocking down expression of GRF1 solely in new neurons by injecting retrovirus that express shRNA against GRF1 into the dentate gyrus. | https://pubmed.ncbi.nlm.nih.gov/24174283/ | https://www.ncbi.nlm.nih.gov/pmc/?term=24174283
25101829 |  | dentate gyrus of the hippocampus | Dentate gyrus | -2.1 | 0.0 | 1.2 | skull | -2.1 | 1.8 | 1.2 | llm |  | n | ML->0 (midline) |  | The viral particles from IRES-EGFP or neuritin were bilaterally injected into the dentate gyrus of the hippocampus of 13-month-old wt and Tg2576 mice 2.1 mm posterior to the bregma (AP), 1.8 mm lateral to the midline (ML) and 1.2 mm ventral to the surface of the skull (DV) or unilaterally injected into the dentate gyrus of the hippocampus of 7-week-old SD rats 3.5 mm posterior to the bregma (AP), 2.0 mm lateral to the midline (ML) and 4.0 mm ventral to the surface of the skull (DV), according to the Brain Atlas. | https://pubmed.ncbi.nlm.nih.gov/25101829/ | https://www.ncbi.nlm.nih.gov/pmc/?term=25101829
25101829 |  | dentate gyrus of the hippocampus | Dentate gyrus | -3.5 | 0.0 | 4.0 | skull | -3.5 | 2.0 | 4.0 | llm |  | n | ML->0 (midline) |  | The viral particles from IRES-EGFP or neuritin were bilaterally injected into the dentate gyrus of the hippocampus of 13-month-old wt and Tg2576 mice 2.1 mm posterior to the bregma (AP), 1.8 mm lateral to the midline (ML) and 1.2 mm ventral to the surface of the skull (DV) or unilaterally injected into the dentate gyrus of the hippocampus of 7-week-old SD rats 3.5 mm posterior to the bregma (AP), 2.0 mm lateral to the midline (ML) and 4.0 mm ventral to the surface of the skull (DV), according to the Brain Atlas. | https://pubmed.ncbi.nlm.nih.gov/25101829/ | https://www.ncbi.nlm.nih.gov/pmc/?term=25101829
25162525 |  | dorsal dentate gyrus (DG) of the hippocampus | Dentate gyrus |  |  |  |  |  |  |  | none |  | n |  | ML_not_found | Once the target site was reached, the needle was held in place for 5 minutes prior to the injection of 200 nl of virus at a rate of 70 nl/min. Here we investigated these mechanisms by applying the recently developed memory engram cell- manipulation technique. We labelled with channelrhodopsin-2 (ChR2) a population of cells in either the dorsal dentate gyrus (DG) of the hippocampus or the basolateral complex of the amygdala (BLA) that were specifically activated during contextual fear or reward conditioning. | https://pubmed.ncbi.nlm.nih.gov/25162525/ | https://www.ncbi.nlm.nih.gov/pmc/?term=25162525
26115702 |  | hippocampal dentate gyrus | Dentate gyrus | 2.0 | 1.6 | 2.0 | bregma | -2.0 | 0.0 | 2.0 | high | 1.6 | n | ML from +/- (high): 1.6 | AP->pos(rostral/anterior) |  | Stereotactic bilateral injections of AAV8 containing EGFP-2A-SNX15-3Flag or EGFP (1.5 µl, titer 2×10 12 ) into hippocampal dentate gyrus of APPswe/PSEN1dE9 mice were carried out at the following coordinates: −2.0 anterior/posterior, ±1.6 medial/lateral, and 2 dorsal ventral relative to bregma (in millimeters)[ 44 ]. | https://pubmed.ncbi.nlm.nih.gov/26115702/ | https://www.ncbi.nlm.nih.gov/pmc/?term=26115702
26124746 |  | dentate gyrus | Dentate gyrus |  |  |  | bregma |  |  |  | none |  | n |  | ML_not_found | Coordinates for injections of IgG preparations in different parts of the hippocampal formation in mice (from bregma in mm) . Hippocampal stainings after stereotactic injections of trypan blue or anti-GAD65 aAB containing IgG preparations . (A) Injection of 1 μl trypan blue in the dentate gyrus of each hemisphere shows uniform distribution exclusively in the hippocampal compartment… | https://pubmed.ncbi.nlm.nih.gov/26124746/ | https://www.ncbi.nlm.nih.gov/pmc/?term=26124746
26589333 |  | right dorsal dentate gyrus (DG) | Dentate gyrus | 2.1 | 1.9 | -2.1 | bregma | -2.1 | 1.9 | -2.1 | llm |  | n | AP->pos(rostral/anterior) |  | Stereotaxic surgery After three days of housing in their respective conditions, mice were anesthetized (Avertin 0.4 mg g −1 i.p.) and stereotaxic surgery was performed to deliver 1 μl of retrovirus RV-SYN-GTRgp or CAG-GFP into the right dorsal and ventral dentate gyrus (DG) using spatial coordinates relative to Bregma as follows: Dorsal DG, anterior–posterior (AP) = −2.10 mm; medial–lateral (ML) = 1.9 mm; dorso-ventral (DV) = −2.10 mm, and ventral DG, AP = −3.10 mm; | https://pubmed.ncbi.nlm.nih.gov/26589333/ | https://www.ncbi.nlm.nih.gov/pmc/?term=26589333
26589333 |  | right ventral dentate gyrus (DG) | Dentate gyrus | 3.1 |  |  | bregma | -3.1 |  |  | none |  | n | AP->pos(rostral/anterior) | ML_not_found | Stereotaxic surgery After three days of housing in their respective conditions, mice were anesthetized (Avertin 0.4 mg g −1 i.p.) and stereotaxic surgery was performed to deliver 1 μl of retrovirus RV-SYN-GTRgp or CAG-GFP into the right dorsal and ventral dentate gyrus (DG) using spatial coordinates relative to Bregma as follows: Dorsal DG, anterior–posterior (AP) = −2.10 mm; medial–lateral (ML) = 1.9 mm; dorso-ventral (DV) = −2.10 mm, and ventral DG, AP = −3.10 mm; | https://pubmed.ncbi.nlm.nih.gov/26589333/ | https://www.ncbi.nlm.nih.gov/pmc/?term=26589333
26888068 |  | immediately above the DG | Dentate gyrus |  |  | 0.3 | synaptic zone of medial perforant path fibers |  |  | 0.3 | none |  | n |  | ML_not_found | In the present study, BDNF was infused immediately above the DG, 300μm dorsal to the synaptic zone of medial perforant path fibers. | https://pubmed.ncbi.nlm.nih.gov/26888068/ | https://www.ncbi.nlm.nih.gov/pmc/?term=26888068
26888068 |  | rat dentate gyrus | Dentate gyrus |  |  |  |  |  |  |  | none |  | n |  | ML_not_found | Here, we examined the effects associated with brief (25 min), unilateral infusion of BDNF in the rat dentate gyrus. | https://pubmed.ncbi.nlm.nih.gov/26888068/ | https://www.ncbi.nlm.nih.gov/pmc/?term=26888068
27300262 |  | dentate gyrus (DG) of the hippocampus | Dentate gyrus | 2.3 | 0.0 | 2.3 | dura | -2.3 | 1.35 | 2.3 | llm |  | n | AP->pos(rostral/anterior) | ML->0 (midline) |  | LVs or drugs such as 7-nitroindazole (7-NI, 10 μ m , Sigma-Aldrich) or 8-hydroxy-2-dipropylaminotetralin hydrobromide (8-OH-DPAT, 5 μ m , Sigma-Aldrich) were stereotactically delivered into both sides of the dentate gyrus (DG) of the hippocampus (2 μl; coordinates: 2.3 mm posterior to the bregma, 1.35 mm lateral to the midline and 2.3 mm below the dura) 15 or the mPFC region (2 μl; coordinates: 1.8 mm anterior to the bregma, 0.8 mm lateral to the midline and 1 mm below the dura). | https://pubmed.ncbi.nlm.nih.gov/27300262/ | https://www.ncbi.nlm.nih.gov/pmc/?term=27300262
27698430 |  | bilateral DG | Dentate gyrus |  |  |  |  |  |  |  | none |  | n |  | ML_not_found | 2µl of lentivirus were injected at a rate of 0.5µl per minute into the bilateral DG. Lentiviral infection was confirmed by immunohistochemistry, and mice lacking successful virus infection in the bilateral DG were excluded from analysis. | https://pubmed.ncbi.nlm.nih.gov/27698430/ | https://www.ncbi.nlm.nih.gov/pmc/?term=27698430
28203202 |  | dentate gyrus (DG) of the mouse hippocampus | Dentate gyrus | 2.0 | 1.6 | -2.1 | bregma | -2.0 | 0.0 | -2.1 | high | 1.6 | n | ML from +/- (high): 1.6 | AP->pos(rostral/anterior) |  | The DiI-exosome solution (3 μl at 1 μg protein/μl) and the control (3 μl) was stereotactically injected into the dentate gyrus (DG) of the mouse hippocampus using a stereotactic apparatus (KOPF), at the following coordinates (relative to Bregma): anterior posterior: −2.0, medial lateral: ± 1.6, dorsal ventral: −2.1. | https://pubmed.ncbi.nlm.nih.gov/28203202/ | https://www.ncbi.nlm.nih.gov/pmc/?term=28203202
28451637 |  | DG | Dentate gyrus |  |  |  |  |  |  |  | none |  | n |  | ML_not_found | The WGA-Cre AAV was unilaterally injected into one DG (1) in the wild-type C57BL/6 mouse to express Cre in some mossy cells in the contralateral DG, while the Cre-dependent helper AAV for rabies tracing was injected into the contralateral DG of the same mouse (2). At three weeks following the AAV injection, the genetically modified rabies was injected (3) for monosynaptic tracing of direct inputs to the targeted mossy cells. B , Spatially restricted iontophoretic injection of the helper AAV (AAV-DIO-HTB) in the temporal DG of the D1-Cre mouse (left), followed by EnvA-SADΔG-mCherry rabies infection (right). | https://pubmed.ncbi.nlm.nih.gov/28451637/ | https://www.ncbi.nlm.nih.gov/pmc/?term=28451637
28810892 |  | dentate gyrus (DG) of the hippocampus | Dentate gyrus | -2.0 | 1.4 | -2.2 | bregma | -2.0 | 0.0 | -2.2 | high | 1.4 | n | ML from +/- (high): 1.4 |  | Coordinates (mm) relative to the Bregma in the anteroposterior, mediolateral, and dorsoventral planes were as follows: dentate gyrus (DG) of the hippocampus [− 2.0; ±1.4; −2.2]. Next, 2 μl/DG of Tau-Cy5 (1 mg/ml) or PBS-Cy5 solution was infused at 0.2 μl/min via a glass micropipette. | https://pubmed.ncbi.nlm.nih.gov/28810892/ | https://www.ncbi.nlm.nih.gov/pmc/?term=28810892
28883658 |  | dorsal and ventral dentate gyrus | Dentate gyrus |  |  |  |  |  |  |  | none |  | n |  | ML_not_found | Mice housed with ( n = 8) or without a running wheel ( n = 8) were injected with RV-SYN-GTRgp into the dorsal and ventral dentate gyrus to label proliferating neural progenitor cells (Fig. Three days later, mice received EnvA-ΔG-MCh rabies virus into the same dentate gyrus areas. | https://pubmed.ncbi.nlm.nih.gov/28883658/ | https://www.ncbi.nlm.nih.gov/pmc/?term=28883658
28883658 |  | dentate gyrus | Dentate gyrus |  |  |  |  |  |  |  | none |  | n |  | ML_not_found | As a control for possible non-specific rabies virus labeling, retrovirus missing Rgp (RV-SYN-HT), which is necessary for rabies virus complementation and virus spread to presynaptic neurons 25 , was injected into the dentate gyrus and was followed by EnvA-ΔG-MCh rabies virus three days thereafter ( n = 3). | https://pubmed.ncbi.nlm.nih.gov/28883658/ | https://www.ncbi.nlm.nih.gov/pmc/?term=28883658
29217824 |  | hippocampal dentate gyrus (DG) | Dentate gyrus |  |  |  |  |  |  |  | none |  | n |  | ML_not_found | Animals received a stereotaxic injection of either Tau-Cy5 (13) or PBS-Cy5 (13) in the hippocampal dentate gyrus (DG). | https://pubmed.ncbi.nlm.nih.gov/29217824/ | https://www.ncbi.nlm.nih.gov/pmc/?term=29217824
29217824 |  | dentate gyrus | Dentate gyrus |  |  |  |  |  |  |  | none |  | n |  | ML_not_found | Of these animals, eight (four Tau-Cy5 and four PBS-Cy5) also received an injection of an RFP-expressing retrovirus in order to label newborn granule neurons (group A). | https://pubmed.ncbi.nlm.nih.gov/29217824/ | https://www.ncbi.nlm.nih.gov/pmc/?term=29217824
29488134 |  | dentate gyrus of the hippocampus | Dentate gyrus | -2.0 |  | -1.9 | bregma | -2.0 |  | -1.9 | none |  | n | reference->bregma | ML_not_found | When the mice were 11.5 months old, the DiI or Fluoro-Gold were stereotaxically injected at 1 μL/min for 3 min into the dentate gyrus of the hippocampus (AP, − 2.0 mm; DV, − 1.9 mm from bregma and skull) in the 5XFAD ( n = 5) and wild-type mice ( n = 5), while they were anesthetized with Avertin (tribromoethanol; Sigma-Aldrich Corporation, St. 250 μg/kg), which was administered by intraperitoneal injections. | https://pubmed.ncbi.nlm.nih.gov/29488134/ | https://www.ncbi.nlm.nih.gov/pmc/?term=29488134
30079373 |  | dentate gyrus | Dentate gyrus |  |  |  |  |  |  |  | none |  | n |  | ML_not_found | To highlight the potential physical interaction between ApoE-expressing astrocytes and adult-born granule cells in the dentate gyrus, one 6-week-old tdTomato reporter mouse ( Table 1 ) was injected with an eGFPcre-expressing retrovirus [1 × 10 9 transducing units (TU)/ml] into the dentate gyrus [Moloney Murine Leukemia Viral vectors were generated by the GT3 Core Facility of the Salk Institute (La Jolla, CA) with funding by National Institutes of Health (NIH)… To determine the expression of ApoE in approximation to the dendritic arborizations of adult-born neurons, a retrovirus expressing Cre was injected stereotactically into the dentate gyrus subgranular zone of ROSA-26 tdTomato reporter mice to infect dividing NSPCs, which then express tdTomato. To investigate the effects of ApoE and its human isoforms on adult hippocampal neurogenesis and neuronal development, retroviruses carrying a GFP-expressing vector were injected into wild-type (WT), ApoE-deficient, and human targeted replacement (ApoE3 and ApoE4) mice to infect progenitors in the dentate gyrus and analyze the morphology of fully developed GFP-expressing neurons. | https://pubmed.ncbi.nlm.nih.gov/30079373/ | https://www.ncbi.nlm.nih.gov/pmc/?term=30079373
30948824 |  | dorsal dentate gyrus of the hippocampus | Dentate gyrus |  |  |  |  |  |  |  | none |  | n |  | ML_not_found | Craniotomy was performed according to approved procedures, and 2 μl of CRISPR–Gold (50 pmole of Cas9 and 50 pmoles of guide RNAs, or 50 pmole of Cpf1 and 50 pmole of crRNAs) with 5 μg of PAsp(DET) for Thy1-YFP or Ai9 mice was injected into a single hemisphere of the striatum and/or the dorsal dentate gyrus of the hippocampus. | https://pubmed.ncbi.nlm.nih.gov/30948824/ | https://www.ncbi.nlm.nih.gov/pmc/?term=30948824
30984001 |  | dorsal dentate gyrus | Dentate gyrus | -1.9 | 0.0 | 1.0 | skull | -1.9 | 1.0 | 1.0 | llm |  | n | ML->0 (midline) |  | Mice were anesthetized with isoflurane (induction 5%, 2% maintenance; Vetflurane, Virbac, Carros, France), and implanted with bilateral 26-gauge stainless steel guide cannulae (Plastics One, Roanoke, VA, United States) into the dorsal dentate gyrus using a stereotactic device (David Kopf Instruments, Tujunga, CA, United States). The coordinates used were 1.9 mm posterior to bregma, 1.0 mm lateral to midline, and 1.0 mm ventral to skull level. | https://pubmed.ncbi.nlm.nih.gov/30984001/ | https://www.ncbi.nlm.nih.gov/pmc/?term=30984001
31371454 |  | hippocampus | Dentate gyrus |  |  |  |  |  |  |  | none |  | n |  | ML_not_found | Two mice were excluded because fibers targeting the hippocampus were found to have terminated either within or beneath the level of the dentate gyrus. | https://pubmed.ncbi.nlm.nih.gov/31371454/ | https://www.ncbi.nlm.nih.gov/pmc/?term=31371454
31397354 |  | dentate gyrus of the hippocampus | Dentate gyrus |  |  |  |  |  |  |  | none |  | n |  | ML_not_found | AAV5-CaMK-CHR2-mCherry and AAV5-CaMK-mCherry were injected bilaterally into the dentate gyrus of the hippocampus. Then, 14 days later, 0.2 μg soluble low-molecular-weight Aβ 1–42 was injected into the same site. Afterwards, light stimulation was performed for 5 minutes with an optical fiber at the same site in the dentate gyrus. | https://pubmed.ncbi.nlm.nih.gov/31397354/ | https://www.ncbi.nlm.nih.gov/pmc/?term=31397354
31447652 |  | Dentate gyrus | Dentate gyrus | -2.54 | 1.7000000000000002 | 3.0 | bregma | -2.54 | 1.7000000000000002 | 3.0 | llm | 1.5 | n |  | ML_mismatch(llm=1.7;quote=1.5) | Table 1 Injection site coordinates, number of animals and injected volumes of rAAV8-CMV-WGA-Cre and rAAV8-CMV-TTC-eGFP tracers. Structure AP* (mm) ML* (mm) DV* (mm) n Volume rAAV (μl) Hippocampus Dentate gyrus −2.54 ± 1.5 1.8–1.6 3 1. | https://pubmed.ncbi.nlm.nih.gov/31447652/ | https://www.ncbi.nlm.nih.gov/pmc/?term=31447652
31507383 |  | DG | Dentate gyrus |  |  |  |  |  |  |  | none |  | n |  | ML_not_found | we used mice expressing Cre-recombinase under the control of the GAD2 promoter (GAD2-cre mice; see section Materials and Methods for details of mouse lines used) and stereotaxically injected an AAV expressing GFP in a cre-recombinase-dependent manner unilaterally into the DG ( Figure 1A and Supplementary Table 1 ). | https://pubmed.ncbi.nlm.nih.gov/31507383/ | https://www.ncbi.nlm.nih.gov/pmc/?term=31507383
31856920 |  | dentate gyrus (DG) | Dentate gyrus |  |  |  |  |  |  |  | none |  | n |  | ML_not_found | Organotypic mouse hippocampal slice cultures as a model to study seeded α-syn aggregation in the region between DG and CA3. a Diagram showing the synaptic connections of granule cells of DG (where S129A PFFs were injected) to pyramidal neurons in CA3 that subsequently connect to the pyramidal neurons of the CA1 region. Here we describe the use of an organotypic hippocampal slice model for studying α-synuclein aggregation and inter-neuronal spreading initiated by microinjection of pre-formed α-synuclein fibrils (PFFs). PFF injection at dentate gyrus (DG) templates the formation of endogenous α-synuclein aggregates in axons and cell bodies of this region that spread to CA3 and CA1 regions. | https://pubmed.ncbi.nlm.nih.gov/31856920/ | https://www.ncbi.nlm.nih.gov/pmc/?term=31856920
32119690 |  | dentate gyrus | Dentate gyrus |  |  |  |  |  |  |  | none |  | n |  | ML_not_found | Mixed genotype and sex mice underwent moderate CCI at 6 weeks of age immediately followed by stereotactic brain injections of a GFP-expressing retrovirus. ( A ) Representative section of the contralateral and ipsilateral cortex and hippocampus 4 weeks after Controlled Cortical Impact and stereotaxic injection of GFP-expressing retroviruses in the dentate gyrus of a wildtype mouse reveals the typical morphology of the injured hippocampus along with efficient long-term labelling of neural progenitor cells. Here, we investigate how controlled cortical impact (CCI) injury affects dentate gyrus development using hippocampal stereotactic injections of GFP-expressing retroviruses in wild-type (WT), ApoE-deficient and humanized (ApoE3 and ApoE4) mice. | https://pubmed.ncbi.nlm.nih.gov/32119690/ | https://www.ncbi.nlm.nih.gov/pmc/?term=32119690
27030321 |  | hilus | Dentate gyrus hilus |  |  |  |  |  |  |  | none |  | n |  | ML_not_found | Vector was injected into the hilus at 100 nL/min for 10 min with a 33 gauge needle and microsyringe pump controller (World Precision Instruments). | https://pubmed.ncbi.nlm.nih.gov/27030321/ | https://www.ncbi.nlm.nih.gov/pmc/?term=27030321
31403615 |  | unilateral dentate gyrus containing mossy cells; mossy cells in the hilus of the DG | Dentate gyrus hilus | 2.0 | 1.5 | -2.3 | bregma | -2.0 | -1.5 | -2.3 | llm |  | n | AP->pos(rostral/anterior) |  | This example targets a unilateral dentate gyrus containing mossy cells and determines their effect on adult neural stem cells on the contralateral side. 1.11 Switch drill to 5 μL Hamilton syringe and 26 - 33 gauge needle. Zero at bregma and then inject at the following coordinates by placing the needle in the drill hole at anterior posterior axis −2.00 mm, medial lateral axis - 1.50 mm, dorsal ventral axis −2.3 mm. 1.12 Infuse 500 nl of virus to appropriate hemisphere at 50-100 nl/s using an infusion pump (see materials ) and wait at least 5 minutes post injection before slowly removing needle. For this experiment mossy cells in the hilus of the DG were the intended target, and if injections were outside of the hilus, they were excluded. | https://pubmed.ncbi.nlm.nih.gov/31403615/ | https://www.ncbi.nlm.nih.gov/pmc/?term=31403615
31507383 |  | dentate gyrus hilus region | Dentate gyrus hilus |  |  |  |  |  |  |  | none |  | n |  | ML_not_found | (B) Localized expression of AAV1-FLEX-CAG-GFP in the injected brain hemisphere after stereotaxic injection into the dentate gyrus hilus region of a GAD2-cre mouse. | https://pubmed.ncbi.nlm.nih.gov/31507383/ | https://www.ncbi.nlm.nih.gov/pmc/?term=31507383
31507383 |  | hilus only | Dentate gyrus hilus |  |  |  |  |  |  |  | none |  | n |  | ML_not_found | (A) Infection of the entire ipsilateral hippocampus in GAD2-cre mice, with widespread Ipsi- and Contralateral axonal arborization. (B–E) Localized virus injections infecting the entire hippocampus (B) , hilus and CA3 (C) , hilus only (D) or CA1 only (E) of SOM-cre mice. | https://pubmed.ncbi.nlm.nih.gov/31507383/ | https://www.ncbi.nlm.nih.gov/pmc/?term=31507383
31507383 |  | hilus and CA3 | Dentate gyrus hilus and Field CA3 |  |  |  |  |  |  |  | none |  | n |  | ML_not_found | (A) Infection of the entire ipsilateral hippocampus in GAD2-cre mice, with widespread Ipsi- and Contralateral axonal arborization. (B–E) Localized virus injections infecting the entire hippocampus (B) , hilus and CA3 (C) , hilus only (D) or CA1 only (E) of SOM-cre mice. | https://pubmed.ncbi.nlm.nih.gov/31507383/ | https://www.ncbi.nlm.nih.gov/pmc/?term=31507383
28883658 |  | molecular layer of the dentate gyrus | Dentate gyrus molecular layer |  |  |  |  |  |  |  | none |  | n |  | ML_not_found | AAV5-hSyn-hChR2-EYFP viral vector was injected into the molecular layer of the dentate gyrus to express ChR2 in hippocampal neurons. | https://pubmed.ncbi.nlm.nih.gov/28883658/ | https://www.ncbi.nlm.nih.gov/pmc/?term=28883658
25481416 |  | left dorsal cochlear nucleus (DCN) | Dorsal cochlear nucleus |  |  |  |  |  |  |  | none |  | n |  | ML_not_found | The left dorsal cochlear nucleus (DCN) was identified by brainstem surface landmarks (there was no attempt to visualize the auditory nerve as it enters the CN ventrally. | https://pubmed.ncbi.nlm.nih.gov/25481416/ | https://www.ncbi.nlm.nih.gov/pmc/?term=25481416
27560718 |  | DC | Dorsal cochlear nucleus |  |  |  | bregma |  |  |  | none |  | n |  | ML_not_found | Fluorogold (Fluorochrome, LLC, Denver, CO) was deposited either using a small piece of gelfoam soaked in tracer, or using microinjections targeted to LC, DC, or central nucleus of the inferior colliculus (CNIC). For microinjections, approximately 5-10 μL o… | https://pubmed.ncbi.nlm.nih.gov/27560718/ | https://www.ncbi.nlm.nih.gov/pmc/?term=27560718
21516258 |  | dorsal raphe nucleus | Dorsal nucleus raphe |  |  |  |  |  |  |  | none |  | n |  | ML_not_found | Figure 2 shows representative hypnograms of an animal microinjected with MCH or vehicle (control) into the DR. Figure 2 Representative hypnograms illustrating the occurrence of wakefulness and sleep following microinjection of MCH into the dorsal raphe nucleus . The blockade of physiologically released-MCH in the DR by immunoneutralization (microinjections of antibodies anti-MCH) increased wakefulness and suppressed REM sleep, while SWS tended to remain unchanged (Lagos et al., 2011a ). Microinjection of MCH into the dorsal raphe nucleus increases REM sleep time. REM seep is inhibited by immunoneutralization of MCH within this nucleus. | https://pubmed.ncbi.nlm.nih.gov/21516258/ | https://www.ncbi.nlm.nih.gov/pmc/?term=21516258
25420775 |  | dorsal raphe nucleus (DRN) | Dorsal nucleus raphe |  |  |  |  |  |  |  | none |  | n |  | ML_not_found | rAAV was injected into the DRN for expression of EGFP-synaptophysin for anterograde tracing. | https://pubmed.ncbi.nlm.nih.gov/25420775/ | https://www.ncbi.nlm.nih.gov/pmc/?term=25420775
25732261 |  | ventral DRN | Dorsal nucleus raphe |  |  |  |  |  |  |  | none |  | n |  | ML_not_found | Wildtype mice were injected with an adeno-associated virus (AAV2/1) encoding HTT containing either a pathogenic (N171-82Q) or control (N171-16Q) CAG repeat length into the ventral DRN and depressive-like behaviors and motor behaviors were assessed for 12 weeks post-surgery. Quantitative PCR and immunohistochemistry (IHC) verified positive transduction in the ventral aspects of the DRN, including the ventral sub-nucleus (DRv) and interfascicular sub-nucleus (DRif). | https://pubmed.ncbi.nlm.nih.gov/25732261/ | https://www.ncbi.nlm.nih.gov/pmc/?term=25732261
32252889 |  | dorsal raphe nucleus (DRN) | Dorsal nucleus raphe |  |  |  |  |  |  |  | none |  | n |  | ML_not_found | Here, we show that serotonergic input has separable suppressive effects on the gain of ongoing and evoked visual activity. We combined optogenetic stimulation of the dorsal raphe nucleus (DRN) with wide-field calcium imaging, extracellular recordings, and iontophoresis of serotonin (5-HT) receptor antagonists in the mouse visual cortex. 6: auditory cortex; 7: PtA (parietal association area). ( bi ) Coronal section at the DRN injection site after expression of Cre-dependent tdTomato (red). Most subnuclei including dorsal (DRD), ventral (DRV), and interfascicular (DRI) parts of the DRN, and the median raphe nucleus (MnR) show fluorescent labeling of serotonergic cells. | https://pubmed.ncbi.nlm.nih.gov/32252889/ | https://www.ncbi.nlm.nih.gov/pmc/?term=32252889
30736827 |  | dLGN | Dorsal part of the lateral geniculate complex |  |  |  |  |  |  |  | none |  | n |  | ML_not_found | ( B ) The injection site for EnvA-RV-∆G-DsRed in dLGN. | https://pubmed.ncbi.nlm.nih.gov/30736827/ | https://www.ncbi.nlm.nih.gov/pmc/?term=30736827
32265666 |  | dorsal lateral geniculate nucleus (dLGN) | Dorsal part of the lateral geniculate complex |  |  |  |  |  |  |  | none |  | n |  | ML_not_found | RbVs were stereotactically injected into a pair of brain regions that are both innervated by DRN serotonergic neurons, and included the striatum (Str), dorsal lateral geniculate nucleus (dLGN), nucleus accumbens (NAc), and substantia nigra (SN). | https://pubmed.ncbi.nlm.nih.gov/32265666/ | https://www.ncbi.nlm.nih.gov/pmc/?term=32265666
30048477 |  | anterior dorsolateral striatum (aDLS) | Dorsal part of the striatum | 3.84 |  |  | bregma | -3.84 |  |  | none |  | n | AP->pos(rostral/anterior) | ML_not_found | Bregma: -3.84 and Interaural: 4.96; Bregma: -5.04 following the atlas available at The Mouse Brain Library [ 51 ]. A continuous current (1–10 nA) was used to inject cells with the fluorescent dye Lucifer Yellow [LY; 8% in 0.1 M Tris buffer (pH 7.4)] and at least 15 anterior dorsolateral striatum (aDLS) and 15 posterior dorsomedial striatum (pDMS) medium spiny neurons per animal were impaled ( Fig 1A and 1B ). | https://pubmed.ncbi.nlm.nih.gov/30048477/ | https://www.ncbi.nlm.nih.gov/pmc/?term=30048477
30048477 |  | posterior dorsomedial striatum (pDMS) | Dorsal part of the striatum | 5.04 |  |  | bregma | -5.04 |  |  | none |  | n | AP->pos(rostral/anterior) | ML_not_found | Bregma: -3.84 and Interaural: 4.96; Bregma: -5.04 following the atlas available at The Mouse Brain Library [ 51 ]. A continuous current (1–10 nA) was used to inject cells with the fluorescent dye Lucifer Yellow [LY; 8% in 0.1 M Tris buffer (pH 7.4)] and at least 15 anterior dorsolateral striatum (aDLS) and 15 posterior dorsomedial striatum (pDMS) medium spiny neurons per animal were impaled ( Fig 1A and 1B ). | https://pubmed.ncbi.nlm.nih.gov/30048477/ | https://www.ncbi.nlm.nih.gov/pmc/?term=30048477
19274668 |  | DR | Dorsal raphe nucleus |  | 0.0 |  |  |  |  |  | none |  | n | ML->0 (midline) | ML_not_found | Figure 1 illustrates an example of a BA2001 injection that targeted the midline RVM, i.e. in the region of the NRM (upper row) and another that targeted the DR (lower row) of ePet-Cre mice. | https://pubmed.ncbi.nlm.nih.gov/19274668/ | https://www.ncbi.nlm.nih.gov/pmc/?term=19274668
25907441 |  | dorsal raphe nucleus (DRN) | Dorsal raphe nucleus |  |  |  |  |  |  |  | none |  | n |  | ML_not_found | Virus produced from this construct (pSERT-GFP) was injected into rat striatum, ventral tegmental area, and dorsal raphe nucleus and was observed to express selectively in DRN ( Sexton et al., 2006 ). Increased expression of 5-HT1B autoreceptors throughout the brain significantly decreased fear expression in both wild-type (WT) and 5-HT1B knockout (1BKO) mice when receptor levels were increased with a cell-type-specific herpes simplex virus (HSV) vector injected into the dorsal raphe nucleus (DRN). | https://pubmed.ncbi.nlm.nih.gov/25907441/ | https://www.ncbi.nlm.nih.gov/pmc/?term=25907441
28087766 |  | DRN | Dorsal raphe nucleus |  |  |  |  |  |  |  | none |  | n |  | ML_not_found | a viral vector carrying a floxed ChR2 and tagged with YFP was stereotaxically injected into the DRN of SERT-Cre mice | https://pubmed.ncbi.nlm.nih.gov/28087766/ | https://www.ncbi.nlm.nih.gov/pmc/?term=28087766
29174640 |  | DRN | Dorsal raphe nucleus | -4.66 |  |  | bregma | -4.66 |  |  | none |  | n |  | ML_not_found | GR expression extends from bregma −4.36 to −4.96 in the DRN and is negligible in the median raphé nucleus in mice [ 17 , 36 ]. | https://pubmed.ncbi.nlm.nih.gov/29174640/ | https://www.ncbi.nlm.nih.gov/pmc/?term=29174640
29867774 |  | dorsal raphe nucleus | Dorsal raphe nucleus | -4.66 |  |  | bregma | -4.66 |  |  | none |  | n |  | ML_not_found | The mediodorsal area of dorsal part of the DRN was defined as the area within a 0.2 mm diameter circle placed on right below the bottom edge of the aqueduct and ranging from Bregma −4.48 to −4.84 mm ( 15 ) (Figure 4 ). Comparison of distribution pattern of adeno-associated virus within the mediodorsal area of dorsal part of the dorsal raphe nucleus (Bregma −4.72 mm) determined by green fluorescent protein immunohistochemistry in successful ERβ knockdown (βERKD) (left) and missed βERKD (middle and right) mice. | https://pubmed.ncbi.nlm.nih.gov/29867774/ | https://www.ncbi.nlm.nih.gov/pmc/?term=29867774
29949769 |  | dorsal raphe | Dorsal raphe nucleus | -4.2 |  | -3.2 | bregma | -4.2 |  | -3.2 | none |  | n |  | ML_not_found | Adeno-associated viral (AAV) vectors were bilaterally injected into NAc (250 nLfrom bregma: AP, +1.2; DV, —4.6 mm), and dorsal raphe (500 nL: AP, —4.2; DV, —3.2 mm) using a Nanoject II (Drummond Scientific). | https://pubmed.ncbi.nlm.nih.gov/29949769/ | https://www.ncbi.nlm.nih.gov/pmc/?term=29949769
30089910 |  | DR | Dorsal raphe nucleus | -4.36 | 0.0 | -3.1 | bregma | -4.36 | 0.0 | -3.1 | none |  | n |  | ML_not_found | Thirty-three gauge syringe needles (Hamilton) were used to unilaterally infuse 0.3 μl of virus into the DR (bregma coordinates: anteroposterior, −4.36; mediolateral, 0; dorsoventral, −3.1) at a rate of 0.1 μl min −1 . | https://pubmed.ncbi.nlm.nih.gov/30089910/ | https://www.ncbi.nlm.nih.gov/pmc/?term=30089910
30677060 |  | dorsal raphe nucleus | Dorsal raphe nucleus | -4.5 | 0.0 | -2.0 | bregma | -4.5 | 0.0 | -2.0 | none |  | n |  | ML_ambiguous(0;0.3;3) | 3–6 month old C56Bl/6J mice were stereotaxically injected with Fluorogold (Thermo Fisher, H22845 ) for retrograde tracing into the dorsal raphe nucleus (AP -4.5 mm, ML 0 mm, DV -2.5mm, -2mm, -1.5mm), the IL region (AP + 1.66 mm, ML 0.3 mm left, DV -2mm, -1.8mm, -1.6mm) or the amygdala (AP -1.58 mm, ML -3 mm left, DV -3.8mm). | https://pubmed.ncbi.nlm.nih.gov/30677060/ | https://www.ncbi.nlm.nih.gov/pmc/?term=30677060
32358538 |  | mouse dorsal raphe nucleus | Dorsal raphe nucleus |  |  |  |  |  |  |  | none |  | n |  | ML_not_found | PA-Cre 3.0 AAV in vivo applications in mice. a Schematic representation of AAV-RAM-Tet-off-PA-Cre 3.0 application for targeting active neurons in mouse dorsal raphe nucleus using RAM element and optic cannula. b Experimental time course of AAV-RAM-Tet-off-PA-Cre 3.0 application in mouse dorsal raphe nucleus with restraint, which can activate c-fos, and BL illumination. c Representative immunofluorescent images of red fluorescent protein, mCherry (red) and neuronal activity marker, c-fos (green), in mouse dorsal raphe nucleus infected with AAV-RAM-Tet-off-PA-Cre 3.0 viruses in dark ( n = 2), and BL illumination ( n = 3). | https://pubmed.ncbi.nlm.nih.gov/32358538/ | https://www.ncbi.nlm.nih.gov/pmc/?term=32358538
32488015 |  | dorsal raphe nucleus (DRN; mid-caudal) | Dorsal raphe nucleus |  |  |  |  |  |  |  | none |  | n |  | ML_not_found | We injected 200–250 nl of AAV-FLEX-ArchT-GFP into the dorsal raphe nucleus (DRN; mid-caudal) using the coordinates described above. | https://pubmed.ncbi.nlm.nih.gov/32488015/ | https://www.ncbi.nlm.nih.gov/pmc/?term=32488015
32488015 |  | DR region | Dorsal raphe nucleus |  |  |  |  |  |  |  | none |  | n |  | ML_not_found | We injected AAV-Flex-DTA (Fig. 1a, b ) into the DR region of Sert-Cre::L10-GFP mice. | https://pubmed.ncbi.nlm.nih.gov/32488015/ | https://www.ncbi.nlm.nih.gov/pmc/?term=32488015
21074144 |  | dorsal striatum | Dorsal striatum |  |  |  |  |  |  |  | none |  | n |  | ML_not_found |  | https://pubmed.ncbi.nlm.nih.gov/21074144/ | https://www.ncbi.nlm.nih.gov/pmc/?term=21074144
21212837 |  | dorsal striatum | Dorsal striatum |  |  |  | bregma |  |  |  | none |  | n |  | ML_not_found | Retrograde tracers were injected under stereotaxic control into the dorsal striatum of mice using volume displacement (Figure 1 ). Histological references are modified from Paxinos and Franklin, 2004 with coordinates relative to bregma shown (mm). Injection sites and representative retrograde labeling . (A,B) The approximate central points for reported injections are indicated by ellipses. Inset numbers are position (mm) of the coronal plane relative to bregma, Anterior and posterior injection sites are displayed in (A,B) , respectively. Histological references are modified from Paxinos and Franklin, 2004 . | https://pubmed.ncbi.nlm.nih.gov/21212837/ | https://www.ncbi.nlm.nih.gov/pmc/?term=21212837
23354054 |  | dorsal striatum | Dorsal striatum | 0.5 | 0.0 | 2.5 | pial | 0.5 | 0.0 | -2.5 | none |  | n | DV->pos(below surface) | reference->pial | ML_not_found | A 30 gauge injection needle was lowered to the dorsal striatum (tip coordinates from Bregma: AP +0.5 mm, ML +1.5 mm for left, -1.5 mm for right, DV -2.5 mm from brain surface). A total volume of 0.8 µl of AAV vector per site was injected in 5-10 minutes. | https://pubmed.ncbi.nlm.nih.gov/23354054/ | https://www.ncbi.nlm.nih.gov/pmc/?term=23354054
26093169 |  | left dorsal striatum | Dorsal striatum |  |  |  |  |  |  |  | none |  | n |  | ML_not_found | we administered a unilateral injection of either α-syn PFF or recombinant α-syn solution into the left dorsal striatum at one or two sites. Sprague-Dawley rats received unilateral intrastriatal injections of either non-fibrillized recombinant α-syn or PFF mouse α-syn in 1- or 2- sites and were euthanized at 30, 60 or 180 days post-injection (pi). | https://pubmed.ncbi.nlm.nih.gov/26093169/ | https://www.ncbi.nlm.nih.gov/pmc/?term=26093169
26189679 |  | dorsal striatum | Dorsal striatum |  |  |  |  |  |  |  | none |  | n |  | ML_not_found | Mice with the fully encapsulated, chronically implanted wireless optofluidic devices interfaced to the dorsal striatum perform the rotarod test of sensorimotor control equally as well as cannula-implanted controls ( Figure 3C and Figure S5H ). | https://pubmed.ncbi.nlm.nih.gov/26189679/ | https://www.ncbi.nlm.nih.gov/pmc/?term=26189679
28351932 |  | dorsal striatum | Dorsal striatum | 0.2 | 0.0 | 2.6 | dura | 0.2 | 2.0 | 2.6 | llm |  | n | ML->0 (midline) |  | Two‐month‐old mice (male or female) were anesthetized with ketamine/xylazine (0.13/0.01 mg/g body weight; WDT/Bayer Health Care, Garbsen/Leverkusen, Germany) and stereotactically injected with 5 μl (25 μg) of PFFs into the dorsal striatum (coordinates relative to the bregma: +0.2 mm anterior, +2.0 mm from midline, +2.6 mm beneath the dura) of the right hemisphere using a 5‐μl Hamilton syringe. Injections were performed at 400 nl/min with the needle in place after injection for at least 5 min. D Injection site, 0.2 mm anterior of the bregma (star) and imaging area (box) as depicted in (E). | https://pubmed.ncbi.nlm.nih.gov/28351932/ | https://www.ncbi.nlm.nih.gov/pmc/?term=28351932
28467898 |  | dorsal striatum | Dorsal striatum |  |  |  |  |  |  |  | none |  | n |  | ML_not_found | For retrograde tracing experiments, CTB 647 was injected into the dorsal striatum of wild-type mice. For retrograde transsynaptic rabies virus tracing, AAV-CAG-Flex-TCB, AAV-CAG-Flex-RG, and SADΔG-EGFP(EnvA) were injected into the dorsal striatum of A2A-Cre mice. (C and D) Confocal images showing a retrogradely labeled area (C) following injection of the retrograde tracer CTB647 into the striatum and a retrogradely labeled GABAergic SOM + neuron in the motor cortex, visualized via FISH for Sst and Gad1/2 (D). (E–H) SOM + projecting neurons were identified by retrograde tracing with SADΔG-EGFP(EnvA) rabies virus. TCB was expressed Cre-dependently in the motor cortex of SOM Cre mice, and rabies virus was injected into the striatum. | https://pubmed.ncbi.nlm.nih.gov/28467898/ | https://www.ncbi.nlm.nih.gov/pmc/?term=28467898
29035751 |  | right dorsal striatum | Dorsal striatum | 0.2 | 0.0 | 2.6 | dura | 0.2 | 2.0 | 2.6 | llm |  | n | ML->0 (midline) |  | EVs isolated from the culture medium of α-synuclein overexpressing HEK cells were injected stereotaxically (5 μg EV protein equivalents in 3 μl saline injected during a 5 minute period) using a 10 μl Hamilton syringe into the right dorsal striatum (coordinates: +0.2 mm relative to Bregma; +2.0 mm from the midline; 2.6 mm beneath the dura); control animals received EVs isolated from the culture medium of HEK SNCA knockout cells. | https://pubmed.ncbi.nlm.nih.gov/29035751/ | https://www.ncbi.nlm.nih.gov/pmc/?term=29035751
30606046 |  | dorsal striatum | Dorsal striatum | 1.6 | 1.9 | 5.0 | bregma | 1.6 | 0.0 | 5.0 | disambig | 0.4;1;1.9 | n | ML from +/- (DV-disambig): 0.4;1;1.9 -> 1.9 |  | Guide cannulas were implanted bilaterally into the mPFC (rats, 3.0 mm rostral, ±1.0 mm lateral, 4.0 mm ventral to bregma; mice, 1.8 mm rostral, ±0.4 mm lateral, 2.5 mm ventral to bregma) or dorsal striatum (rats, 1.6 mm rostral, ±1.9 mm lateral, 5.0 mm ventral to bregma). | https://pubmed.ncbi.nlm.nih.gov/30606046/ | https://www.ncbi.nlm.nih.gov/pmc/?term=30606046
30932894 |  | dorsal striatum | Dorsal striatum | 0.2 |  | -2.6 | dura | 0.2 |  | -2.6 | none |  | n |  | ML_not_found | Prior to injection, 4-week-old mice (both sexes) were anesthetized with an isoflurane/oxygen mixture and injected unilaterally with either 2 μ L of PFFs (5 μ g/ μ l) or 2 μ L of PBS as a control in the dorsal striatum (coordinates from bregma: AP: +0.2 mm; DV: – 2.6 mm from dura) at a rate of 0.2 μ L/min using a glass capillary attached to a 10 μ L Hamilton syringe. | https://pubmed.ncbi.nlm.nih.gov/30932894/ | https://www.ncbi.nlm.nih.gov/pmc/?term=30932894
31308794 |  | dorsal striatum | Dorsal striatum | 1.0 |  | -3.6 | bregma | 1.0 |  | -3.6 | none |  | n |  | ML_not_found | While the mouse head was held in the stereotaxic device (Stoelting Company, Wood Dale, IL, USA), 1.5 µl (18 ng of siRNA) of siRNA mixture per each side of the dorsal striatum (AP, +1.0; DV, −3.6 mm) was injected at the rate of 0.2 µl/min using a 30 G needle. | https://pubmed.ncbi.nlm.nih.gov/31308794/ | https://www.ncbi.nlm.nih.gov/pmc/?term=31308794
31449520 |  | dorsal striatum | Dorsal striatum |  |  |  |  |  |  |  | none |  | n |  | ML_not_found | Unilateral injection in the dorsal striatum at a low dose (1.5μg in 0.5 μL) ( Fig 6A ) was performed in order to produce a partial loss of dopaminergic cell bodies ( Fig 6B ). | https://pubmed.ncbi.nlm.nih.gov/31449520/ | https://www.ncbi.nlm.nih.gov/pmc/?term=31449520
32487763 |  | right dorsal striatum | Dorsal striatum | 0.4 | 2.0 | -2.6 | bregma | 0.4 | 2.0 | -2.6 | llm |  | n |  | ML_noncoord?(2 μl) | For stereotactic surgeries, 5 μg of PFFs in 2 μl PBS was injected into the right dorsal striatum (AP +0.4, ML +2, DV −2.6) of fully anesthetized animals (100 mg/kg ketamine and 10 mg/kg xylazine, i.p.) on stereotactic frames (Kopf Instruments) through a 34-gauge cannula using a 10-μl Hamilton syringe (flow rate of 0.1 μl/min). | https://pubmed.ncbi.nlm.nih.gov/32487763/ | https://www.ncbi.nlm.nih.gov/pmc/?term=32487763
19864562 |  | DLS | Dorsolateral striatum |  |  |  |  |  |  |  | none |  | n |  | ML_not_found | As the size of the targeted structures is not uniform, rats received 3 injections of 1 μl of solution per side in the DLS and 2 injections of 1 μl per side for the DMS at a rate of 0.5 μl/min and the injectors remained in place for 10 addition… | https://pubmed.ncbi.nlm.nih.gov/19864562/ | https://www.ncbi.nlm.nih.gov/pmc/?term=19864562
25852508 |  | striatum | Dorsolateral striatum | 0.5 | 2.0 | -3.0 | bregma | 0.5 | 0.0 | -3.0 | disambig | 0.4;2 | n | ML from +/- (DV-disambig): 0.4;2 -> 2 |  | Custom-designed stainless steel injection cannulas (23G) were bilaterally implanted into the mPFC (AP 1.90 mm, ML ± 0.40 mm, and DV −2.00 mm; Figure 5A ) and the striatum (AP 0.50 mm, ML ± 2.00 mm, and DV −3.00 mm; Figure 5D ) (Paxinos and Franklin, 2001 ). Once inserted, the injection cannula protruded from the guide cannula1 mm, thus reaching the prelimbic mPFC or the dorso-lateral striatum. | https://pubmed.ncbi.nlm.nih.gov/25852508/ | https://www.ncbi.nlm.nih.gov/pmc/?term=25852508
29375331 |  | dorsolateral striatum | Dorsolateral striatum |  |  |  |  |  |  |  | none |  | n |  | ML_not_found | we injected an adeno-associated virus (AAV1) containing a double-floxed inverted open reading frame encoding a fusion of channelrhodopsin-2 and mcherry fluorescent protein (ChR2-mcherry) into the dorsolateral striatum of D 1 -Cre (Gong et al., 2007 ) and A 2A -Cre mice (Durieux et al., 2009 ), respectively. Figure 1 Pattern of expression of the ChR2-mCherry in DLS neurons after AAV injections. (A) Site of injection of AAVs into the DLS of D 1 -Cre mice and expression of ChR2 in the striatum, the entopeduncular nucleus (EP), and substantia nigra pars reticulata (SNr) indicating specificity for the striatonigral pathway. (B) Site of injection of AAVs into the DLS of A 2A -Cre mice and expression of ChR2 in the striatum and the globus pallidus externus (GP) indicating specificity for the striatopallidal pathway. | https://pubmed.ncbi.nlm.nih.gov/29375331/ | https://www.ncbi.nlm.nih.gov/pmc/?term=29375331
30671536 |  | dorsolateral striatum (DLS) | Dorsolateral striatum |  |  |  |  |  |  |  | none |  | n |  | ML_not_found | A total amount of 400 nl of an adeno-associated virus (AAV) serotype 9 harboring GCaMP6s construct (AAV9-syn-flex-GCaMP6s; … The dorsolateral striatum (DLS) of ChAT-cre mice was transfected with AAVs harboring cre-dependent CGaMP6s, causing this GECI to express selectively in CINs. | https://pubmed.ncbi.nlm.nih.gov/30671536/ | https://www.ncbi.nlm.nih.gov/pmc/?term=30671536
31837424 |  | dorsolateral striatum | Dorsolateral striatum | 0.2 | 2.0 | -2.6 | bregma | 0.2 | 0.0 | -2.6 | high | 2 | n | ML from +/- (high): 2 | ML_noncoord?(2 μL) | Animals were bilaterally injected with 2 μL (per side) of 300 μM sonicated fibrils, or 300 μM monomeric α-synuclein, or phosphate-buffered saline (PBS) as controls. Solutions were injected at a constant rate of 0.5 μL/ min and the needle left in place for 5 min followed by slowly withdrawing the needle. Coordinates for the striatum were + 0.2 mm AP, ± 2.0 mm ML, −2.6 mm DV. Mice received bilateral injections into the dorsolateral striatum with α-synuclein fibrils or controls. | https://pubmed.ncbi.nlm.nih.gov/31837424/ | https://www.ncbi.nlm.nih.gov/pmc/?term=31837424
20394060 |  | dorsomedial hypothalamus (DMH) | Dorsomedial nucleus of the hypothalamus |  |  |  |  |  |  |  | none |  | n |  | ML_not_found | To demonstrate the utility of this approach, the virus was injected unilaterally into the dorsomedial hypothalamus (DMH) of mice that express Cre in neurons expressing the leptin receptor. | https://pubmed.ncbi.nlm.nih.gov/20394060/ | https://www.ncbi.nlm.nih.gov/pmc/?term=20394060
32376858 |  | bilateral dmPFC | Dorsomedial prefrontal cortex |  |  |  |  |  |  |  | none |  | n |  | ML_not_found | For this, we stereotaxically injected an adeno-associated viral vector carrying channelrhodopsin 2 (AAV-ChR2) tagged with enhanced green fluorescent protein (eGFP) under control of CaMKII promoter into bilateral dmPFC of mice (Fig. | https://pubmed.ncbi.nlm.nih.gov/32376858/ | https://www.ncbi.nlm.nih.gov/pmc/?term=32376858
19864562 |  | DMS | Dorsomedial striatum |  |  |  |  |  |  |  | none |  | n |  | ML_not_found | As the size of the targeted structures is not uniform, rats received 3 injections of 1 μl of solution per side in the DLS and 2 injections of 1 μl per side for the DMS at a rate of 0.5 μl/min and the injectors remained in place for 10 addition… | https://pubmed.ncbi.nlm.nih.gov/19864562/ | https://www.ncbi.nlm.nih.gov/pmc/?term=19864562
22902719 |  | dorsomedial striatum | Dorsomedial striatum | 0.75 | 1.5 | -3.0 | bregma | 0.75 | 0.0 | -3.0 | high | 1.5 | n | ML from +/- (high): 1.5 |  | Animals were placed in a stereotaxic frame and 26-gauge microinjection needles were inserted through a burr hole bilaterally into the dorsomedial striatum (coordinates from bregma: anterior 0.75, medial-lateral ±1.5, ventral −3.0 mm) of D1/D2-Cre mice to deliver 1.0 μL of either AAV-EF1-DIO-ChR2(H124R)-eYFP or AAV-EF1-DIO-eYFP ~1012 IU/mL). Injections were performed using a 1 μL Hamilton syringe through a hydraulic pump (Harvard Instruments) and took place over 10 min followed by 10 min of recovery. | https://pubmed.ncbi.nlm.nih.gov/22902719/ | https://www.ncbi.nlm.nih.gov/pmc/?term=22902719
24411738 |  | mediodorsal striatum | Dorsomedial striatum | 1.3 | 1.4 | -3.2 | bregma | 1.3 | 0.0 | -3.2 | disambig | 1.4;2 | n | ML from +/- (DV-disambig): 1.4;2 -> 1.4 |  | Viruses were bilaterally delivered at an average rate of 100 nl/min using glass pipettes (10–15 µm). Two sites of injections were used into the mediodorsal striatum to allow for a broad expression (site A: AP +1.3, ML ± 1.4, DV −3.2; site B: AP +0.8, ML ± 2.0, DV −3.4). 0.4–0.5 µl of AAV2/1-cmv-Kir2.1 AAA -ires-HRGFP, AAV2/1-cmv-HRGFP, AAV2/1-syn-DIO-Kir2.1 AAA -ires-mCherry and AAV2-ef1α-DIO-mCherry, and 0.5–1.0 µl of AAV2/1-cmv-Kir2.1 Wt -ires-HRGFP (lower titer) were injected per site. | https://pubmed.ncbi.nlm.nih.gov/24411738/ | https://www.ncbi.nlm.nih.gov/pmc/?term=24411738
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
