asathyanesan/Neuroinjector/models/Currrent/Parts/SyringeAsm.SLDASM

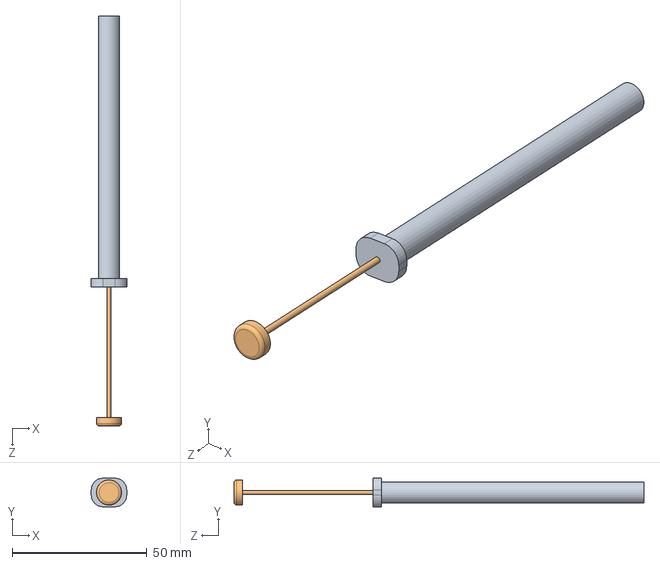
[picture p8: CAD file, 2026-08-05]
models/Currrent/Parts/SyringeAsm.SLDASM
13.2 x 10.7 x 152.3 mm
Plunger
syringe
