asathyanesan/Neuroinjector/models/Currrent/Parts/Assem1.SLDASM

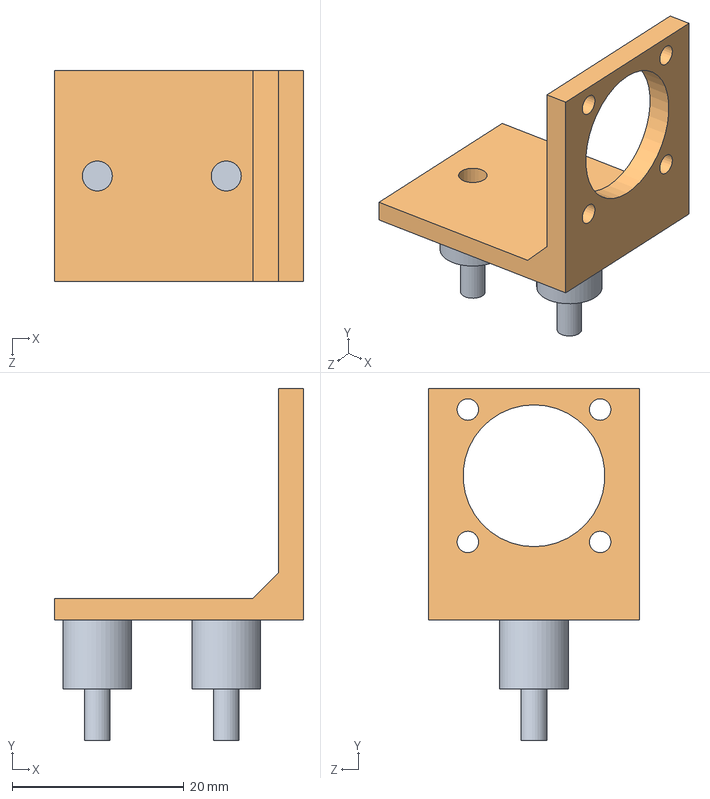
[picture p9: CAD file, 2026-08-05]
models/Currrent/Parts/Assem1.SLDASM
29.0 x 41.0 x 24.5 mm
Nema8 Mount
Vibration Idolator x 2
