asathyanesan/Neuroinjector/models/Currrent/3DPrintedParts/PlungerDriverB.SLDPRT

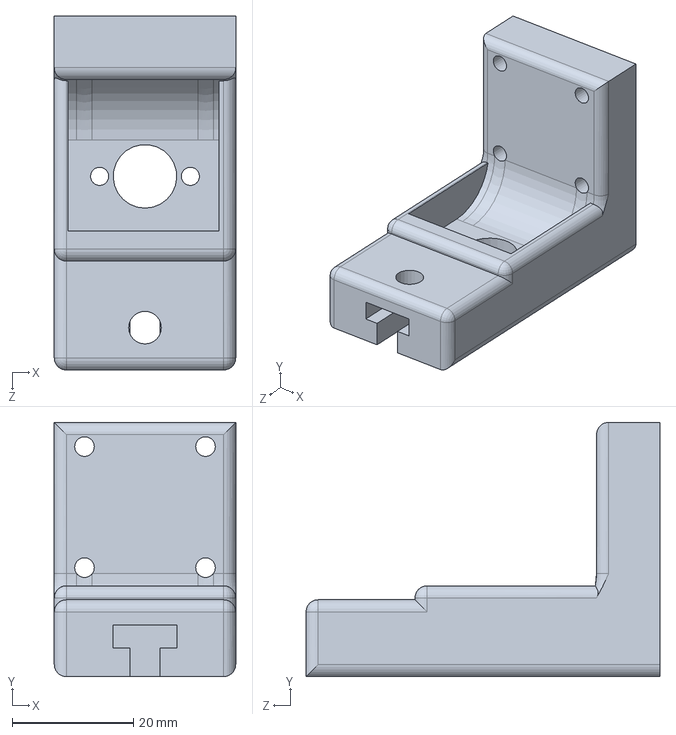
[picture p10: CAD file, 2026-08-05]
models/Currrent/3DPrintedParts/PlungerDriverB.SLDPRT
30.0 x 42.0 x 58.5 mm
