asathyanesan/Neuroinjector/models/Currrent/Parts/Coupling.SLDPRT

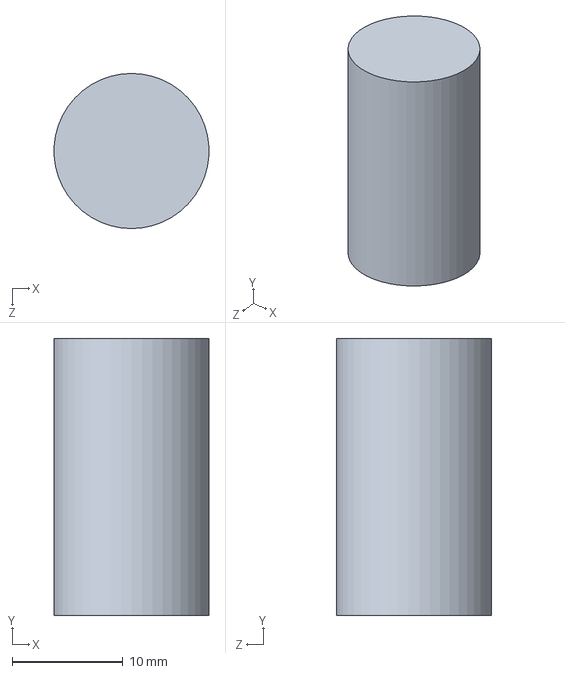
[picture p11: CAD file, 2026-08-05]
models/Currrent/Parts/Coupling.SLDPRT
14.0 x 25.0 x 14.0 mm
