asathyanesan/Neuroinjector/models/Currrent/3DPrintedParts/RetentionMechanism.SLDPRT

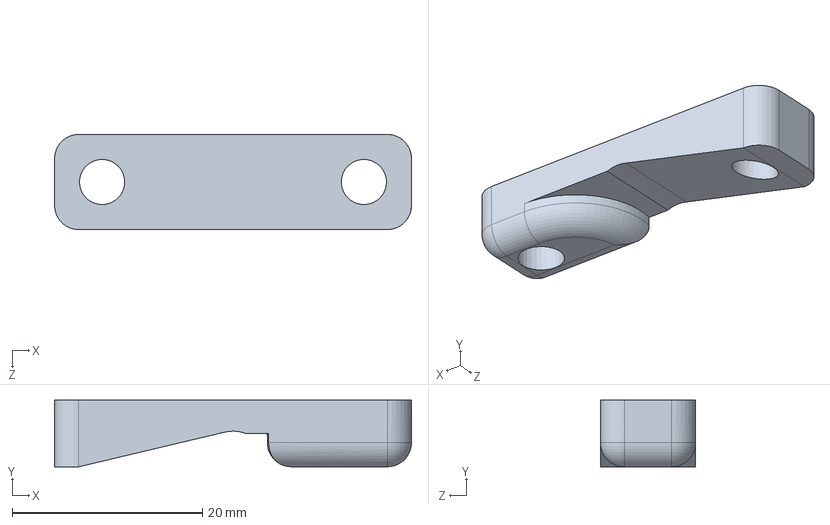
[picture p12: CAD file, 2026-08-05]
models/Currrent/3DPrintedParts/RetentionMechanism.SLDPRT
37.5 x 7.00 x 10.0 mm
