asathyanesan/Neuroinjector/STL/Motor Housing.STL

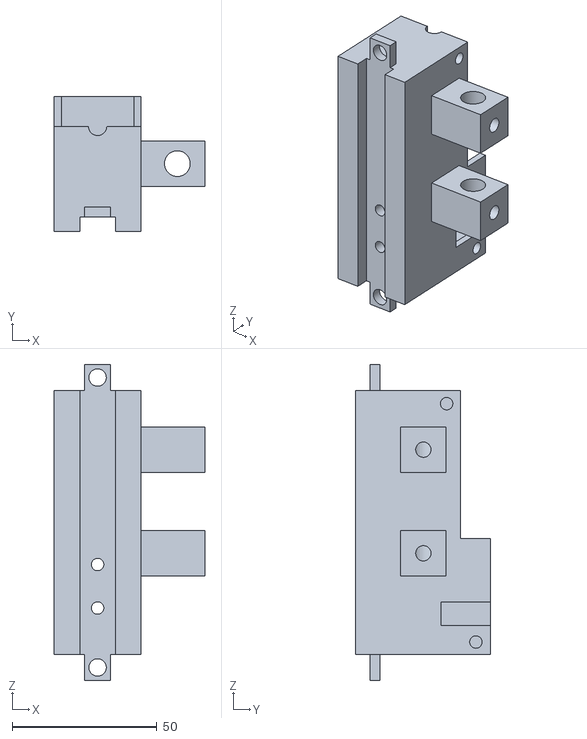
[picture p13: CAD file, 2026-08-05]
STL/Motor Housing.STL
52.0 x 46.5 x 109.0
