asathyanesan/Neuroinjector/models/Currrent/Parts/8HS11-0204S.SLDPRT

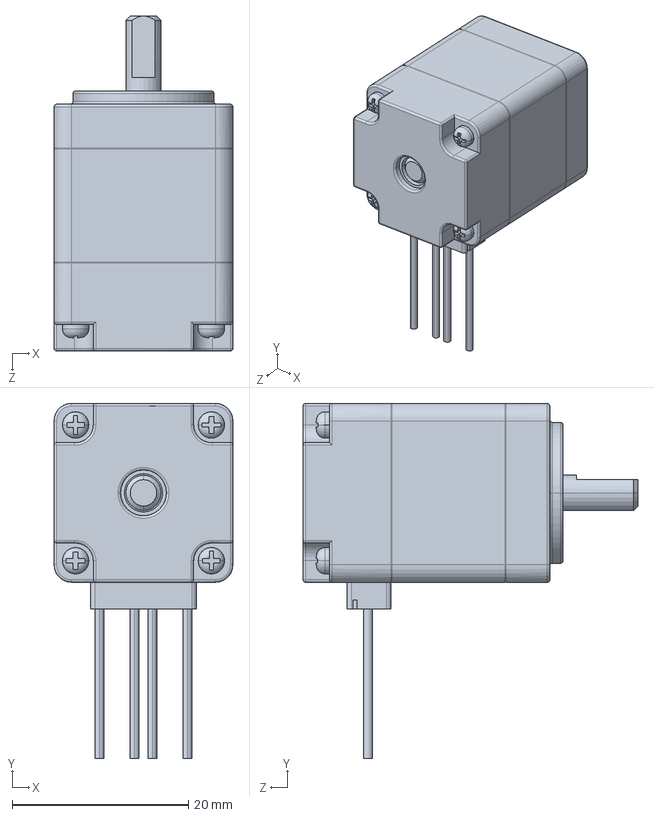
[picture p14: CAD file, 2026-08-05]
models/Currrent/Parts/8HS11-0204S.SLDPRT
20.3 x 40.3 x 38.0 mm
