asathyanesan/Neuroinjector/models/Currrent/3DPrintedParts/Cover.SLDPRT

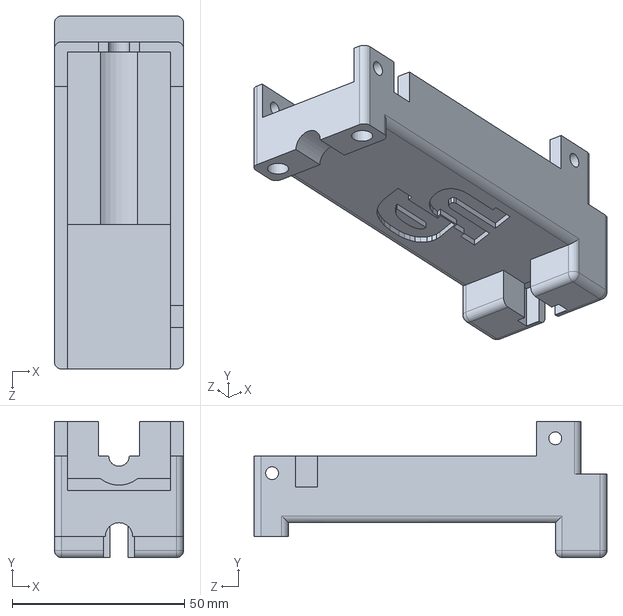
[picture p15: CAD file, 2026-08-05]
models/Currrent/3DPrintedParts/Cover.SLDPRT
37.5 x 39.5 x 102.5 mm
