asathyanesan/Neuroinjector/models/Currrent/Parts/Nema8 Mount.SLDPRT

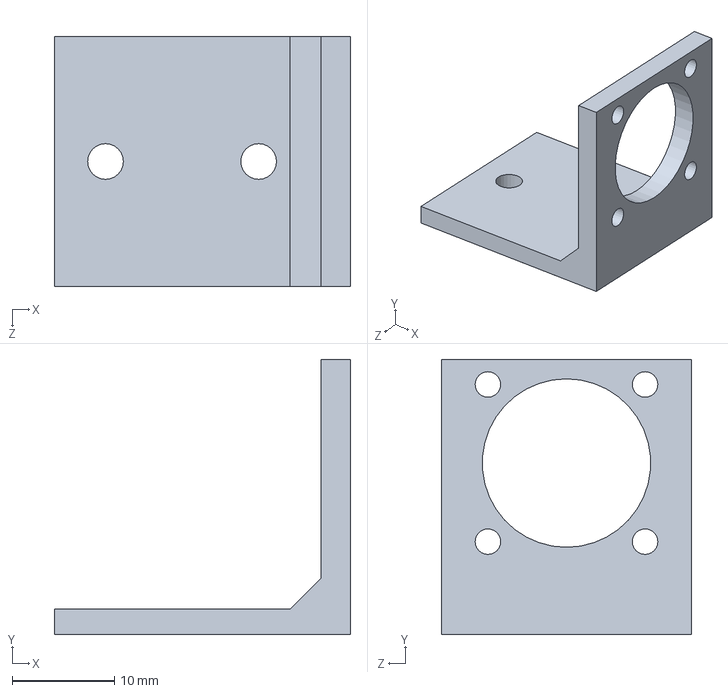
[picture p16: CAD file, 2026-08-05]
models/Currrent/Parts/Nema8 Mount.SLDPRT
29.0 x 27.0 x 24.5 mm
