asathyanesan/Neuroinjector/models/Currrent/Parts/Plunger.SLDPRT

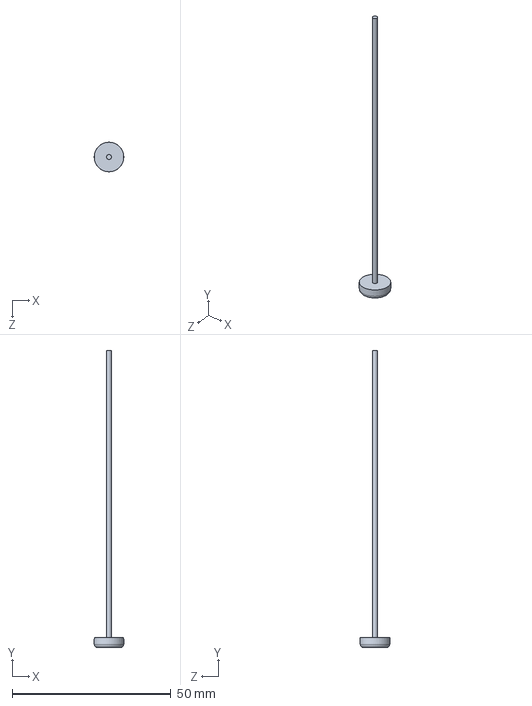
[picture p17: CAD file, 2026-08-05]
models/Currrent/Parts/Plunger.SLDPRT
9.33 x 93.7 x 9.33 mm
