asathyanesan/Neuroinjector/models/Currrent/Parts/Rail.SLDPRT

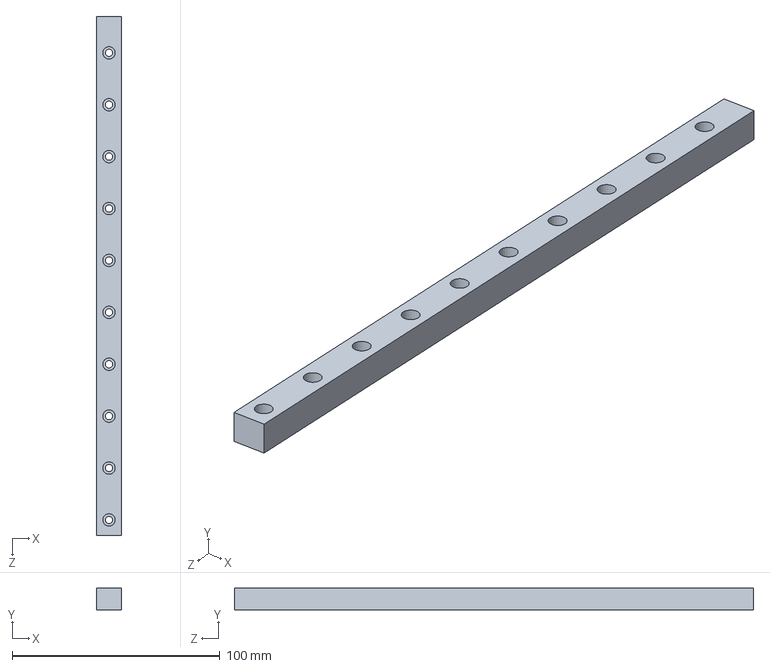
[picture p18: CAD file, 2026-08-05]
models/Currrent/Parts/Rail.SLDPRT
12.0 x 10.5 x 250.0 mm
