asathyanesan/Neuroinjector/models/Currrent/Parts/syringe.SLDPRT

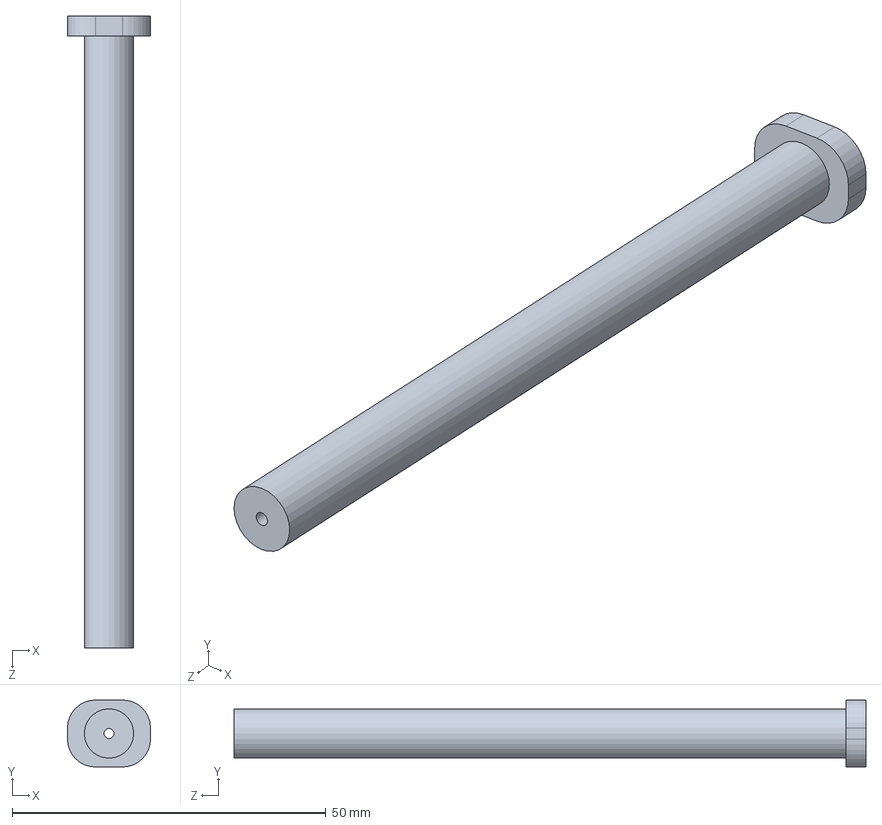
[picture p19: CAD file, 2026-08-05]
models/Currrent/Parts/syringe.SLDPRT
13.2 x 10.7 x 100.7 mm
