asathyanesan/Neuroinjector/models/Currrent/Parts/Vibration Idolator.SLDPRT

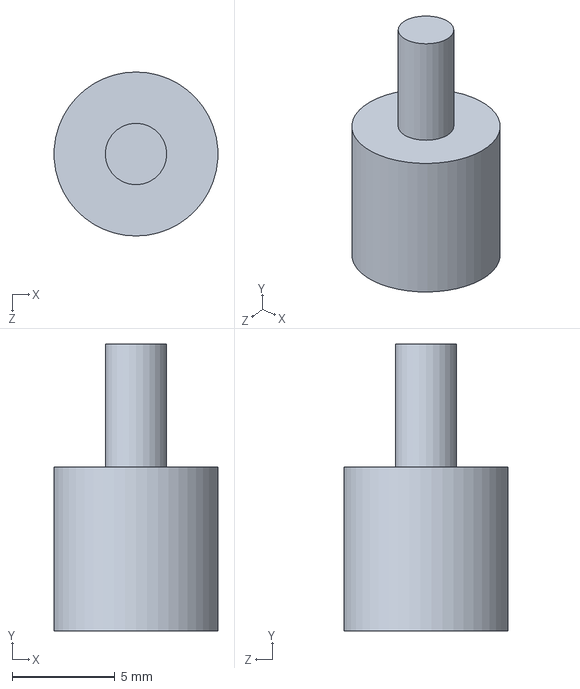
[picture p20: CAD file, 2026-08-05]
models/Currrent/Parts/Vibration Idolator.SLDPRT
7.98 x 14.0 x 8.00 mm
