asathyanesan/Neuroinjector/models/Currrent/Parts/Sliding Block.SLDPRT

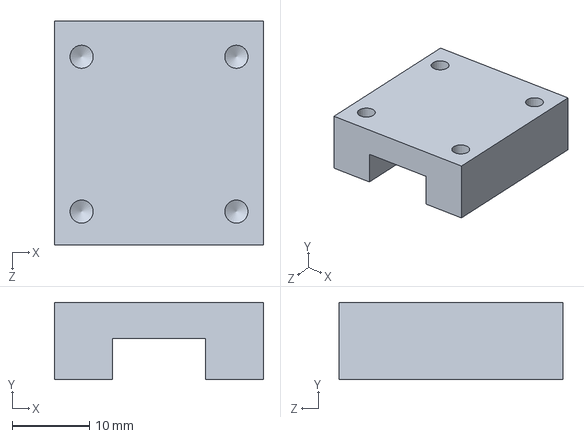
[picture p21: CAD file, 2026-08-05]
models/Currrent/Parts/Sliding Block.SLDPRT
27.0 x 10.0 x 28.9 mm
