asathyanesan/Neuroinjector/(list of files, cad)

Other CAD files:
GCode/OwenBeer11-3.gcode.3mf
STL/PlungerDriverB.STL
GCode/OwenBeer10-30.gcode.gcode.3mf
models/Currrent/3DPrintedParts/Motor Housing.SLDPRT
STL/RetentionMechanism.STL
STL/Nema8 Mount.STL
STL/Cover.STL
models/Currrent/Parts/6350K681_Flange Nut with 1 8 -41.7 Thread Size for Ultra-Precision Lead Screw.SLDPRT
models/Currrent/Parts/6350K685_Ultra-Precision Lead Screw.SLDPRT
