asathyanesan/Neuroinjector/validation/osc_score_detail.csv

pmid | region | gt_ap | gt_ml | gt_dv | osc_ap | osc_ml | osc_dv | ap_err | ml_err | dv_err | within_tol_3axis
20092560 | ACB | 1.4 | 1.26 | 4.2 | 1.4 | 1.26 | 4.2 | 0.0 | 0.0 | 0.0 | y
20856811 | ACB | 1.7 | 0.75 | 4.75 | 1.7 | 0.75 | 4.75 | 0.0 | 0.0 | 0.0 | y
20962330 | ACB | 1.3 | 0.9 | 4.7 | 1.3 | 0.9 | 4.7 | 0.0 | 0.0 | 0.0 | y
21508225 | ACB | 1.2 | 1.5 | 6.0 | 1.2 | 1.5 | 6.0 | 0.0 | 0.0 | 0.0 | y
21508225 | ACB | 1.2 | 1.0 | 5.8 | 1.2 | 1.5 | 6.0 | 0.0 | 0.5 | 0.2 | n
22082989 | ACB | 1.3 | 1.3 | 4.4 | 1.3 | 1.3 | 4.4 | 0.0 | 0.0 | 0.0 | y
25130590 | ACB | 1.1 | 0.5 | 4.5 | 1.1 | 0.5 | 4.5 | 0.0 | 0.0 | 0.0 | y
26471420 | ACB | 1.5 | 0.8 | 3.6 | 1.5 | 0.8 | 3.6 | 0.0 | 0.0 | 0.0 | y
29307710 | ACB | 1.5 | 0.55 | 4.7 | 1.5 | 0.55 | 4.7 | 0.0 | 0.0 | 0.0 | y
29307710 | ACB | 0.98 | 1.8 | 4.92 | 0.98 | 1.8 | 4.92 | 0.0 | 0.0 | 0.0 | y
29458998 | ACB | 1.65 | 0.92 | 4.8 | 1.65 | 0.92 | 4.8 | 0.0 | 0.0 | 0.0 | y
29477921 | ACB | 1.2 | 1.0 | 4.5 | 1.2 | 1.0 | 4.5 | 0.0 | 0.0 | 0.0 | y
31660086 | ACB | 1.54 | 0.8 | 4.4 | 1.54 | 0.8 | 4.4 | 0.0 | 0.0 | 0.0 | y
31668382 | ACB | 1.6 | 0.6 | 4.25 | 1.6 | 1.0 | 4.5 | 0.0 | 0.4 | 0.25 | n
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
