asathyanesan/Neuroinjector/(commit log)

2026-08-05 Clean slate: passages-only RAG, corpus local-only
    [6350K681_Flange Nut with 1 8 -41.7 Thread Size for Ultra-Precision Lead Screw.SLDPRT, 6350K685_Ultra-Precision Lead Screw.SLDPRT, 8HS11-0204S.SLDPRT, Assem1.SLDASM, Coupling.SLDPRT, Cover.SLDPRT, Cover.STL, Motor Housing.SLDPRT]
2026-08-15 Ship OSC structured coordinates (92% validated) + validation record
    [osc_injection_score_v31.csv, osc_score_detail.csv, verification_full_corrected.csv, verification_sheet.csv]
2026-08-29 Update injection-structured data and validation scores
    - Modified target regions in injection-structured.json to specify "hippocampal area CA1" and updated corresponding CCF regions.
    - Adjusted values in osc_injection_score_v31.csv for consistency and accuracy, including corrections to numerical values and formatting.
    - Enhanced score_extraction_v3.1.ipynb for clarity and consistency in markdown, updated execution counts, and added output messages for better tracking of processing steps.
    [osc_injection_score_v31.csv]
